KarolKaim/-masterThesis/README.md

# -masterThesis
This repository track the whole process of writing masterThesis
