KarolKaim/-masterThesis/usefulDocuments/listaZakopow.odt

Lista zakupów:

1. Przyciski
- 2x rezystory 330, 33k
- 2x kondensatory ~470 nF
- Przewód dwużyłowy 4 m
- płytka do lutowania
2. Zasilanie
- pakiet lipo 2s
- przewody men-men krótkie
- przewód do serwomechanizmu
3. Magnesy
- 2x rezystor 330, 10k
- 2x kondenstator 100nF
6. sdf
