KarolKaim/-masterThesis/usefulDocuments/komplementarny.pdf

### Katedra Cybernetyki i Robotyki, Wydział Elektroniki

Seria: SPR nr 3/2014
— Grant S30080 —

Filtracja komplementarna
w inercyjnych czujnikach orientacji

Marek Wnuk

Słowa kluczowe:
orientacja,
zyroskop, ˙
akcelerometr,
dalmierz,
mikrokontroler,
filtracja.

Wrocław, 2014-09-25

### Spis tresci ´

1 Wprowadzenie | 3

### 2 Przegl ֒

ad czujnikow scalonych ´ | 3
2.2 Zyroskopy | | 3 ˙
2.4 Czujniki cisnienia | | 4 ´
3 Filtry uzywane do pomiaru orientacji ˙ | 5
4 Przykłady realizacji czujnikow orientacji ´ | 6

4.2 Przykład 2D - samopoziomuj ֒

aca si֒

### 5 Czujnik pochylenia platformy dwukołowej wzgl֒

edem podłoza | 11 ˙
6 Podsumowanie | 14

### 1 Wprowadzenie

Pomiar orientacji jest konieczny do sterowania robotami mobilnymi. W szczegolny spos ´ | ob dotyczy ´
to obiektow lataj ´
֒

acych, poruszaj ֒

acymi si֒

e w przestrzeni trojwymiarowej. W takim przypadku korzy- ´ sta si֒

e z systemu AHRS (ang. Attitude and Heading Reference System). Jest on oparty na całkowaniu chwilowych pr֒

edkosci k ´
֒

atowych zmian orientacji, mierzonych przy pomocy zyroskop ˙ ow. Jako po- ´ miary bezwzgl֒

edne orientacji mozna wykorzysta ˙ | c azymut magnetyczny mierzony magnetometrami ´
oraz kierunek siły grawitacji mierzony akcelerometrami. W tym przypadku mowimy o systemie czuj- ´
nikow MARG (ang. ´ | Magnetic, Angular Rate, and Gravity), a urz ֒

adzenie, ktore je zawiera jest zwane ´ IMU (ang. Inertial Measurement Unit).
W praktyce robotycznej cz ֒

esto mamy do czynienia z ograniczeniem wymiaru przestrzeni do dwoch ´ lub nawet jednego, co prowadzi do uproszczenia zadania pomiaru orientacji. Przykładem problemu dwuwymiarowego jest pomiar pochylenia platformy mobilnej poruszaj ֒

acej si֒

e po płaszczyznie, a ´
jeden stopien swobody pozostaje w przypadku pomiaru pochylenia korpusu ´ | robota balansuj ֒
acego.

### 2 Przegl ֒

### ad czujnikow scalonych ´

Czujniki mikroelektromechaniczne (MEMS - ang. Micro Electro-Mechanical Systems) s ֒

a uzywane ˙
głownie do pomieru pr ´
֒
edkosci i przyspiesze ´ | n. S ´
֒

a one coraz powszechniej dost֒

epne w ofercie wiod ֒

acych producentow układ ´ ow scalonych. Dost ´
֒

epne s ֒

a tez czujniki pola magnetycznego (magnetometry) ˙ i czujniki cisnienia (barometry, altimetry). ´ Powszechnie stosuje si֒

e ł ֒

aczenie roźnych funkcji w jednym układzie, co pozwala zmniejszy ˙ | c roz- ´
miary urz ֒
adzen oraz pob ´ | or energii. Dost ´
֒

epne s ֒

a roźne kombinacje (akcelerometr + ˙ | zyroskop, akcele- ˙
rometr + magnetometr, akcelerometr + zyroskop + magnetometr). Wsp ˙ | ołczesne czujniki o wyj ´ | sciach ´
cyfrowych wyposazone s ˙
֒

a we wbudowane programowalne filtry antyaliasingowe a cz ֒

esto zawieraj ֒

a
własn ֒

a jednostk ֒

e obliczeniow ֒

a, pozwalaj ֒

ac ֒

a zaimplementowac wybrany algorytm obliczania orien- ´ tacji bezposrednio w układzie (np. MPU6050 [27]) ´

### 2.1 Akcelerometry

Pomiar przyspieszenia odbywa si֒

e przez pomiar pojemnosci kondensatora wytworzonego w mono- ´ litycznym krzemie. Jego okładki przesuwaj ֒

a si֒

e wzgl֒

edem siebie przy odkształceniu elementow´ spr֒

ezystych pod wpływem siły działaj ˙
֒

acej na mas֒

e. Sygnał wyjsciowy akceleromtru mo ´ | ze by ˙ | c analo- ´
gowy lub cyfrowy. Typowe synchroniczne interfejsy cyfrowe to SPI (ang. Serial Peripheral Interface) i IIC (ang. Inter-Integrated Circuit). Przykładowe akcelerometry to ADXL345 [13], MMA8652FC [25].

### 2.2 Zyroskopy ˙

Pomiar pr֒

edkosci obrotowej opiera si ´
֒

e na zjawisku siły Coriolisa, wynikaj ֒

acej ze złozenia dw ˙ | och ´
ruchow pewnej masy, z kt ´ | orych co najmniej jeden jest obrotowy. W akcelerometrach ME ´ | MS jednym
ze składowych ruchow s ´
֒

a drgania elementu struktury czujnika wymuszone dzi֒

eki efektowi piezoelek-
trycznemu. Wartosć siły Coriolisa jest mierzona analogicznie jak w akcelerome ´ | trze, podobne s ֒

a tez˙
interfejsy obu rodzajow czujnik ´ | ow. Przykłady ´ | zyroskop ˙ | ow to L3G4200 [20], MAX21000 [24]. ´

### 2.3 Magnetometry

Do pomiaru kierunku i nat֒ ezenia pola magnetycznego Ziemi stosuje si ˙
֒

e czujniki magnetorezystywne, oparte na efekcie Gaussa (Thomsona). Wyst֒

epuj ֒

a one w postaci układow scalonych, najcz ´
֒

esciej ´
zapewniaj ֒

acych pomiar trzech prostopadłych składowych wektora. Ich inerfejsy s ֒

a analogiczne, jak
w czujnikach inercyjnych. Popularne magnetometry to np. HMC5883L [18], MAG3110 [23].

### 2.4 Czujniki cisnienia ´

Czujniki bezwzgl֒

edne cisnienia korzystaj ´
֒

a ze zjawiska piezorezystywnego. Po jednj stronie krzemowej membrany jest proźnia, na drug ˙
֒

a działa mierzone cisnienie. wynik pomiaru jest udost ´
֒

epniany
w postaci napi֒

eciowej, a coraz cz ֒

asciej dodatkowo filtrowany i przekazywany przez SPI lub IIC. ´ Cz ֒

esto spotyka si֒

e dodatkowo pomiar temperatury. Przykłady takich czujnikow to BMP085 [14], ´ MPL3115A2 [26].

### 2.5 Moduły IMU

IMU (ang. Inertial Measurement Unit) zawiera czujniki dostarczaj ֒

ace pomiarow wielko ´ | sci fizycz- ´
nych okreslaj ´
֒

acych parametry połozenia, pr ˙
֒
edkosci i przyspiesze ´ | n, kt ´ | orym podlega wyposa ´ | zony w ˙
nie obiekt. Pozwala to na obliczanie aktualnej orientacji i połozenia. ˙
Czujniki te, to zazwyczaj akcelerometry, zyroskopy, magnetometry. Ka ˙ | zdy z nich mo ˙ | ze da ˙ | c informa- ´
cje trojwymiarow ´
֒

a (3D), co razem daje 9 stopni swobody (9 DOF - Degrees of Freedom). Na rys. 1 przedstawiono testowane moduły IMU. Po lewej mamy popularny magnetometr HMC5883L (3DOF) i moduł GY-521 z układem MPU6050 [27] (3DOF akcelerometr i 3DOF zyroskop). W ˙ srodku znajduje si ´
֒

e moduł GY-80 (10DOF) z trojwymiarowymi czujnikami przyspieszenia (ADXL345), ´ pr֒

edkosci obrotowej (L3G4200), pola magnetycznego (HMC5883L) ora ´ | z cisnienia (BMP085). Po ´
prawej znajduje si֒ | e moduł z układem z rodziny iNEMO (LSM9DS0) [21], dostarczaj ֒

acym pomiarow´
przyspieszenia, pr֒

edkosci obrotowej i pola magnetycznego (9 DOF). ´

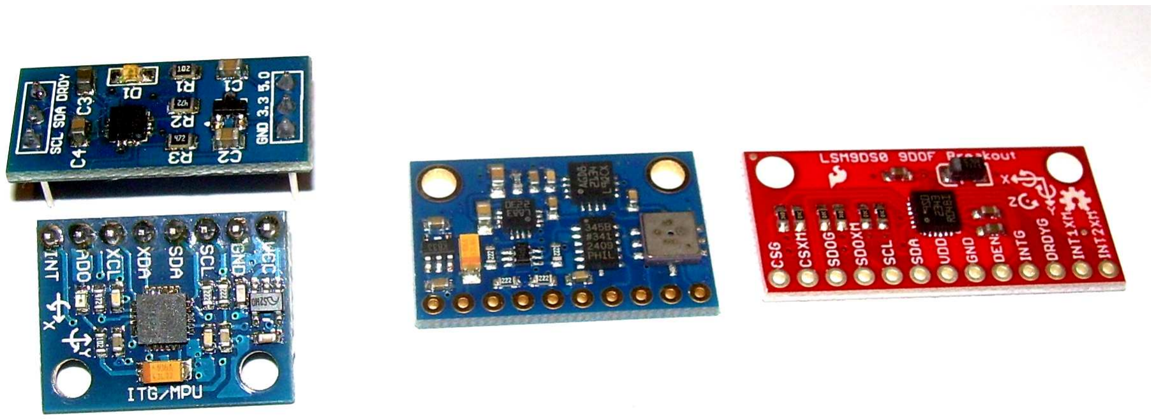
[picture p34: figure]

Rysunek 1: Moduły IMU uzywane w badaniach ˙

Dziesi ֒

atym stopniem swobody nazywa si֒ e w popularnych zastosowaniach wysokosć nad poziomem ´ morza (ang. Altitude), mierzon ֒

a bezwzgl֒

ednym czujnikiem cisnienia atmosferycznego. ´

### 3 Filtry uzywane do pomiaru orientacji ˙

Pomiar orientacji na podstawie odczytu sygnałow z kilku czujnik ´ | o´w (w pełnym zakresie obejmuje to ´
trzy czujniki 3D - akcelerometr, zyroskop i magnetometr) wymaga dokonywania filtracji zakł ˙ | oce ´ n o ´
roźnym charakterze i fuzji danych. W ˙ | sr´ od wielu podej ´ | sć do tego problemu najcz ´
֒

esciej spotyka si ´
֒

e
filtr Kalmana, filtr komplementarny i filtr Madgwicka.

### 3.1 Filtr Kalmana

Filtr Kalmana [11] dokonuje iteracyjnej estymacji procesu w układzie ze sprz ֒

ezeniem zwrotnym. W ˙
kadym kroku wykonywane s naprzemiennie dwie operacje: estymacja stanu procesu i sprz ֒

ezenie ˙
zwrotne w postaci pomiarow zaburzonych szumem. ´
Faza predykcji stanu (aktualizacja czasowa) estymuje kolejny, przewidywany stan i okresla estymat ´
֒

e
kowariancji bł֒

edu, daj ֒

ac estymat֒

e a priori.
Faza korekcji (aktualizacja pomiarowa) wykorzystuje biez˙
֒

ace pomiary by uzyskac poprawion ´
֒

a estymat֒

e a posteriori.
Filtr Kalmana jest od dawna uzywany przy fuzji danych sensorycznych, zwłaszcza w zastos ˙ | owaniach
do nawigacji powietrznej [3]. Wspołczesne implementacje s ´
֒

a rownie ´ z popularne [6, 16, 1]. ˙

### 3.2 Filtr Madgwicka

W 2010 roku R. Madgwick opublikował raport [7], w ktorym przedstawił zar ´ | owno teori ´
֒

e, jak i elementy implementacji nowego filtru dla IMU i MARG. Jest on oparty na kwaternionowej reprezentacji obrotow. Zawiera on kompensacj ´
֒

e zniekształcen dla magnetometru i kompensacj ´
֒

e dryfu zyroskopu. ˙
Wykorzystuje analitycznie wyprowadzony i zoptymalizowany algorytm najszybszego spadku w celu wyznaczenia kierunku bł֒
| edu zyroskopu przez r ˙ | oźniczkowanie kwaternionu. ˙
Przedstawione wyniki wskazuj ֒
| | a na zalety tej metody (mały koszt obliczeniowy, efektywnosć przy ´
niewielkiej cz ֒
estotliwosci pr ´ | obkowania, łatwo ´ | sć strojenia algorytmu - 1 lub 2 parametry). ´
Autor dol ֒

aczył rownie ´ z swoj ˙
֒

a implementacj֒

e filtru Mahony, na ktorym si ´
֒

e w pewnym zakresie wzorował [8]. Oprogramowanie tej implementacji jest dost֒

epne na stronie [29].

### 3.3 Filtr komplementarny

Idea filtru komplementarnego [3] polega na fuzji danych z dwoch czujnik ´ | ow, z kt ´ | orych ´ | zaden nie jest ˙
idealny.
W przypadku jednego z nich mamy do czynienia z szybkozmiennymi zakłoceniami, kt ´ | orych odfiltro- ´
wanie filtrem dolnoprzepustowym wprowadza do mierzonego sygnału opoźnienie. ´
Drugi z czujnikow jest obarczony bł ´
֒

edem wolnozmiennym (dryf). Tu rozwi ֒

azaniem jest filtracja
gornoprzepustowa, kt ´ | ora jednak usuwa r ´ | ownie ´ | z u ˙ zyteczne składowe wolnozmienne pomiaru (w tym ˙
składow ֒

a stał ֒

a).
Kombinacja obu odfiltrowanych pomiarow pozwala zachowa ´ | c dobre wyniki. Składowe wolnozmienne ´
s
֒

a odtwarzane z pierwszego, a szybkozmienne - z drugiego sensora.
W przypadku IMU i estymacji orientacji, pierwszy typ czujnikow to akcelerometr (podlegaj ´
֒

acy
zakłoceniom wynikaj ´
֒

acym z wibracji i ruchu obiektu) lub magnetometr (zakłocany przez pola magne- ´ tyczne nap ֒

edow itp.). Drugi typ to zyroskop, kt ˙ | ory na skutek niestabilno ´ | sci zera daje przy całkowaniu ´
pr֒
edkosci dryf poło ´ | zenia k ˙
֒

atowego.

Implementacja filtru komplementarnego [6], uzywana w opisywanych zastosowaniach, wykorzystuje ˙ iteracyjne docałkowywanie sygnału pr֒

edkosci ´ ωn do aktualnej estymaty połozenia ˙ | αn−1 z zastosowa-
niem kombinacji wypukłej z parametrem ε z aktualnym pomiarem połozenia ˙ | an:
αn = (1−ε)(αn−1 +τcωn) +εan, | (1)

gdzie τc odpowiada okresowi probkowania. ´
Warto zauwazy˙ c,´ ze gdy ˙ ωn → 0 (przy bardzo małych pr֒
edkosciach obrotowych) uzyskujemy: ´
αn = (1−ε)αn−1 +εan, | (2)
co odpowiada filtracji dolnoprzepustowej pomiaru połozenia ˙ | an przez człon inercyjny o stałej czaso-
wej:
T = −

τc
ln(1−ε)
. | (3)

Wyniki działania tego filtru zostan ֒ a pokazane przy okazji prezentacji projektow, kt ´ ore z niego korzy- ´ staj ֒

a.

### 4 Przykłady realizacji czujnikow orientacji ´

Czujniki orientacji znajduj ֒

a zastosowania w roźnych projektach robotycznych. W pracach badaw- ˙ czych i konstrukcyjnych bior ֒

a udział studenci specjalnosci Robotyka prowadzonej przez Katedr ´
֒

e Cybernetyki i Robotyki (W4/K7) Politechniki Wrocławskiej. W niektorych przypadkach owocuje to ´
projektami inzynierskimi. Elementy tych projekt ˙ | ow, zwi ´
֒

azane z pomiarem orientacji, zostan ֒

a przedstawione ponizej. ˙

### 4.1 Przykład 3D - system AHRS

Zaprojektowano i przebadano [2] prototyp sterownika do autonomicznego samolotu typu ,,lataj ֒

ace
skrzydło” (rys. 2). Jego waznym blokiem jest układ AHRS. Wykorzystano moduł IMU 10DOF za ˙ | wie-
raj ֒
acy akcelerometr i zyroskop MPU6050, magnetometr HMC5883L oraz czujnik ci ˙ | snienia BMP085. ´
Dodatkowe czujniki pozwalaj ֒

a na pomiar dodatkowych parametrow otoczenia i lotu (pr ´
| ֒

edkosć wzgl ´
֒

e-
dem powietrza, wilgotnosć itp.). Układ jest wyposa ´ | zony w odbiornik GPS i interfejsy do komunikacji ˙
z innymi podsystemami. Jego waznym blokiem jest układ AHRS. Wykorzystano moduł IMU 10DOF ˙ zawieraj ֒
acy akcelerometr i zyroskop MPU6050, magnetometr HMC5883L oraz czujnik ci ˙ | snienia ´
BMP085. Dodatkowe czujniki pozwalaj ֒ | a na pomiar innych parametrow otoczenia i lotu (pr ´ ֒

edkosć´
wzgl֒
edem powietrza, wilgotnosć itp.). Układ jest wyposa ´ | zony w odbiornik GPS i interfejsy do ko- ˙
munikacji z innymi podsystemami.
Jako mikroprocesor wykorzystano Kinetis K60 [19] z rdzeniem ARM Cortex4M z koprocesorem zmiennoprzecinkowym. Prototyp zmontowano wykorzystuj ֒

ac system TOWER [30] (rys. 3). Zaimplementowano algorytm wyliczania orientacji z IMU 9DOF, oparty na rachunku kwaternionow, ´ z prezentacj ֒

a orientacji w postaci k ֒ atow Eulera (R-P-Y). Przykładowe wyniki pokazano na rys. 4. ´
Os czasu jest skalowana w numerach pr ´ | obek (okres ok. 10ms). Prbki 20-60 - wolny obr ´ | ot Roll do ´
pozycji odwroconej, 60-100 - zatrzymanie i powr ´ | ot, 120-130 - pochylenie na dzi ´ | ob do k ´ ֒
ata ok. 45
stopni, 130-170 - zatrzymanie i powrot do poziomu, 190-260 - wykonanie pełnego obrotu wok ´ | oł osi ´
pionowej (około 230. probki – zmiana z k ´
֒

atow ujemnych na dodatnie). ´

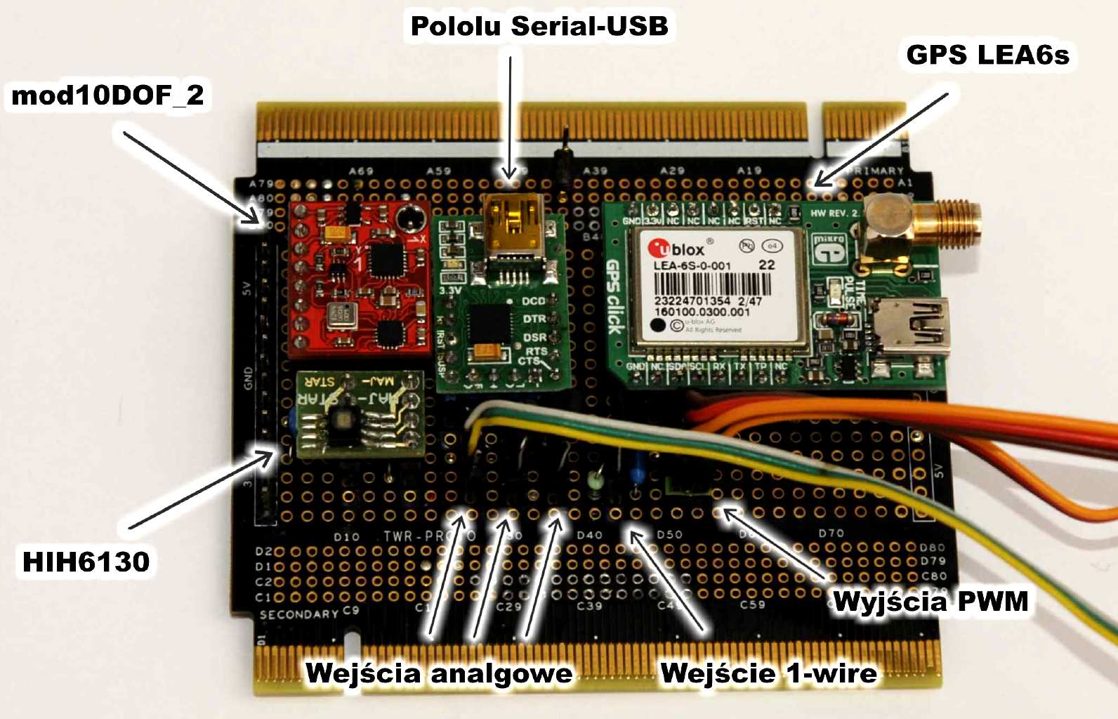
[picture p35: figure]

Rysunek 2: Prototyp układu [2]

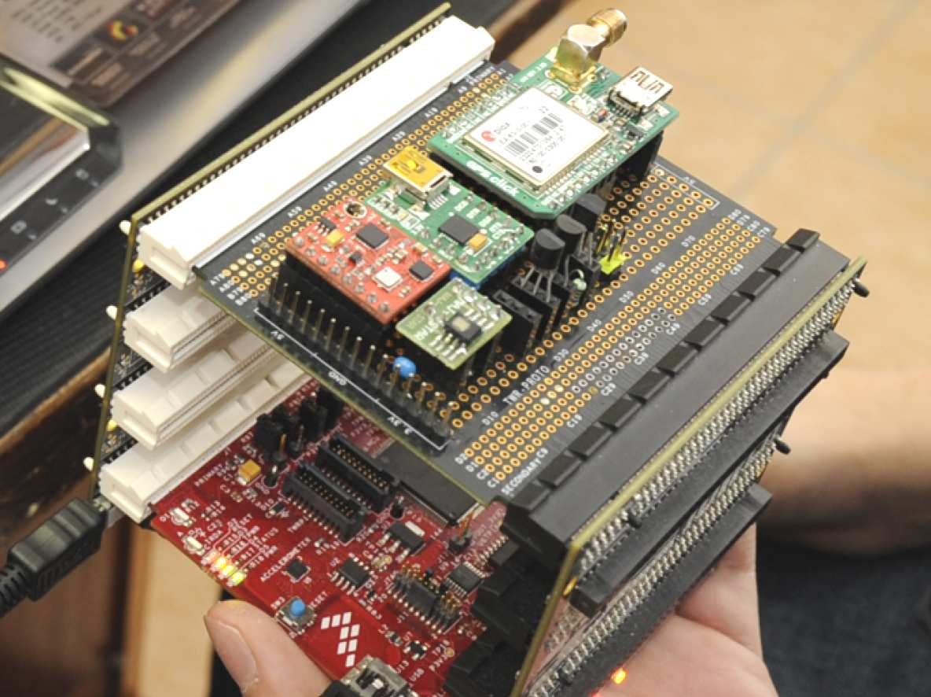
[picture p36: figure]

Rysunek 3: Zestaw Tower z mikrokontrolerem K60 [2]

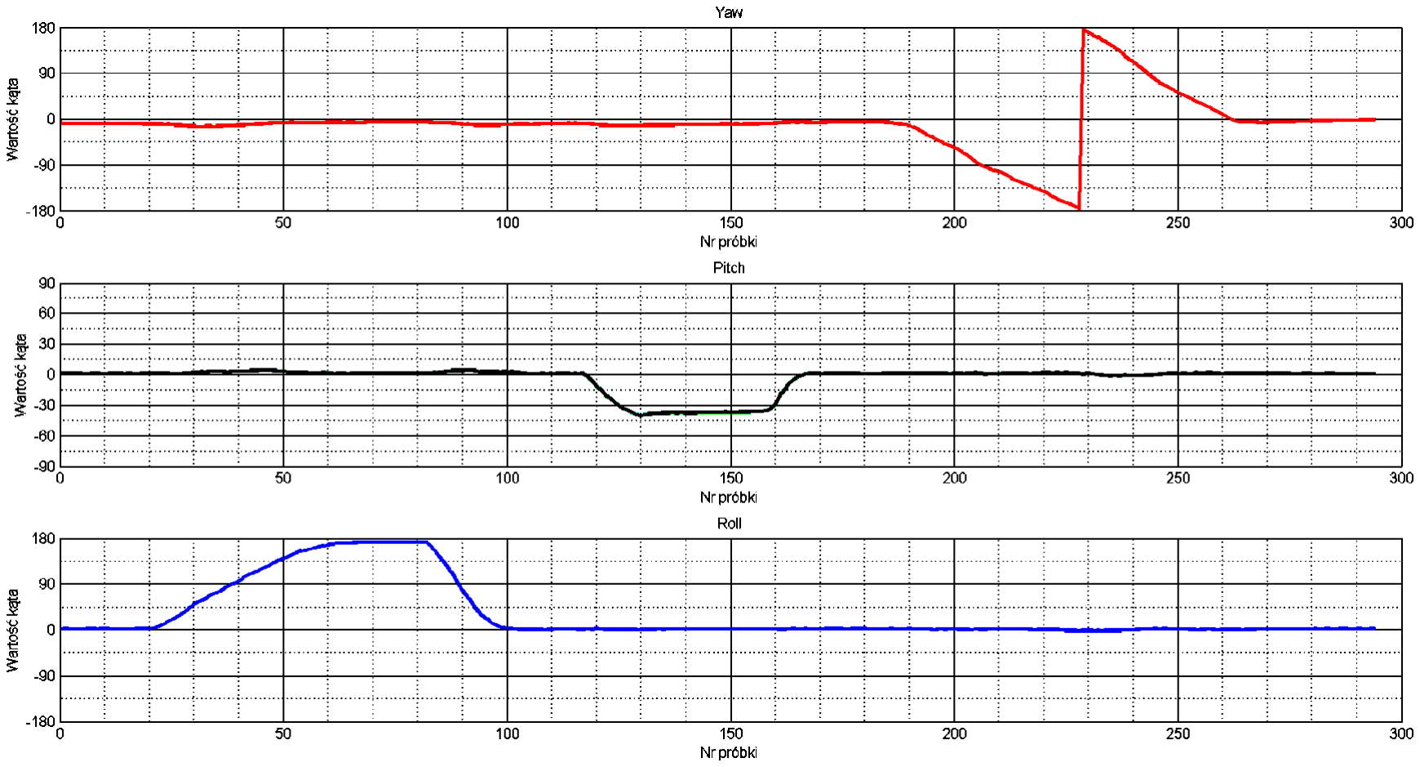
[picture p37: figure]

Rysunek 4: Odczyty orientacji 3D [2]

### 4.2 Przykład 2D - samopoziomuj ֒

aca si֒

e platforma
W pracy [4] zaprojektowano i zbadano układ reguluj ֒
acy poziome połozenie platformy o dw ˙ | och obro- ´
towych stopniach swobody, wzgl֒

edem wzajemnie prostopadłych poziomych osi (rys. 5). Do pomiaru

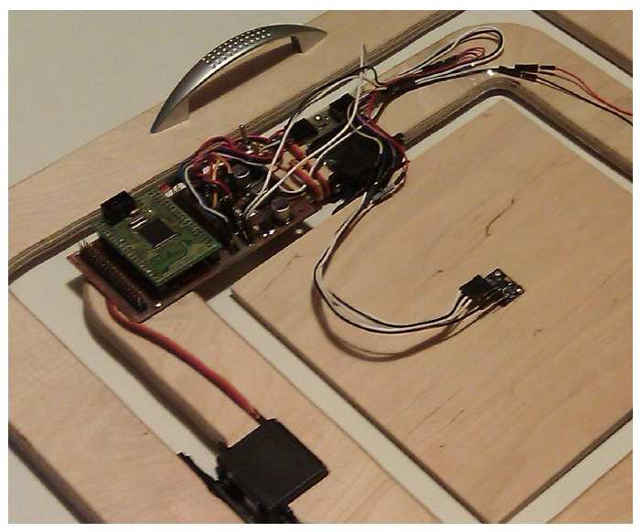
[picture p38: figure]

Rysunek 5: Prototyp układu [4]

orientacji wykorzystano moduł GY-521, zawieraj ֒ acy akcelerometr i zyroskop MPU6050. Jako jed- ˙ nostk ֒

e centraln ֒

a zastosowano moduł z 16-bitowym mikrokontrolerem 9S12 [5]
Mozliwy jest niemal bezpo ˙ | sredni pomiar dw ´ | och k ´
֒

atow ( ´ ax,ay) pochylenia na podstawie danych z akcelerometru:
ax = arctg

gY
gZ
, | (4)

ay = arctg

gX
gZ
, | (5)

gdzie gX,gY ,gZ s
֒

a składowymi wektora grawitacji mierzonymi przez akcelerometr 3D. Pomiar ten jest bezwzgl֒

edny, jest on jednak obarczony znacznymi szumami wysokocz ֒

estotliwosciowymi. ´
Inne zr´ odło danych to ´ | zyroskop. Odczyty pr ˙
֒

edkosci k ´
֒

atowych wgl֒

edem obu osi (ωX,ωY ) musz ֒ a
zostac scałkowane: ´

ax(ti) = ax(0) +

i
∑

j=1

ωX(tj)(tj ⁻tj−1), | (6)

ay(ti) = ay(0) +

i
∑

j=1

ωY (tj)(tj ⁻tj−1). | (7)
Niedokładnosć zera ´ | zyroskopu powoduje dryf, kt ˙ | ory trzeba kompensowa ´ | c przy pomocy odpowied- ´
niego filtru.

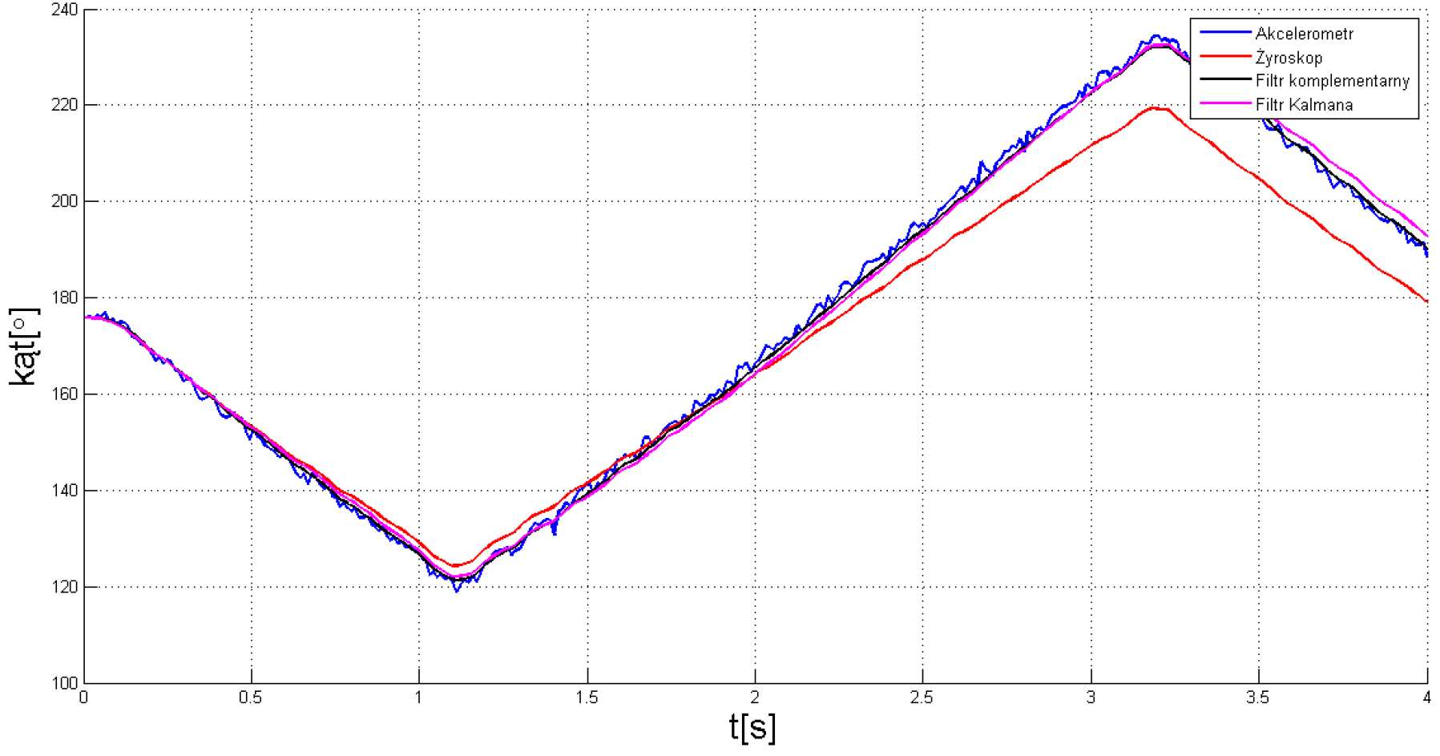
[picture p39: figure]

Rysunek 6: Odczyty orientacji przy ruchach powolnych [4]

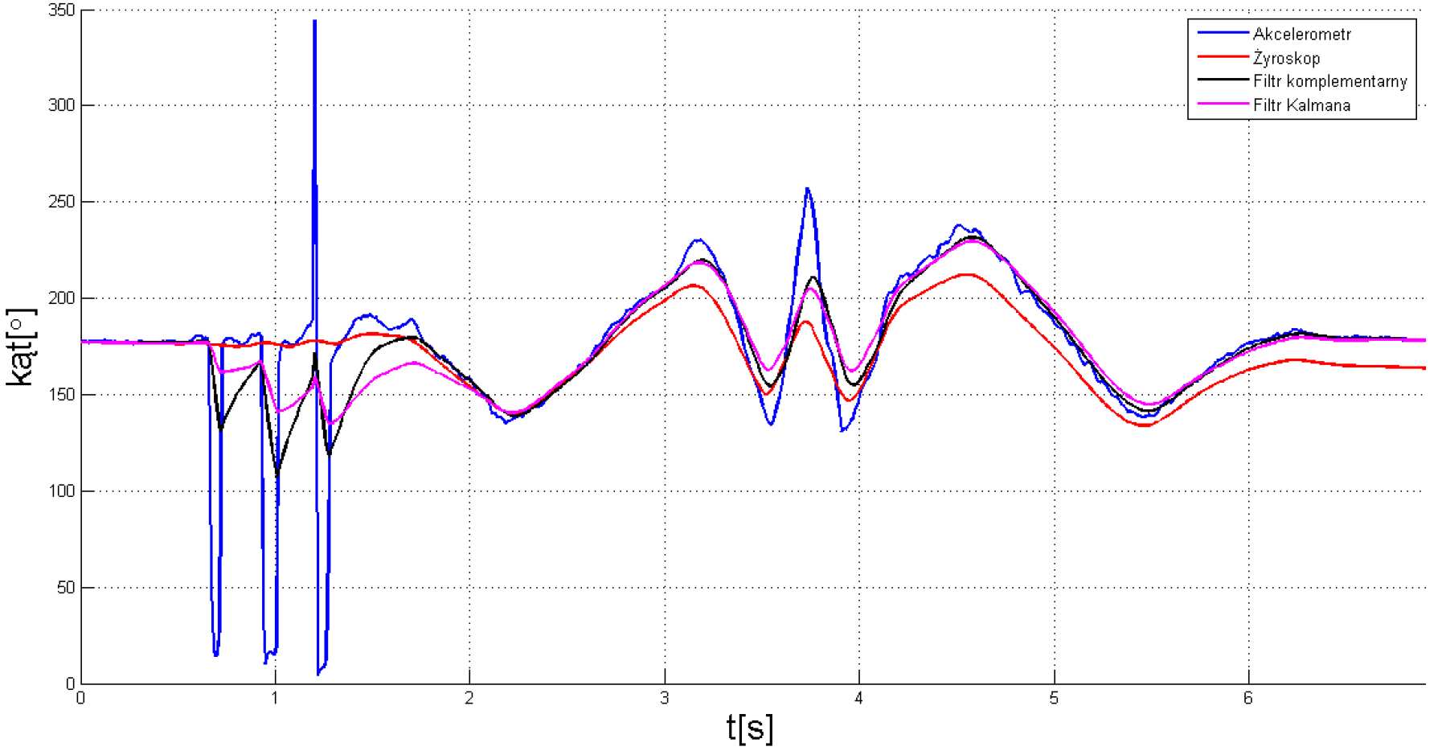
[picture p40: figure]

Rysunek 7: Odczyty orientacji przy ruchach szybkich [4]

Do filtracji zastosowano zarowno filtr Kalmana, jak i filtr komplementarny. Przykładowe w ´ | yniki
pomiarow orientacji przedstawiono na rys. 6 i 7. ´
W przypadku ruchow powolnych filtr komplementarny zachowuje si ´
֒

e podobnie jak filtr Kalmana.
Minimalne roźnice wida ˙ | c przy ruchach bardzo szybkich. Oba filtry znakomicie usuwaj ´
֒

a zarowno ´
szybkozmienne zakłocenia z akcelerometru, jak i dryf ´ | zyroskopu. ˙

### 4.3 Przykład 1D - orientacja myszy w labiryncie

W pracy [10] zaprojektowano i zbadano czujniki pozwalaj ֒

ace robotowi klasy Micromouse (rys. 8) porusza si֒

e w labiryncie. Jednym z waznych zada ˙ | n jest w tym przypadku odpowiednie zachowywanie ´
orientacji wzgl֒

edem osi pionowej.
Zazwyczaj stosuje si֒

e do tego celu całkowanie sygnału pr֒

edkosci k ´
֒

atowej z zyroskopu. W przy- ˙ padku opisywanego robota był to układ LY3200ALH, z wyjsciem napi ´
֒

eciowym [22]. Jego wyjscie ´ podł ֒

aczono do wejscia przetwornika ADC mikrokontrolera pokładowego (STM32 ´ | F103RBT6 z rdze-
niem ARM Cortex [28]).
Dodatkowym wyposazeniem dla robota (zbudowanego i uruchomionego wcze ˙ | sniej) stał si ´ ֒
e magnetometr 3D, moduł z układem FXOS8700CQ [17]. Dzi֒

eki niemu mozliwe stało si ˙
֒

e wyznaczanie
biez˙
֒

acego kierunku wektora pola magnetycznego Ziemi, a wi֒

ec – bezwzgl֒

ednej orientacji robota.

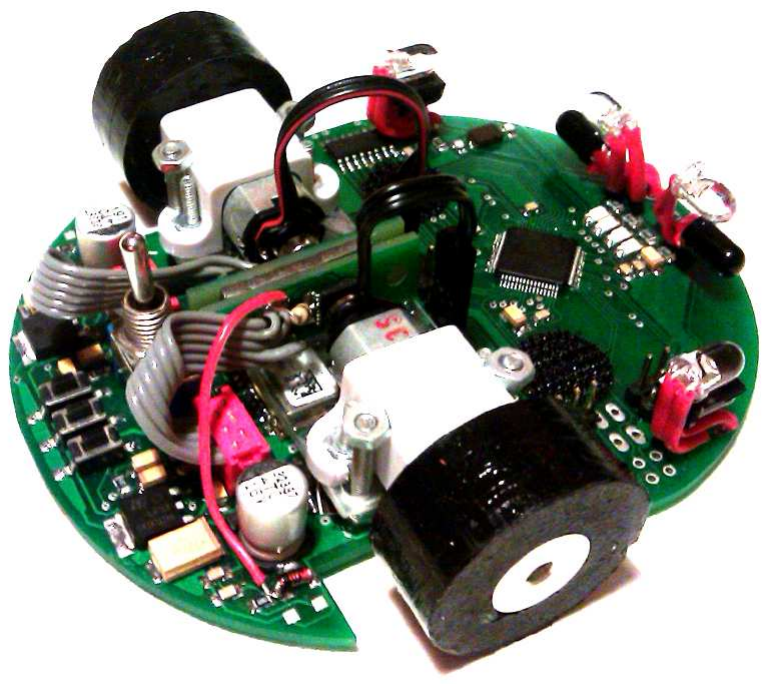
[picture p41: figure]

Rysunek 8: Robot klasy Micromouse [10]

Wprawdzie pomiar ten jest obarczony szybkozmiennymi zakłoceniami powodowanymi przez układy ´ nap ֒

edowe, ale nadaje si֒

e do wykorzystania w celu kompensowania dryfu zyroskopu. ˙ Podobnie jak w porzednim przypadku, zastosowano zarowno filtr Kalmana, jak i filtr komplemen- ´ tarny. Wyniki zaprezentowano na (rys. 9).

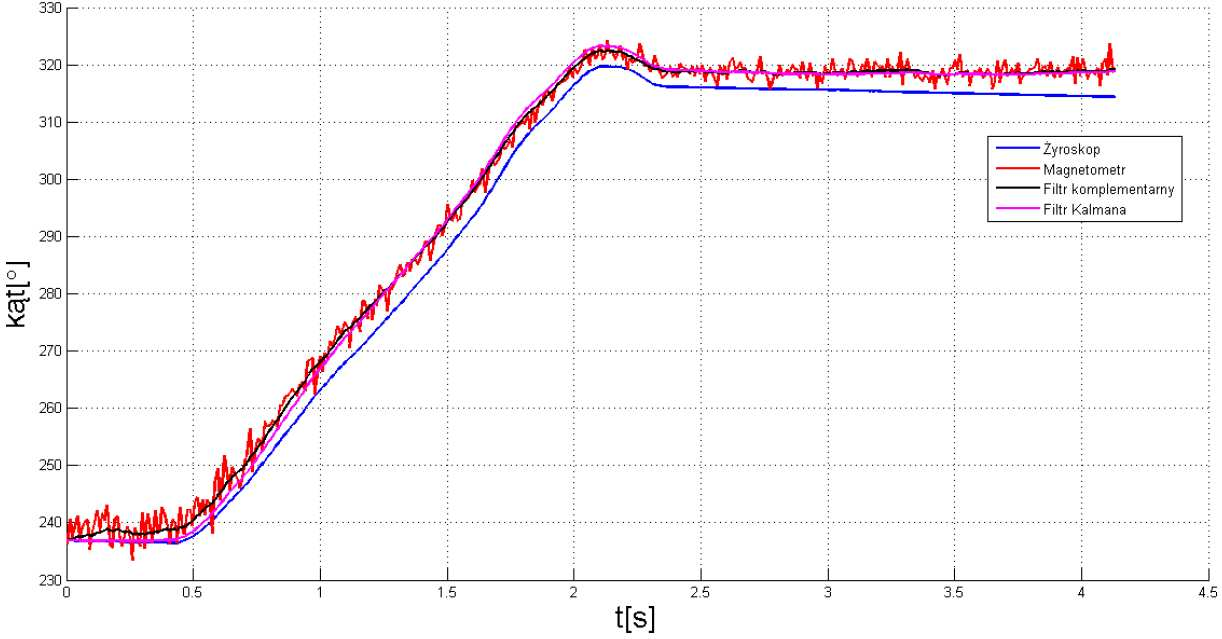
[picture p42: figure]

Rysunek 9: Odczyty orientacji 1D [10]

Widac,´ ze dryf całkowania pr ˙
֒

edkosci z ´ zyroskopu jest przez oba filtry usuni ˙
֒

ety, a zakłocenia szybko- ´ zmienne - istotnie osłabione.

### 5 Czujnik pochylenia platformy dwukołowej wzgl֒

### edem podłoza˙

W raporcie [12] przedstawiono koncepcj֒

e i realizacj֒

e pomiaru orientacji korpusu roborta balansuj ֒

acego wzgl֒

edem podłoza pzy pomocy dw ˙ | och dalmierzy. Dla podło ´ | za poziomego, co jest typow ˙
֒

a
sytuacj ֒

a dla robotow pracuj ´
֒

acych we wn ֒

etrzach, mozna w ten spos ˙ | ob uzyska ´ | c orientacj ´
֒

e wzgl֒

edem
osi kol robota, czyli jego odchylenie od pionu. ´

### 5.1 Idea pomiaru

Na rysunku 10 pokazano ide ֒

e układu pomiaru k ֒

ata α pomi֒
edzy korpusem robota a normaln ֒

a do
podłoza. Dwa czujniki odległo ˙ | sci (dalmierze) s ´
֒

a umieszczone symetrycznie na korpusie robota (po
przeciwnych stronach osi jego koł)i skierowane r ´ | ownolegle do osi korpusu, w kierunku podło ´ | za. ˙
Odległosć od podło ´ | za w poło ˙ | zeniu pionowym jest dobrana tak, by mo ˙ | zliwy był pomiar odległo ˙ | sci ´
orzy odchylaniu korpusu robota od pionu w z˙
֒

adanym zakresie k ֒

atow (w pracy przyj ´
֒

eto maksymalne
odchylenie rowne 45 ´

o
).

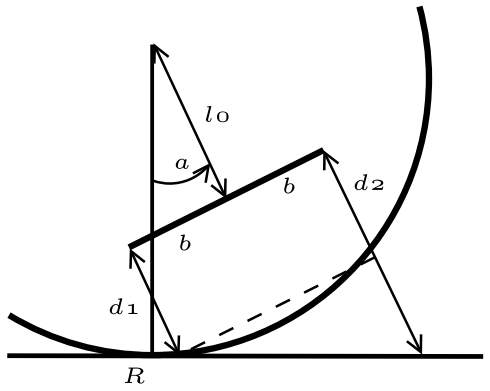
[picture p43: figure]

Rysunek 10: Idea czujnika odchylenia
Przez R oznaczono promien k ´ oł, przez ´ | l0 – wysokosć umieszczenia czujnik ´ | ow ponad osi ´
֒

a

1
, przez b
– połow֒
e rozstawu czujnikow w stosunku do płaszczyzny symetrii korpusu, przez ´ | d1 i d2 – pomiary
odległosci z obu dalmierzy. ´
Roźnica obu pomiar ˙ | ow odległo ´ | sci pozwala wyznaczy ´ | c k ´
֒

at nachylenia:

α = arctan

∆d
2b

(8)

### 5.2 Charakterystyki dalmierzy

Zastosowany dalmierz GP2D120 (rys. 11) ma silnie nieliniow ֒

a, hiperboliczn ֒

a zalezno ˙ sć napi ´
֒

ecia
wyjsciowego od mierzonej odległo ´ | sci, łatw ´
֒

a do zamodelowania w postaci funkcji wymiernej z trzema parametrami (12).
Dalmierze te maj ֒

a nast֒

epuj ֒

ace wady:
- Okres pomiarowy wynosi około 40ms (cz ֒ estotliwosć pomiar ´ ow ok. 25Hz). ´

1Gdy czujniki s ֒
a umieszczone ponizej osi, ˙ l0 < 0

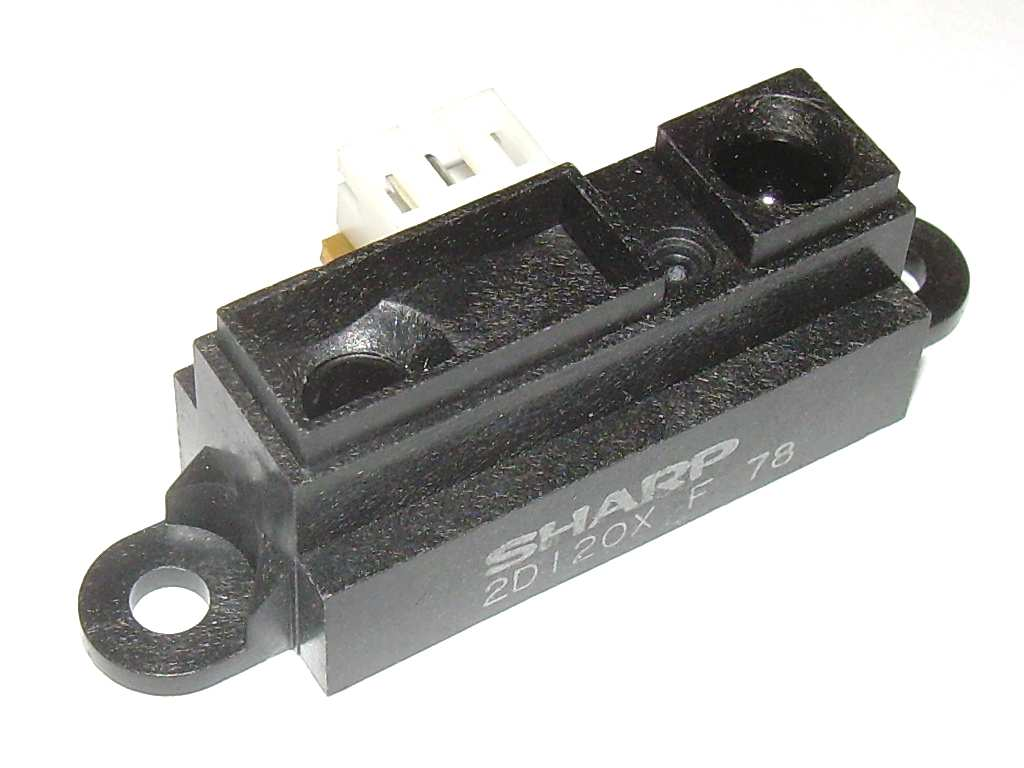
[picture p44: figure]

Rysunek 11: Czujniki odległosci odpodło ´ | za˙

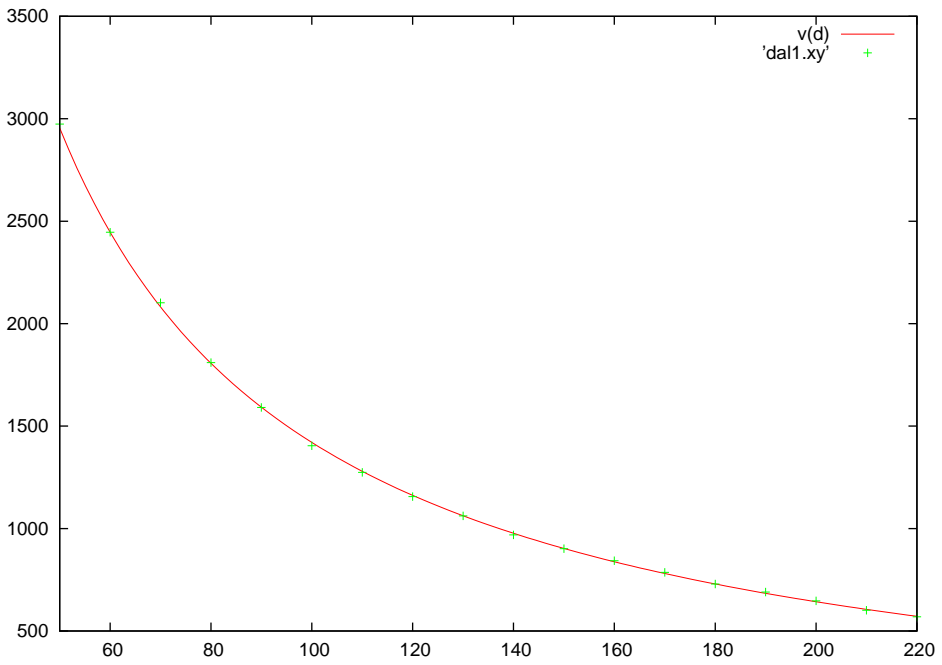
[picture p45: figure]
v(d) ’dal1.xy’

Rysunek 12: Charakterystyka dalmierza SHARP GP120

- Nie ma mozliwo ˙ | sci zsynchronizowania ich pracy (wyzwalania pomiar ´ | ow). ´
- Konieczna jest filtracja pomiarow i eliminacja bł ´
֒

edow spowodowanych brakiem synchronizacji. ´

### 5.3 Stanowisko badawcze

Opisany układ pomiarowy dostarcza bezwzgl֒

ednej, choc zakł ´ oconej informacji o orientacji korpusu ´ wzgl֒

edem osi kol robota. W celu zbadania przydatno ´ | sci filtracji komplementarnej do poprawie- ´
nia jakosci pomiaru wystarczy wykorzysta ´ | c całkowanie pr ´
֒

edkosci k ´
֒

atowej mierzonej zyroskopem ˙ MEMS.
W tym celu rozbudowano (rys. 13) stanowisko badawcze opisane w [12] o moduł zawieraj ֒

acy układ
MPU6050 (z ktorego wykorzystano tylko o ´ | s´ ωZ zyroskopu). ˙

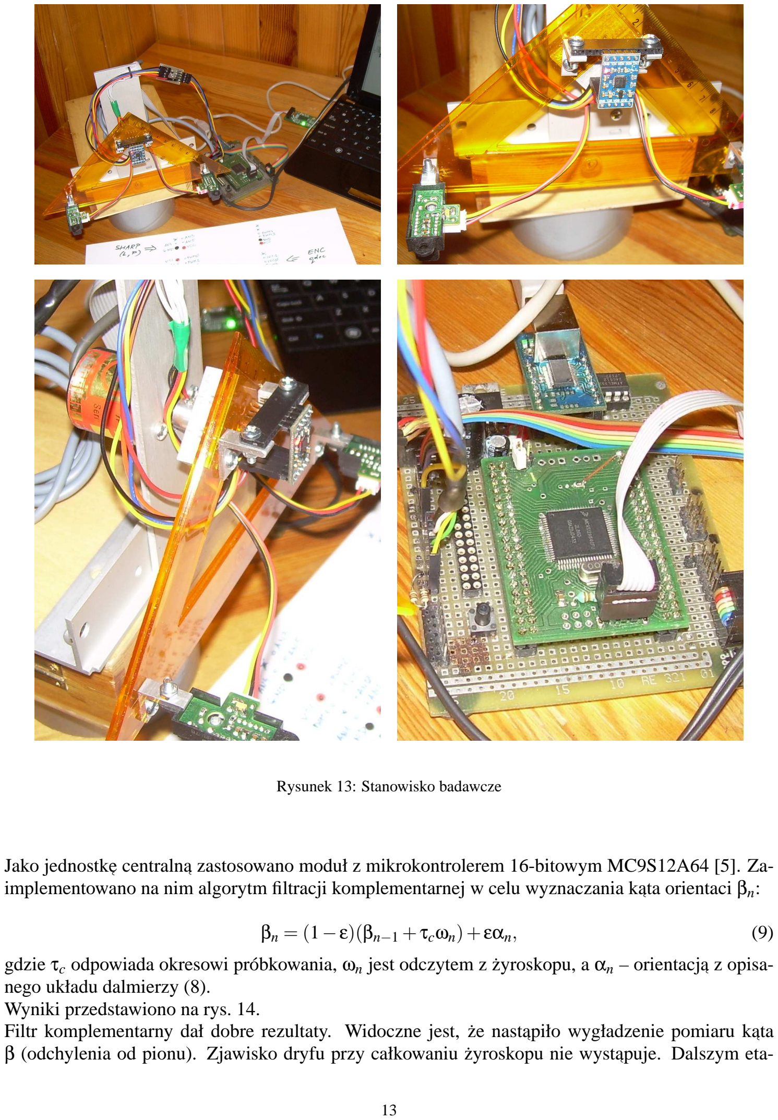
[picture p46: page 14]

Rysunek 13: Stanowisko badawcze

Jako jednostk ֒

e centraln ֒

a zastosowano moduł z mikrokontrolerem 16-bitowym MC9S12A64 [5]. Zaimplementowano na nim algorytm filtracji komplementarnej w celu wyznaczania k ֒

ata orientaci βn:

βn = (1−ε)(βn−1 +τcωn) +εαn, | (9)
gdzie τc odpowiada okresowi probkowania, ´ | ωn jest odczytem z zyroskopu, a ˙ | αn – orientacj ֒ a z opisa-
nego układu dalmierzy (8).
Wyniki przedstawiono na rys. 14.
Filtr komplementarny dał dobre rezultaty. Widoczne jest, ze nast ˙
֒

apiło wygładzenie pomiaru k ֒

ata
β (odchylenia od pionu). Zjawisko dryfu przy całkowaniu zyroskopu nie wyst ˙
֒

apuje. Dalszym eta-

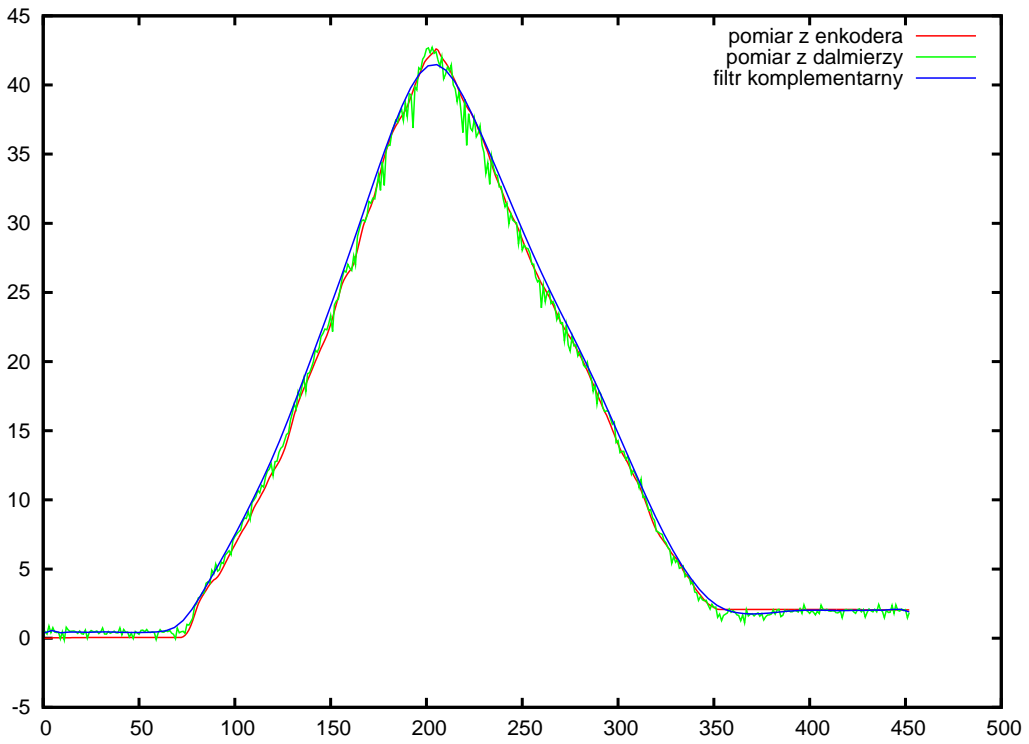
[picture p47: figure]
pomiar z enkodera pomiar z dalmierzy filtr komplementarny

Rysunek 14: Wyniki pomiarow´

pem badan b ´
֒

edzie zaimplementowanie tego algorytmu w robocie RoBik [9, 12] i jego zbadanie na ruchomym obiekcie.

### 5.4 Uwagi o implementacji w robocie RoBik

Montaz dalmierzy w robocie RoBik [9] pokazano na rys. 15, a ich podł ˙
֒

aczenie do przetwornika
analogowo-cyfrowego opisano w [12].
Zyroskop w RoBiku jest jednoosiowy, analogowy, typu ENC03JA [1 ˙ | 5]. Jego wyjscie jest podł ´

֒

aczone
do przetwornika analogowo-cyfrowego za posrednictwem filtru dolnoprzepustowego. Filtr g ´ | orno- ´
przepustowy jest wył ֒

aczony.
Ze wzgl֒
edu na to, ze jednostka centralna (MPC555) jest wyposa ˙ | zona w sprz ˙ ֒
etowy procesor zmiennoprzecinkowy, mozliwe b ˙
֒

edzie zaimplementowanie nie tylko filtru komplementarnego, ale rownie ´ z˙ rozszerzonego fitru Kalmana.

### 6 Podsumowanie

W przedstawionych przykładach zastosowan filtr komplementarny sprawdził si ´
֒

e bardzo dobrze. Daje
on rezultaty porownywalne z filtrem Kalmana co do jako ´ | sci, znacznie przwy ´ | zszaj ˙
֒

ac go prostot ֒

a
implementacji. Ma to szczegolne znaczenie w niewielkich robotach autonomicznych, w kt ´ | orych ´
oszcz ֒
ednosć mocy obliczeniowej ma r ´ | ownie ´ | z wymiar energetyczny. ˙

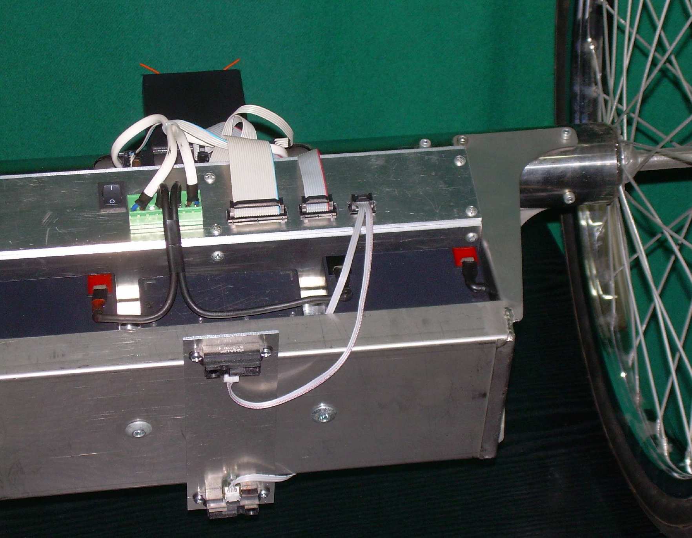
[picture p48: figure]

Rysunek 15: Czujniki odległosci podło ´ za w robocie RoBik ˙

Wydaje si֒

e, ze dobieraj ˙
֒
ac starannie parametry filtrow mo ´ | zna uzyska ˙ | c zadowalaj ´
֒

ace rezultaty w za-
kresie tłumienia szybkozmiennych zakłoce ´ n bez uszczerbku dla szybko ´ | sci reakcji filtru na chwilowe ´
zmiany orientacji.
Dalsze prace b ֒

ed ֒

a ukierunkowane na zbadanie dokładnosci odwzorowania orientacji z wykorzysta- ´
niem manipulatorow przemysłowych jako pozycjoner ´ | ow. ´

### Literatura

[1] R. Bieda, R. Grygiel. Wyznaczanie orientacji obiektu w przestrzeni z wykorzystaniem naiwnego filtru Kalmana. Przegl ֒

ad Elektrotechniczny, nr 1/2014.
[2] P. Brudny. Czujniki i nap ֒

edy dla obiektu autonomicznego w przestrzeni trojwymiarowej. Instytut ´ Informatyki Automatyki i Robotyki Politechniki Wrocławskiej, Projekt inzynierski 2014. ˙
[3] W. Higgins, Jr. A comparison of Complementary and Kalman Filtering. In: IEEE Transactions on Aerospace and Electronic Systems. Vol. AES-11, No. 3. May 1975.
[4] A. Jurasik. System stabilizuj ֒

acy poziome połozenie platformy. Instytut Informatyki Automatyki ˙ i Robotyki Politechniki Wrocławskiej, Projekt inzynierski 2014. ˙
[5] M. Kabała, M. Wnuk. Moduł z mikrokontrolerem MC9S12A64 (lub MC9S12C32). Instytut Cybernetyki Technicznej Politechniki Wrocławskiej, Raport serii SPR nr 11/2005.
[6] K. Lauszus A practical approach to Kalman filter and how to implement it. http://blog.tkjelectronics.dk/2012/09/a-practical-approach-to-kalman-filter-and-how-toimplement-it/
[7] S. Madgwick. An effcient orientation filter for inertial and inertial/magnetic sensor arrays. April 30, 2010.
[8] R. Mahony, T. Hamel, J. Pimlin. Nonlinear complementary filters on the special orthogonal group. Automatic Control, IEEE Transactions on, June 2008.
[9] R. Szlawski, M. Wnuk. Konstrukcja dwukołowego robota mobilnego RoBik. Instytut Cybernetyki Technicznej Politechniki Wrocławskiej, Raport serii SPR nr 12/2004.
[10] P. Urbaniak. System czujnikow do robota klasy Micromouse. Instytut Informatyki Automa ´ | tyki i
Robotyki Politechniki Wrocławskiej, Projekt inzynierski 2014. ˙
[11] G. Welch, G. Bishop. An Introduction to the Kalman Filter. University of North Carolina at Chapel Hill, Department of Computer Science, TR 95-041, March 8, 2007.
[12] M. Wnuk. Pomiar odchylenia od pionu korpusu robota balansuj ֒
| acego. Instytut Informatyki Au-
tomatyki i Robotyki Politechniki Wrocławskiej, Raport serii PRE nr 28/2008.
[13] ADXL345: 3-Axis Digital Accelerometer http://www.analog.com/en/mems-sensors/mems-inertial-sensors/adxl345/productsproduct.html ´
[14] BMP085 Datasheet
http://www.kamami.pl/index.php?productID=179972
[15] ENC03JA. Piezoelectric Gyroscopes
http://www.murata-europe.com/
[16] Example-Sketch-for-IMU-including-Kalman-filter. https://github.com/TKJElectronics/Example-Sketch-for-IMU-including-Kalman-filter/
[17] FXOS8700CQ: Digital Sensor - 3D Accelerometer + 3D Magnetometer http://www.freescale.com/webapp/sps/site/prod summary.jsp?code=FXOS8700CQ

[18] HMC5883L 3-Axis Digital Compass IC https://aerospace.honeywell.com/en/products/sensors/non-inertial-sensors/magnetic-fieldsensing-and-sensor-solutions/featured-product-hmc5883l
[19] Kinetis K6x Ethernet Crypto Microcontrollers (MCUs). http://www.freescale.com/webapp/sps/site/taxonomy.jsp?code=K60 ETHERNET CRYPTO MCU
[20] L3G4200D MEMS motion sensor: three-axis digital output gyroscope http://www.st.com/web/catalog/sense power/FM89/SC1288/PF250373
[21] LSM9DS0 iNEMO inertial module:3D accelerometer, 3D gyroscope, 3D magnetometer http://www.st.com/web/en/catalog/sense power/FM89/SC1448/PF258556
[22] LY3200 ALH Gyroscopes mems motion sensor 2000 dps analog yaw http://elcodis.com/parts/2065530/LY3200ALH.html
[23] MAG3110: Freescale High Accuracy, 3D Magnetometer http://www.freescale.com/webapp/sps/site/prod summary.jsp?code=MAG3110
[24] MAX21000 Ultra-Accurate, Low Power, 3-Axis Digital Output Gyroscope http://www.maximintegrated.com/en/products/analog/sensors-and-sensorinterface/MAX21000.html
[25] MMA8652FC: Low g, 12-Bit Digital Accelerometer. http://www.freescale.com/webapp/sps/site/prod summary.jsp?code=MMA8652FC
[26] MPL3115A2: 50 to 110kPa, Absolute Digital Pressure Sensor http://www.freescale.com/webapp/sps/site/prod summary.jsp?code=MPL3115A2
[27] MPU-6000/6050: Worlds First Integrated 3-Axis Gyro, 3-Axis Accel and 9-Axis MotionFusion http://invensense.com/mems/gyro/mpu6000.html
[28] Nota katalogowa mikrokontrolera STM32F103RBT6. http://www.st.com/web/catalog/mmc/FM141/SC1169/SS1031/LN1565/PF164487
[29] Open source IMU and AHRS algorithms. http://www.x-io.co.uk/open-source-imu-and-ahrs-algorithms/
[30] Tower System Modular Development Board Platform. http://www.freescale.com/webapp/sps/site/homepage.jsp?code=TOWER HOME

dr inz. Marek Wnuk ˙ | <marek.wnuk@pwr.edu.pl>
Katedra Cybernetyki i Robotyki
Wydział Elektroniki
Politechniki Wrocawskiej
ul. Janiszewskiego 11/17
50-372 Wrocaw

Niniejszy raport otrzymuj ֒

a:

1. OINT | – 1 egz.
2. Zleceniodawca | – 1 egz.
3. Katedra Cybernetyki i Robotyki (W4K7) | – 1 egz ´ | .
4. Autor | – 1 egz.
Raport wykonano w ramach zlecenia S30080: ,,Sterowanie i percepcja robotow z elastyczno ´ | sciami i ´
emocjonalnie inteligentnych”.

Wpłyn ֒

eło do redakcji W4/K7
2014-09-25
