KarolKaim/-masterThesis/masterThesisWork/praca.tex

\documentclass[11pt]{aghdpl}
% Lista wszystkich języków stanowiących języki pozycji bibliograficznych użytych w pracy.
% (Zgodnie z zasadami tworzenia bibliografii każda pozycja powinna zostać utworzona zgodnie z zasadami języka, w którym dana publikacja została napisana.)
\usepackage[english,polish]{babel}

% Użyj polskiego łamania wyrazów (zamiast domyślnego angielskiego).
\usepackage{polski}
\usepackage[utf8]{inputenc}

% dodatkowe pakiety
\usepackage{mathtools}
\usepackage{amsfonts}
\usepackage{amsmath}
\usepackage{amsthm}

% --- < bibliografia > ---

\usepackage[
style=numeric,
sorting=none,
%
% Zastosuj styl wpisu bibliograficznego właściwy językowi publikacji.
language=autobib,
autolang=other,
% Zapisuj datę dostępu do strony WWW w formacie RRRR-MM-DD.
urldate=iso8601,
% Nie dodawaj numerów stron, na których występuje cytowanie.
backref=false,
% Podawaj ISBN.
isbn=true,
% Nie podawaj URL-i, o ile nie jest to konieczne.
url=false,
%
% Ustawienia związane z polskimi normami dla bibliografii.
maxbibnames=3,
% Jeżeli używamy BibTeXa:
backend=bibtex
]{biblatex}

\usepackage{csquotes}
% Ponieważ `csquotes` nie posiada polskiego stylu, można skorzystać z mocno zbliżonego stylu chorwackiego.
\DeclareQuoteAlias{croatian}{polish}

\addbibresource{bibliografia.bib}

% Nie wyświetlaj wybranych pól.
%\AtEveryBibitem{\clearfield{note}}

% ------------------------
% --- < listingi > ---

% Użyj czcionki kroju Courier.
\usepackage{courier}

\usepackage{listings}
\lstloadlanguages{TeX}

\lstset{
	literate={ą}{{\k{a}}}1
           {ć}{{\'c}}1
           {ę}{{\k{e}}}1
           {ó}{{\'o}}1
           {ń}{{\'n}}1
           {ł}{{\l{}}}1
           {ś}{{\'s}}1
           {ź}{{\'z}}1
           {ż}{{\.z}}1
           {Ą}{{\k{A}}}1
           {Ć}{{\'C}}1
           {Ę}{{\k{E}}}1
           {Ó}{{\'O}}1
           {Ń}{{\'N}}1
           {Ł}{{\L{}}}1
           {Ś}{{\'S}}1
           {Ź}{{\'Z}}1
           {Ż}{{\.Z}}1,
	basicstyle=\footnotesize\ttfamily,
}

% ------------------------

\AtBeginDocument{
	\renewcommand{\tablename}{Tabela}
	\renewcommand{\figurename}{Rys.}
}

% ------------------------
% --- < tabele > ---

\usepackage{array}
\usepackage{tabularx}
\usepackage{multirow}
\usepackage{booktabs}
\usepackage{makecell}
\usepackage[flushleft]{threeparttable}
\usepackage{graphicx}

\graphicspath{ {./images/} }

% defines the X column to use m (\parbox[c]) instead of p (`parbox[t]`)
\newcolumntype{C}[1]{>{\hsize=#1\hsize\centering\arraybackslash}X}

\author{Karol Kaim}
\shortauthor{Karol Kaim}
\titlePL{Projekt i wykonanie prototypu elektronicznego układu zmiany przełożeń w rowerze}
\shorttitlePL{Projekt i wykonanie prototypu elektronicznego układu zmiany przełożeń w rowerze}
\titleEN{Design and implementation of a prototype of an electronic gear-shifting unit in a bicycle}
\shorttitleEN{Design and implementation of a prototype of an electronic gear-shifting unit in a bicycle}
\thesistype{Praca dyplomowa magisterska}
\supervisor{dr inż. Maciej Rosół }
\degreeprogramme{Automatyka i Robotyka}
\date{2016}
\department{Katedra Automatyki i Inzynierii Biomedycznej}
\faculty{Wydział Elektrotechniki, Automatyki,\protect\\[-1mm] Informatyki i Inżynierii Biomedycznej}

\acknowledgements{Pragnę złożyć serdeczne podziękowania dla promotora pracy, dr Macieja Rosoła, za okazane wsparcie i pomoc w trakcie pisania niniejszej pracy dyplomowej.}

\setlength{\cftsecnumwidth}{10mm}

%---------------------------------------------------------------------------
\setcounter{secnumdepth}{4}
\brokenpenalty=10000\relax

\begin{document}

\titlepages
% Ponowne zdefiniowanie stylu `plain`, aby usunąć numer strony z pierwszej strony spisu treści i poszczególnych rozdziałów.
\fancypagestyle{plain}
{
	% Usuń nagłówek i stopkę
	\fancyhf{}
	% Usuń linie.
	\renewcommand{\headrulewidth}{0pt}
	\renewcommand{\footrulewidth}{0pt}
}

\setcounter{tocdepth}{2}
\tableofcontents
\clearpage

\input{./chapters/r1.tex}
\input{./chapters/r2.tex}
\input{./chapters/r3.tex}
\input{./chapters/r4.tex}
\input{./chapters/r5.tex}
\input{./chapters/r6.tex}
\input{./chapters/r7.tex}

\printbibliography[heading=bibintoc,title={Bibliografia}]
\input{./chapters/DodatekA.tex}
\input{./chapters/DodatekB.tex}

\end{document}
