KarolKaim/-masterThesis/masterThesisWork/chapters/DodatekB.tex

\chapter*{Dodatek B}
\addcontentsline{toc}{chapter}{Dodatek B}  

Niniejszy dodatek zawiera zdjęcia elementów wykonanych w trakcie realizacji projektu.

\begin{figure}[h]
    \centering
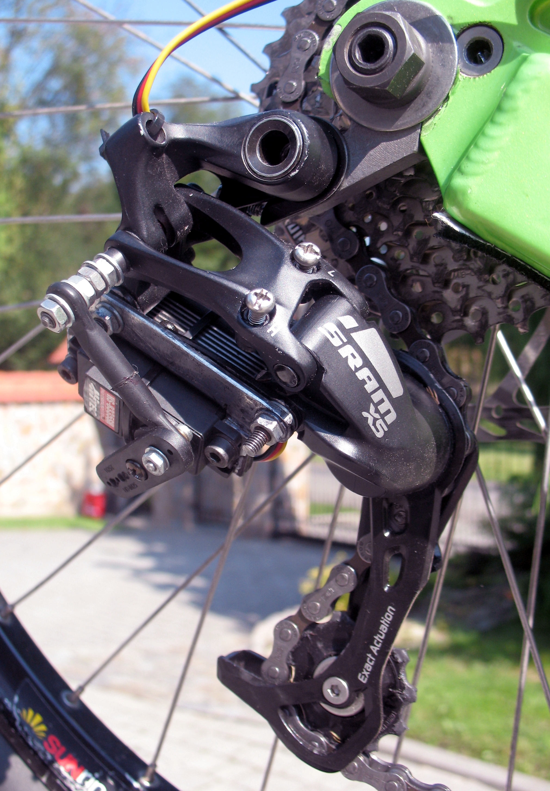
[picture p49: masterThesisWork/images/przerzutkaRower.jpg]
    
    \caption{Przerzutka SRAM X5 wraz z zamontowanym serwomechanizmem.}
    \label{fig:Rower}
\end{figure}

\begin{figure}[h]
\centering
\begin{subfigure}{.4\textwidth}
  \centering
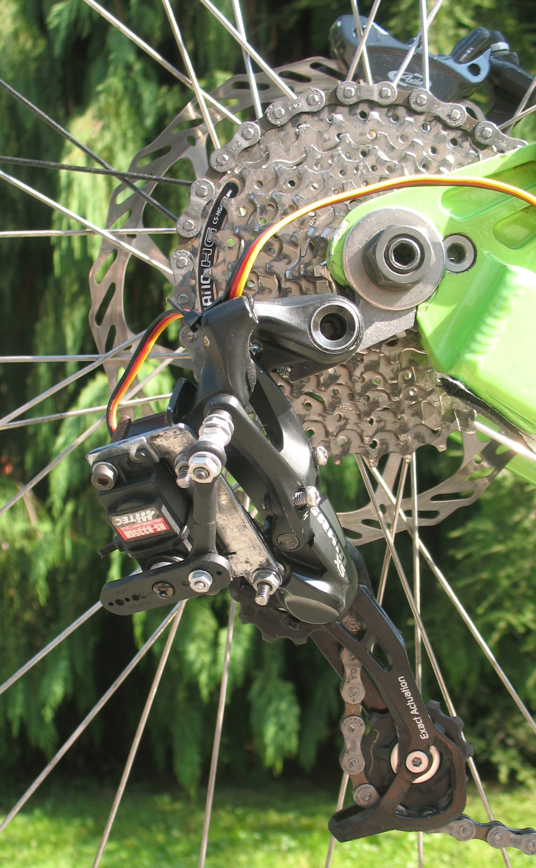
[picture p50: masterThesisWork/images/przerzutka1bieg.jpg]
  
  \caption{Przerzutka w pozycji biegu nr 1}

\end{subfigure}
\begin{subfigure}{.4\textwidth}
  \centering
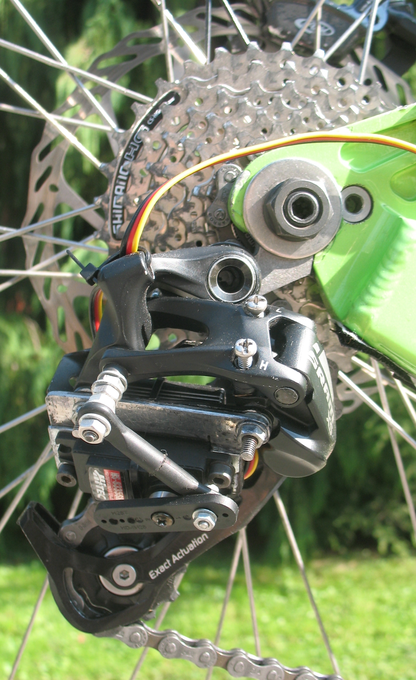
[picture p51: masterThesisWork/images/przerzutka8bieg.jpg]
  
  \caption{Przerzutka w pozycji biegu nr 8}

\end{subfigure}
\caption{Pozycja przerzutki dla skrajnych przełożeń}
\label{fig:test}
\end{figure}

\begin{figure}[h]
\centering
\begin{subfigure}{.4\textwidth}
  \centering
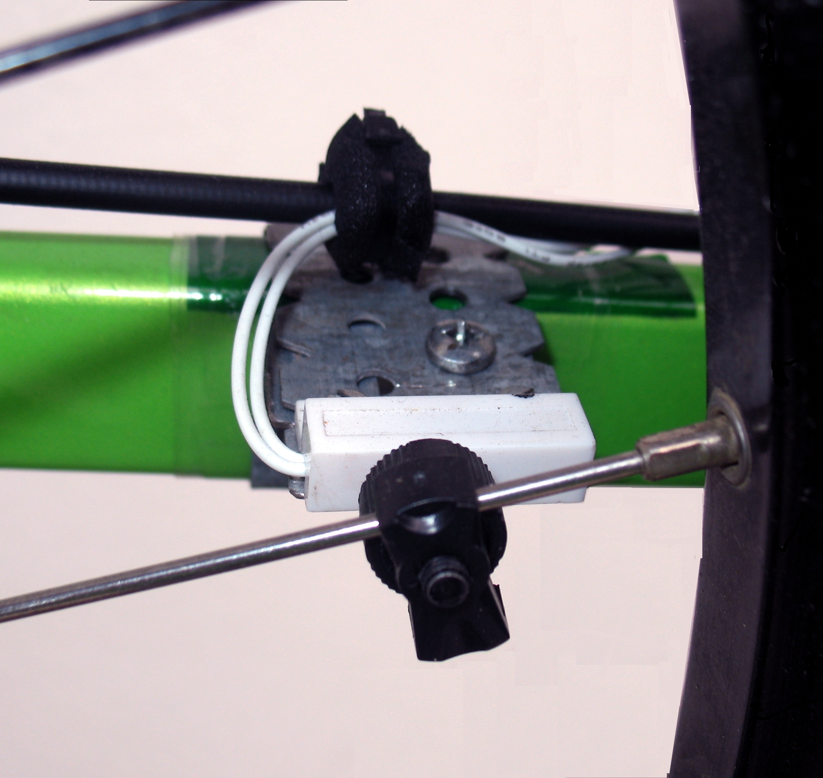
[picture p52: masterThesisWork/images/przerzutkaCzujnikPredkosci.jpg]
  
  \caption{Czujnik prędkości roweru}
\end{subfigure}
\begin{subfigure}{.4\textwidth}
  \centering
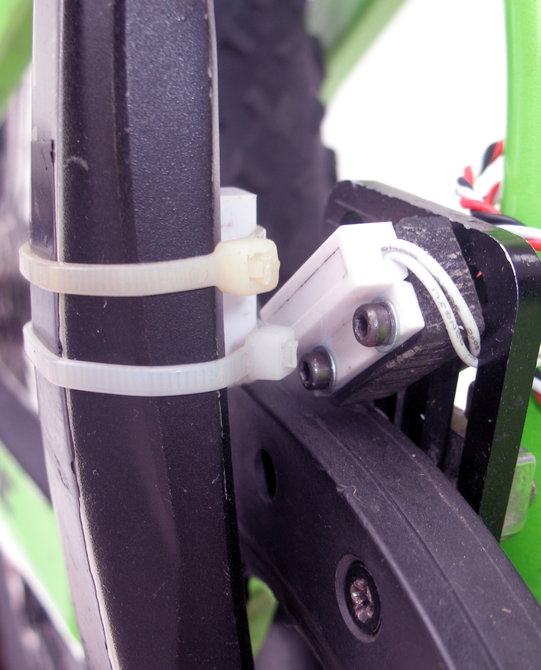
[picture p53: masterThesisWork/images/przerzutkaKorba.jpg]
  
  \caption{Czujnik kadencji}

\end{subfigure}
\caption{Czujniki magnetyczne}
\label{fig:test}
\end{figure}

\begin{figure}[h]
\centering
\begin{subfigure}{.4\textwidth}
  \centering
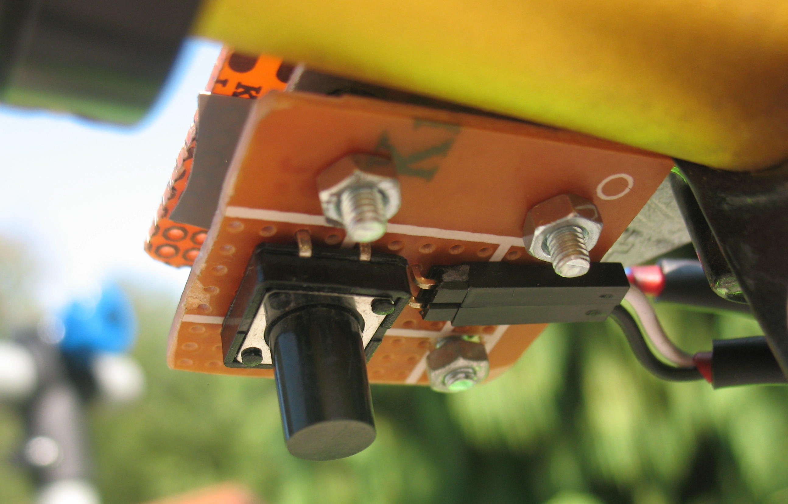
[picture p54: masterThesisWork/images/manetka1.jpg]
  
  \caption{Przycisk redukujący bieg}
\end{subfigure}
\begin{subfigure}{.4\textwidth}
  \centering
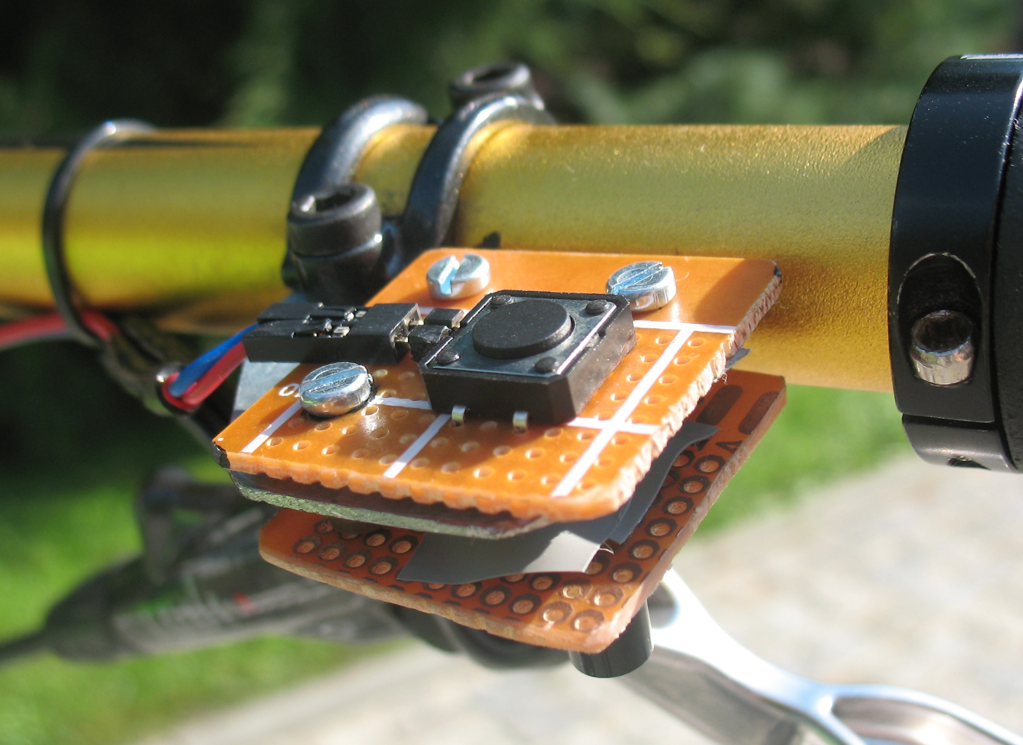
[picture p55: masterThesisWork/images/manetka2.jpg]
  
  \caption{Przycisk zwiększający bieg}
\end{subfigure}
\caption{Manetka do zmiany przełożeń}
\label{fig:test}
\end{figure}

\begin{figure}[h]
    \centering
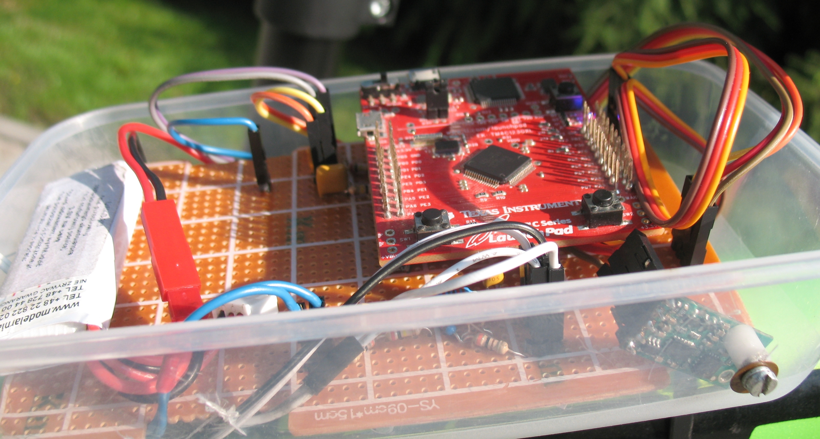
[picture p56: masterThesisWork/images/przerzutkaSterownik.jpg]
    
    \caption{Sterownik układu}
    \label{fig:sterownik}
\end{figure}
