KarolKaim/-masterThesis/masterThesisWork/tasks.odt

Taski:

1. Kontroler przerzutki - program
  1. Tryb automatyczny
    - tryb comfort – utrzymanie zadanej prędkości na podstawie kadencji. Brak możliwości przełączania ręcznego
      - wykorzystanie timera do cyklicznego przerwania sprawdzającego aktualną kadencję – powiedzmy co 2 sek
      - wyłaczenie przewań od przycisków do zmiany biegów
    - tryb active – kadencja + możliwość zmiany ręcznej. Trochę bardziej sportowa charakterystyka.
      - Wykorzystanie timera do cyklicznego przerwania sprawdzającego aktualną kadencję – co pół sekundy.
    - tryb sport – jakas fuzja danych. Można brać pod uwagę kadencję, prędkość, pochodną prędkości, dane z akcelerometru(poziom nachylenia stoku). Być może jakieś
    - RGB indicator
  2. Tryb ręczny
      - dorobienie możliwości zmiany przełożeń przytrzymując przycisków
2. Elektronika
  1. Panel kontroli
      - zaprojektowanie panelu
      - wykonanie panelu
      - montaż panelu
  2. Akcelerometr
      - montaż akcelerometru
  3. przetestowanie czujników prędkości obrotowej koła
3. Praca magisterska
  1. Opis sprzętu
      - Texas procek
      - akcelerometr
      - serwomechanizm
      - schemat połącznia
  2. Opis środowiska
      - CCS
      - Arm toolchain
      - analizator stanów logicznych
  3. Opis napotkanych problemów
      - filtry RC
      - można coś o zużyciu energii, dobór baterii
  4. Opis teorii
      - filtry RC, stała czasowa, obiekt inercyjny 1 rzędu
      - układ zamknięty – serwomechanizm
      - sterowaniu rozmytym
  5. Opis algorytmu
      - opis trybów
      - rysunki
  6. Książki:
    - Andrzej Rutkowski – Części Maszyn do wypożyczenia
