KarolKaim/-masterThesis/masterThesisWork/praca.pdf

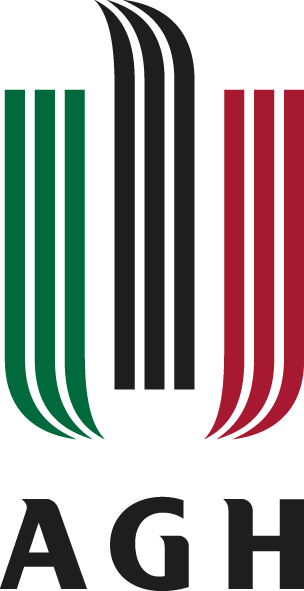
[picture p80: figure]

AKADEMIA GÓRNICZO-HUTNICZA IM. STANISŁAWA STASZICA W KRAKOWIE

WYDZIAŁ ELEKTROTECHNIKI, AUTOMATYKI, INFORMATYKI I INZYNIERII BIOMEDYCZNEJ ˙

KATEDRA AUTOMATYKI I INZYNIERII BIOMEDYCZNEJ

## Praca dyplomowa magisterska

## Projekt i wykonanie prototypu elektronicznego układu zmiany przełoze˙ n´ w rowerze Design and implementation of a prototype of an electronic gear-shifting unit in a bicycle

Autor: | Karol Kaim
Kierunek studiów: | Automatyka i Robotyka
Opiekun pracy: | dr inz. Maciej Rosół ˙

Kraków, 2016

Uprzedzony o odpowiedzialnosci karnej na podstawie art. 115 ust. 1 i 2 ustawy z dnia 4 lu- ´ tego 1994 r. o prawie autorskim i prawach pokrewnych (t.j. Dz.U. z 2006 r. Nr 90, poz. 631 z późn. zm.): „Kto przywłaszcza sobie autorstwo albo wprowadza w bł ąd co do autorstwa ca-
łosci lub czę ´ | sci cudzego utworu albo artystycznego wykonania, podlega grzywnie, karze ogra- ´
niczenia wolnosci albo pozbawienia wolno ´ | sci do lat 3. Tej samej karze podlega, kto rozpo- ´
wszechnia bez podania nazwiska lub pseudonimu twórcy cudzy utwór w wersji oryginalnej albo w postaci opracowania, artystycznego wykonania albo publicznie zniekształca taki utwór, artystyczne wykonanie, fonogram, wideogram lub nadanie.”, a takze uprzedzony o odpowie- ˙ dzialnosci dyscyplinarnej na podstawie art. 211 ust. 1 ustawy z dnia 27 lipca 2005 r. Prawo ´ o szkolnictwie wyzszym (t.j. Dz. U. z 2012 r. poz. 572, z późn. zm.): „Za naruszenie przepisów ˙ obowi ązuj ących w uczelni oraz za czyny uchybiaj ące godnosci studenta student ponosi odpo- ´
wiedzialnosć dyscyplinarn ą przed komisj ą dyscyplinarn ą albo przed s ądem kole ´ | ze ńskim samo- ˙
rz ądu studenckiego, zwanym dalej «s ądem koleze ńskim».”, o ˙ | swiadczam, ´ | ze niniejsz ą pracę dy- ˙
plomow ą wykonałem(-am) osobiscie i samodzielnie i ´ | ze nie korzystałem(-am) ze źródeł innych ˙
niz wymienione w pracy. ˙

### Serdecznie dziękuję . . . tu ci ąg dalszych podziękowa ń np. dla promotora, zony, s ąsiada itp. ˙

## Spis tresci ´

1.2.1. Jakis tytuł | | 8 ´
1.2.2. Jakis tytuł 2 | | 8 ´
2.2. Metody pomiarowe wielkosci fizycznych | 10 ´
2.2.1. Pomiar prędkosci k ątowej oraz prędko ´ | sci liniowej | 10 ´
2.2.2. Pomiar przyspieszen | 13 ´

### 3. Opis podzespołów oraz narzędzi programistycznych wykorzystanych w trakcie realizacji

### 6 SPIS TRESCI ´

Karol Kaim Projekt i wykonanie prototypu elektronicznego układu zmiany przełoze ń w rowerze ˙

## 1. Wstęp

## 1.1. Wprowadzenie

Nowoczesnie technologie znajduj ą coraz większe zastosowanie w codziennym zyciu. Szybki rozwój ˙

techniki, miniaturyzacja oraz nizsze koszty produkcji sprawiaj ą, ˙ | ze coraz więcej urz ądze ˙ | n codziennego ´
uzytku wyposa ˙ | zonych jest w układy elektroniczne, które skutczenie zwiększaj ą ich mo ˙ | zliwo ˙ | sci. ´
Obserwuj ąc rynek rowerowy mozna zauwa ˙ | zy˙ c, i ´ z coraz większy nacisk kładziony jest na rozwój oraz ˙

zastosowanie wszelkiego rodzaju podzespołów rowerowych, wykorzystuj ących układy elektroniczne.

Doskonałym przykładem takiego urz ądzenia, a własciwie zespołu urz ądze ´ | n stanowi ących integraln ą ca- ´
łosć produktu, s ą elektroniczne układy do zmiany przeło ´ | ze˙ n w rowerze. ´

Pierwsze próby opracowania takich układów miały miejsce w latach 90 ubiegłego wieku. Jednak ze
względu na wygórowan ą cenę, wyzsz ą zawodno ˙ | sć ni ´ | z odpowiedniki mechaniczne oraz wysok ą masę, ˙

która zwłaszcza w kolarstwie szosowym jest nie do zaakceptowania, nie odniosły komercyjnego suk-

cesu. Dopiero w roku 2009 japonska firma Shimano wprowadziła na rynek w pełni funkcjonalny układ ´

DuraAce Di2( z ang. Digital Integrated Intelligence)([Dil00 ]). Grupa potwierdziła swoj ą wysok ą po-
zycję na rynku m.in. poprzez to, ze rowery wyposa ˙ | zone w ten napęd wygrały ju ˙ | z kilkukrotnie wielkie ˙

wyscigi kolarskie, np. TourDeFrance. W 2015 Shimano wprowadziło na rynek grupę XTR Di2. Jest ´

to odpowiednik DuraAce Di2 do zastowan w kolarstwie górskim. Shimano potwiedziło tym samym ´

swoj ą dominację na rynku. Największy konkurent, frima SRAM, wprowadziła do swojej oferty układ sterowany elektronicznie dopiero w roku 2016. Seria RED eTAP, oferowana przez SRAM, wyróznia się ˙

kilkoma ciekawmymi rozwi ązaniami. Jest to system w pełni bezprzewodowy, który do transmisji danych
uzywa nielicencjonowanego pasma 2.4 GHz a dane szyfrowane s ą przy u ˙ | zyciu kluczy o długo ˙ | sci 128 bi- ´

tów. System w pełni bezprzewodowy wymusił zastosowanie rozproszonego systemu zasilania, na który

składj ą się dwa akumulatory litowo-jonowe zasilaj ące przerzutki oraz dwie baterie CR2032 zasilaj ące

klamkomanetki[bikeWorld.pl ].
Ze względu na wiele zalet, elektroniczne układy zmiany przełoze˙ n w rowerze zyskuj ą coraz więk- ´

sze grono uzytkowników. Przede wszystkim eliminuj ą wady odpowiedników mechanicznych - nie s ą ˙

podatne na zuzycie przewodów, dzięki czemu zachowuj ą precyzję działania a czynno ˙ | sci serwisowe ´
sprowadzaj ą się jedynie do ładowania akumulatorów. Umozliwiaj ą zmianę przeło ˙ | ze˙ n praktycznie bez ´
zadnego wysiłku ze strony rowerzysty. Do tego zastosowanie przycisków w ró ˙ | znych miejscach na kier- ˙
wonicy sprawia, ze u ˙ | zytkownik nie musi zmienia ˙ | c pozycji r ąk aby zmieni ´ | c przeło ´ | zenie. W przypadku ˙

8 1.2. Cel pracy

klasycznych klamkomanetek takie rowzwi ązanie nie jest mozliwe. Jedyn ą wad ą układów elektronicz- ˙

nych jest ich cena. W momencie opracowywania niniejszej pracy cena za kompletny układ napędowy z gupy Shimano DuraAce Di2 wynosiła około 1500$

## 1.2. Cel pracy

Celem niniejszej pracy jest wykonanie prototypu elektronicznego układu zmiany przełoze˙ n w ro- ´

werze. Nawi ązuj ąc do produktów oferowanych na rynku, autor zakłada, iz uda się wykona ˙ | c system, ´
który nie tylko będzie oferował ręczny dobór przełoze˙ n, ale zostanie rozszerzony o mo ´ | zliwo ˙ | sć auto- ´
matycznej zmiany przełoze˙ n wraz z mo ´ | zliwo ˙ | sci ą profilowania charakterystyki pracy układu. Głównymi ´

elementami mechanicznymi prototypu będ ą przerzutka tylna 8-rzędowa SRAM X-7, kaseta 8-rzędowa

oraz blat przedni. Wózek przerzutki będzie pozycjonowany z wykorzystaniem serwomechanizmu. Układ

sterowany będzie przy urzyciu mikrokontrolera. Do tego zostan ą wykorzystane odpowiednie urz ądzenia pomiarowe, niezbędne do wykonania trybu automatycznego. Autor zdaje sobie sprawę, iz wykoannie ˙

prototypu, który pod względem mechanicznym moze stanowi ˙ | c konkurencję dla rozwi ąza ´ | n oferowanych ´

na rynku, wymagałoby niezwykle duzego nakładu pracy. Dlatego swoj ą uwagę skupił głównie na opra- ˙

cowaniu kompleksowego algorytmu sterj ącego, który nie jest oferowany przez zadnego z producentów. ˙

@TODO Opisac w skrocie kolejne rozdzialy pracy

### 1.2.1. Jakis tytuł ´

### 1.2.1.1. Jakis tytuł w subsubsection ´

### 1.2.2. Jakis tytuł 2 ´

## 2. Zestawienie zagadnien wykorzystanych w pracy ´

## 2.1. Mechaniczne układy napędowe

### 2.1.1. Przekładnie mechaniczne

Układ napędowy to zestaw urz ądzen wykorzystywany do napędzania, w skład którego wchodzi źro- ´

dło energii, układy posrednicz ące w przekazywaniu energii oraz odbiornik energi. Mianem napędu za- ´

zwyczaj okresla się urz ądzenia po ´ | srednicz ące. Najczę ´ | sciej wykorzystywanymi źródłami enrgii s ą silniki ´

a odbirniki energii, których zadaniem jest realizowanie odpowiednich ruchów roboczych, przyjmuj ą
rózne formy zale ˙ | zne od aplikacji. ˙

Układ mechaniczny wykorzystany do przeniesienia ruchu obrotowego z elementu czynnego na element bierny nazywany jest przekładni ą mechaniczn ą. Oprócz transmisji energii, przekładnie umozliwaj ą ˙

równiez zmianę parametrów ruchu - momentu obrotowego oraz prędko ˙ | sci obrotowej. Przekładnie me- ´

chaniczne dzieli się na trzy grupy: cięgnowe, cierne i zębate. Przekładnie cięgnowe, które zostały opisane

ze wzgędu na zastosowanie w rowerowych układach napędowych, składaj ą się z conajmniej dwóch kół

zębatych, rozsuniętych względem siebie, oraz cięgna opasaj ącego. Ze względu na rodzaj zastosowanego
cięgna, wyróznia się przekładnie pasowe oraz ła ˙ | ncuchowe. Przenoszenie siły z cięgna na koło zębate jest ´
mozliwe dzięki zastosowaniu odpowiednich poł ącze ˙ | n - poł ączenia cierne, kształtowe lub stałe przymo- ´

cowanie cięgna do koła zębatego.

@TODO wrzucic schemat przekładni, doda ´ | c jaki ´ | s przypis doprzełkadni ´
Wielkosci ą charakteryzuj ąc ą przekładnie jest przeło ´ | zenie. Wyró ˙ | znia się przeło ˙ | zenie geometryczne, ˙
kinematyczne oraz dynamiczne. Przełozenie kinematyczne to stosunek prędko ˙ | sci k ątowej koła czynnego ´
do prędkosci k ątowej koła biernego: ´ | @TODO wzorek i=w1/w2
Przełozenie dynamiczne okre ˙ | sla stosunek momentu obrotowego na kole biernym do momentu obro- ´

towego koła czynnego.

@TODO wzorek i=M2/M1

Przełozenie przekładni jest parametrem bezwymiarwoym. Ze względu na warto ˙ | sć przeło ´ | zenia prze- ˙

kładni wyróznia się:

10 2.2. Metody pomiarowe wielkosci fizycznych ´

– Przekładnie przyspieszaj ące lub tzw. multiplikatory. Przekładnie tego typu zwiększaj ą prędkosć´

k ątow ą koła biernego względem prędkosci k ątowej koła czynnego przy jednoczesnym zmniejsze- ´

niu momentu obrotowego koła biernego względem momentu obrotowego koła czynnego. Przełozenie takiej przekładni jest liczb ą z zakresu od 0 do 1. ˙

– Przekładnie redukuj ące lub tzw. reduktory. Przekładnie tego typu działaj ą w sposób odwrotny do

przekładni przyspieszaj ących - zmniejszaj ą prędkosć k ątow ą koła biernego względem prędko ´ | sci ´

k ątowej koła czynnego oraz zwiększaj ą moment obrotowy koła biernego wzlgędem momentu obrotowego koła czynnego. Przełozenei przekładni redukuj ącej jest zawsze większe od 1. ˙

### 2.1.2. Układ napędowy w rowerze

W przypadku konwencjonalnego układu napędowego stosowanego w rowerach źródłem energii jest rowerzysta. Siła przyłozona do ramienia korby generuje moment obrotowy, który przenoszony jest, przy ˙

pomocy mechanizmu korbowego i łancucha, na koło zębate na stałe przymocowoane do piasty tylnego ´

koła. Moment obrotowy koła napędzaj ącego powoduje powstanie sił obwodowych, składaj ących się na

siłę napędow ą, która wprawia rower w ruch postępowy.

Układ napędkowy roweru wykorzystanego w pracy składa się z mechanizmu korbowego z jednym

kołem zębatym, łancucha, kasety o ´ | smiorzędowej oraz przerzutki tylnej. Koło zebate zamontowane w ´

mechaniźmie korbowym ma 34 zęby. Kaseta składa się z osmiu kół zębatych, których liczba zębów ´
nalezy do zakresu od 11 do 32. Przekładnia zastosowana w rowerze, niezale ˙ | | | znie od aktualnego biegu, ˙

ma zawsze charakter mulitiplikatora.
| Tylna przerzutkau umozliwia zmianę przeło ˙ | zenia układu napędowego. Działa na zasadzie czworo- ˙

boku przegubowego. Składa się z czterech członów poł ączonych przegubowo, tworz ących zamknięty

łancuch kinamatyczny. Pozycja wózka przerzutki przymontowanego do jedenego z członów (Rys.2.1) ´ utrzymywana jest dzięki zastosowaniu spręzyny napinaj ącej oraz cięgna, poł ączonego z mechanizmem ˙

do zmiany przełoze˙ n, zamontowanym w manetce. Dodatkowo przerzutka posiada mechanizm napinaj ący ´

łancuch, tak aby zachowa ´ | c pełn ą funkcjonalno ´ | sć układu napędowego niezale ´ | znie od aktualnej pozycji ˙

wózka.

## 2.2. Metody pomiarowe wielkosci fizycznych ´

2.2.1. Pomiar prędkosci k ątowej oraz prędko ´ | sci liniowej ´
Mozliwo ˙ | sć pomiaru prędko ´ | sci k ątowej jest kluczowa ze względu na wykonanie trybu automatycznej ´
zmiany przełoze˙ n. Na podstawie aktualnej prędko ´ | sci k ątowej tylnego koła wyznaczona zostanie chwi- ´
lowa prędkosć liniowa. Pomiar prędko ´ | sci k ątowej mechanizmu korbowego umo ´ | zliwi wyznaczenie aktu- ˙

lane wartosci kadencji. ´
Prędkosć k ątowa jest wielko ´ | sci ą wektorow ą, jednak w rozwa ´ | zaniach dotycz ących pracy brana pod ˙
uwagę jest jedynie chwilowa wartosć prędko ´ | sci k ątowej. Ta zdefiniowana jest jako zmiana drogi k ątowej ´

2.2. Metody pomiarowe wielkosci fizycznych ´ | 11


Rys. 2.1. Zasada działania konwencjonalnej przerzutki rowerowej

w czasie:

ω =

dϕ
dt | (2.1)

ϕ – droga k ątowa

t – czas

Wyznaczenie chwilowej wartosci prędko ´ | sci k ątowej wykonane zostało w oparciu o czujniki zbli ´ | zeniowy ˙

zał ączany magnetycznie, który został na stałe przymocowany do ramy roweru, w niewielkiej odległosci ´

od tylnego koła. Zasada działania takiego czujnika jest analogiczna do działania zwykłego przycisku
monostabilnego. Obwód w czujniku jest domyslnie rozwarty. Zwarcie następuje w momencie zbli ´ | ze- ˙

nia magnesu do czujnika. Magnes przyczepiony został do szprychy roweru. Taki sam sposób pomiaru
prędkosci mo ´ | zna znaleź ˙ | c w komercyjnych licznikach rowerowych oferowanych na rynku. Autor zde- ´

cydował się na zastosowanie dwóch magnesów w celu zwiększenia dokładnosci pomiaru. Dysponuj ąc ´

pomiarem czasu pomiędzy kolejnymi zwarciami czujnika magnetycznego, które, ze względu na zastoso-
wanie dwóch magnesów, następuj ą w wyniku obrotu koła o k ąt π , mozna wyznaczy ˙ | c chwilow ą warto ´ | sć´

prędkosci k ątowej: ´

ω =

π
T

(2.2)

T – czas od ostatniego zwarcia czujnika magnetycznego

12 2.2. Metody pomiarowe wielkosci fizycznych ´


Rys. 2.2. Zasada działania przerzutki rowerowej z wykorzystaniem serwomechanizmu

Prędkosć k ątowa mechanizmu korbowego została wyznaczona w sposób analogiczny. Zbli ´ | zeniowy czuj- ˙

nik magnetyczny, który został na stałe przymocowany do ramy roweru, w bliskiej odległosci mechanizmu ´ korbowego, jest zwierany w kazdym cyklu dzięki zastosowaniu magnesu, który został przyklejony do ra- ˙

mienia mechanizmu korbowego. Ze względu na zastosowanie jednego magnesu, przyrost drogi k ątowej
jest dwa razy większy, niz w przypadku pomiaru prędko ˙ | sci k ątowej koła roweru i jego warto ´ | sć wynosi ´

2π.

Wartosć prędko ´ | sci liniowej to stosunek przebytej drogi do czasu: ´

v =

s
t

(2.3)

s – droga liniowa

v – prędkosć liniowa ´

Zwi ązek pomiędzy drog ą liniow ą a drog ą k ątow ą wyraza się wzorem: ˙

ϕ =

s
r

(2.4)

r – promien okręgu ´

W układzie pomiarowym z dwoma magnesami, wartosć drogi k ątowej w momencie zwarcia czujnika ´
magnetycznego wynosi π. Bior ąc pod uwagę powyzsze zale ˙ | znosci, chwilowa warto ˙ | sć prędko ´ | sci liniowej ´

2.2. Metody pomiarowe wielkosci fizycznych ´ | 13
poruszaj ącego się roweru moze zosta ˙ | c wyznaczona z zale ´ | zno ˙ sci: ´

v =

πR
T

(2.5)

R – promien koła rowerowego ´

### 2.2.2. Pomiar przyspieszen´

Z drugiej zasady dynamiki Newtona wynika, iz przyspieszenie jest proporcjonalne do wypadkowej ˙

siły działaj ącej na ciało. Znajomosć chwilowej warto ´ | sći oraz zwrotu przyspieszenia jest drug ą istotn ą in- ´
formacj ą, która została wykorzystana przy projektowaniu sterownika trybu automatycznego, gdyz mo ˙ | ze˙

dostarczyc wiedzy na temat dynamiki ruchu. ´

Pomiar przyspieszenia został zrealizowany w oparciu o zastosowanie akcelerometru wykonanego w

technologii MEMS( z ang. Micro Electro-Mechanical Systems). Układy MEMS to urz ądzenia wykonane

w miniaturowej skali, które integruj ą ze soba elementy mechaniczne oraz elektroniczne. Wykorzysty-

wane głównie jako czujniki przetwarzaj ące wielkosci mechaniczne na wielko ´ | sci elektryczne. Czujniki ´
wykonane w technologii MEMS posiadaj ą kilka znacz ących zalet, które sprawiaj ą, ze spektrum zastoso- ˙
wan staje się coraz szersze. S ą to m.in. niska cena, niewielkie rozmiary, niskie zu ´ | zycie energii oraz prosta ˙

integracja z układami mikroprocesorowymi. Akcelerometry wykonane w tej technologii s ą powszechnie wykorzystywane w róznego rodzaju aplikacjach. Układy steruj ące poduszkami powietrznymi, systemy ˙

alarmowe w samochodach czy tzw. asysten ruszania na wzniesieniu to tylko niektóre przykłady z branzy˙

motoryzacyjnej.
Akcelereometr to urz ądzenie pomiarowe, które umozliwia pomiar przyspieszenia dynamicznego ˙

ciała, na które działa niezerowa siła wypadkowa, oraz przyspieszenia statycznego ciała znajduj ącego

się w ziemskim polu grawitacyjnym. Akcelerometry zazwyczaj działaj ą na zasadzie przetworników po-
jemnosciowych. Pomiar dokonywany jest dzięku zastosowaniu kondensatorów ró ´ | znicowych, których ˙
ruchome okładki wychylane s ą z połozenia równowagi pod wpływem działaj ących sił bezwładno ˙ | sci. ´

Akcelerometr wykonany w technologii MEMS zazwyczaj umozliwia pomiar przyspieszenia w trzech ˙

róznych kierunkach( ˙ | @TODO rysunek). Akcelerometr został zamontowany w rowerze w taki sposób,
aby kierunek osi X był równoległy do podłoza. Dzięki temu wskazania akcelerometru wzdłu ˙ | z osi ˙ | X s ą

proporcjonalne do siły wypadkowej działaj ącej na rower.

### 2.2.3. Pomiar k ąta nachylenia

K ąt nachylenia podłoza, po którym porusza się rower, to ostatnia z wielko ˙ | sci brana pod uwagę przez ´
algorytm automatycznej zmiany przełoze˙ n. Wielko ´ | sć ta wyznaczona zostanie po ´ | srednio, poprzez analizę ´

danych odczytywanych z akcelerometru.

Przykład zamieszczony na rysunku 2.3 przedstawia ciało znajduj ące się na równi pochyłej. Przy-
spieszenie ziemskie g zostało rozłozone na kierunki składowe wzdłu ˙ | z osi pomiarowych akcelerometru ˙
- ax oraz ay. Wektory składowe wraz z przyspieszeniem ziemskim stanowi ą trójk ąt podobny do trój-

k ąta równi pochyłej, której k ąt nachylenia został oznaczony jako α. Stosunek długosci przyprostok ątnej ´

14 2.3. Sterowanie


Rys. 2.3. a nice plot

lez ącej naprzeciw k ąta ˙ | α do wartosci drugiej przyprostok ątnej, które odpowiadaj ą warto ´ | sci ą przyspie- ´
szen mierzonym przez akcelerometr odpowiednio wzdłuz osi ´ | | x i y, wynosi tan α. Zastosowanie funkcji

odwrotnej pozwala wyznaczyc k ąt nachylenia równi: ´

α = arctan

ax
ay

(2.6)

| α – k ąt naychylenia podłoza˙
ax | – przyspieszenie akcelerometru mierzone wzłuz osi x ˙
ay | – przyspieszenie akcelerometru mierzone wzłuz osi y ˙

## 2.3. Sterowanie

### 2.3.1. Zamknięty układ regulacji

### 2.3.2. Serwomechanizm

## 2.4. Kondycjonowanie sygnałów

### 2.4.1. Drganie styków

### 2.4.2. Filtr donlnoprzepustowy

## 3. Opis podzespołów oraz narzędzi programistycznych wyko-

## rzystanych w trakcie realizacji projektu

## 3.1. Wykaz podzespołów

### 3.1.1. Przerzutka tylna

### 3.1.2. Serwomechanizm

### 3.1.3. Mikrokontroler

### 3.1.4. Czujniki pomiarowe

### 3.1.4.1. Akcelerometr

### 3.1.4.2. Zblizeniowe czujniki magnetyczne ˙

### 3.1.5. Układ zasilania

## 3.2. Narzędzia programistyczne

### 3.2.1. Code Composer Studio 6.0.0

### 3.2.2. Biblioteka TivaWare

### 3.2.3. Pozostałe oprogramowanie
