KarolKaim/-masterThesis/usefulDocuments/filtrRCTeoria.pdf

Laboratorium Teorii Sterowania

Ćwiczenie 1 (CS) – Charakterystyki czasowe członów dynamicznych | - 1 -

Wydział Elektryczny
Zespól Automatyki (ZTMAiPC)

### LABORATORIUM TEORII STEROWANIA

### Ćwiczenie 1

CS

### Charakterystyki czasowe członów dynamicznych

### 1. Cel ćwiczenia

- Zapoznanie się z charakterystykami czasowymi podstawowych członów dynamicznych.
- Przeprowadzenie pomiarów charakterystyk czasowych członów w postaci układów elektrycznych RC.
- Nabycie umiejętności określania parametrów transmitancji członów na podstawie zmierzonych charakterystyk czasowych.

### 2. Podstawy teoretyczne

Teoria automatycznego sterowania klasyfikuje układy sterowania pod względem właściwości dynamicznych, opisanych równaniami różniczkowymi. Te same równania mogą opisywać układy o różnej strukturze fizycznej (np. układ masa – sprężyna z tłumieniem drgań i obwód elektryczny RLC)
- mówi się wówczas o analogii pomiędzy tymi układami. Analogie pozwalają na budowę i badanie modeli układów zamiast samych układów.
Układy opisane liniowymi równaniami różniczkowymi o stałych współczynnikach nazywają się układami liniowymi stacjonarnymi. Jeżeli współczynniki te zmieniają się w czasie, lecz nie są zależne od wielkości wejściowych ani wyjściowych układ nazywany jest niestacjonarnym. Układy opisane równaniami nieliniowymi noszą nazwę układów nieliniowych.
Dla układu liniowego, stacjonarnego i jednowymiarowego, tj. o jednym wejściu i jednym wyjściu zależność pomiędzy sygnałem wyjściowym y(t) (odpowiedzią układu) i wejściowym x(t) (wymuszeniem) określona jest ogólnym równaniem:
( ) ( ) | ( ) ( ) ( ) | ( )
1 | 0 | 1 | 0 b x t
dt

dx t b
dt

d x t
a y t b
dt

dy t
a
dt

d y t

a | m m
n | m

n
n ⋅ | +! ⋅ | + ⋅ | = ⋅ | +! ⋅ | + ⋅ | (1.1)

gdzie:
a i | n i , = 0! | - stałe współczynniki, zależne od struktury i od wartości parametrów układu;
bj , j = 0!m - stałe współczynniki, zależne od źródła sygnału wejściowego oraz od wartości parametrów układu i jego struktury. Rząd n najwyższej pochodnej sygnału wyjściowego występującej w równaniu nazywamy rzędem układu.
Poddając obie strony równania różniczkowego (1.1) przekształceniu Laplace’a dla zerowych warunków początkowych dostaniemy:
M (s)⋅Y (s) = N(s)⋅ X (s) | (1.2)
gdzie | 1 | 0 M (s) a s | a s a n = n | +! | + | (1.3)
1 | 0 N(s) b s | b s b m = m | +! | + | (1.4)

Ćwiczenie 1 (CS) – Charakterystyki czasowe członów dynamicznych - 2 -

Stosunek transformaty Laplace’a sygnału wyjściowego Y(s) układu do transformaty Laplace’a sygnału wejściowego X(s), przy zerowych warunkach początkowych nazywamy transmitancją operatorową układu.

( )

( )
( )
( ) ( ) | M s

N s
X s
Y s G s ≡ | = | (1.5)

Transmitancja operatorowa jest funkcją wymierną zmiennej zespolonej s. Ma ona postać ilorazu dwóch wielomianów stopnia m oraz n, przy czym dla układów realizowalnych fizycznie zawsze stopień wielomianu licznika m jest niższy lub co najwyżej równy stopniowi wielomianu mianownika n. Transmitancja operatorowa układu nie zależy od transformat wielkości wejściowej i wyjściowej. Dla danego układu jest ona wielkością stałą, zależną jedynie od natury fizycznej układu, a więc od równania różniczkowego i parametrów układu (współczynniki wielomianów N(s) i M(s) są przeważnie prostymi funkcjami parametrów – pojemności, indukcyjności, rezystancji, masy itp.). Można zatem powiedzieć, że transmitancja operatorowa określa właściwości dynamiczne układu. Znając transmitancję układu można wyznaczyć odpowiedź układu na dowolny sygnał wejściowy x(t):
( ) | [] | [ | ] ( ) | ( ) ( ) ¹ | 1
y t | L Y s | L G s X s ⁻ | − = | = | (1.6)

gdzie L⁻¹
- operator odwrotnego przekształcenia Laplace'a.

### 2.1 Najważniejsze charakterystyki czasowe

Charakterystyką czasową układu nazywamy przebieg w czasie odpowiedzi układu na określony sygnał wejściowy, podany na wejście układu będącego w stanie równowagi.
Stosowanie tych samych sygnałów wejściowych do badania różnych układów pozwala na porównanie właściwości dynamicznych tych układów. Do opisywania i porównywania własności dynamicznych układów oprócz charakterystyk czasowych stosuje się także charakterystyki częstotliwościowe, będące tematem innego ćwiczenia.
W zależności od rodzaju zastosowanego sygnału wejściowego wśród charakterystyk czasowych można rozróżnić następujące:

### 2.1.1 Charakterystyka skokowa jest to odpowiedź y(t)=h(t) układu, na którego wejście

doprowadzony został sygnał skokowy x(t) (rys.1.1.a) opisany równaniem:
x(t) = a ⋅1(t) | (1.7)

gdzie funkcja skoku jednostkowego:

≥
< = 1 | 0
0 | 0
( ) | dla t dla t
1 t | (1.8)

Transformata wymuszenia skokowego ma postać []
| s
a L x(t) = X (s) = | (1.9)
więc odpowiedź skokowa członu | [] [ | ] |
- = | = | = ⁻ | − | −
s
a h(t) L H(s) L G(s)X (s) L G(s) ¹ | 1 | 1 | (1.10)

2.1.2 Charakterystyka impulsowa układu jest to odpowiedź y(t)=k(t) układu, na którego wejście doprowadzony został sygnał w postaci impulsu Diraca x(t)=δ(t) (impuls o jednostkowej energii, nieskończonej amplitudzie i nieskończenie krótkim czasie trwania):

, | ( ) | 1
0
0 | 0
( ) | ( ) | δ | =

∞ | =
≠ = δ = | ∫
∞

−∞

t dt
dla t

dla t
x t | t | (1.11)
Ponieważ | X (s) = L[] δ(t) =1 | (1.12)
więc odpowiedź impulsowa członu: ( ) | [] [ | ] [] ( ) | ( ) ( ) | ( ) ¹ | 1 | 1 k t | L K s | L G s X s | L G s ⁻ | − | − = | = | = | (1.13)

Z zależności (1.13) wynika, że charakterystyka impulsowa układu, zwana także funkcją wagi, jest odwrotną transformatą Laplace'a transmitancji układu. Impuls Diraca przedstawia rys.1.1.b.

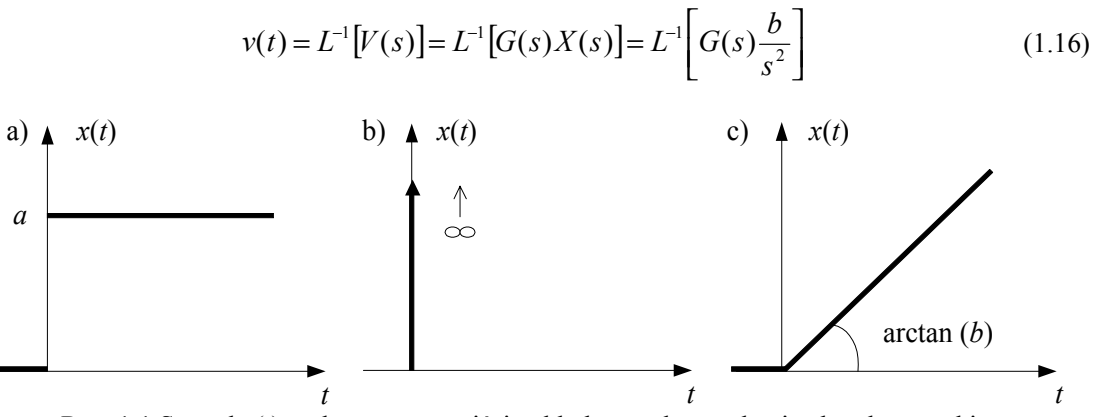
[picture p81: figure]
arctan (b)

Ćwiczenie 1 (CS) – Charakterystyki czasowe członów dynamicznych | - 3 -

2.1.3 Charakterystyka liniowo-czasowa jest to odpowiedź y(t)=v(t) układu, na którego wejście doprowadzony został sygnał x(t) liniowo zależny od czasu (rys.1.1.c):

⋅ | ≥
< = | 0
0 | 0
( ) | b t t

t
x t | (1.14)
Ponieważ | [] 2 ( ) | ( )
s
b X s = L x t = | (1.15)

więc charakterystyka liniowo-czasowa członu:
[] [ | ] |
- = | = | = ⁻ | − | −

Rys. 1.1 Sygnał x(t) podawany na wejście układu w celu uzyskania charakterystyki:
a) skokowej b) impulsowej c) liniowo-czasowej

### 2.2 Charakterystyki czasowe członów podstawowych

Członem układu automatyki nazywamy urządzenie lub układ o wyodrębnionym wejściu i wyjściu będący częścią składową tego układu. Okazuje się, że istnieje ograniczona ilość liniowych członów podstawowych, a wszystkie inne układy liniowe można przedstawić jako ich połączenie; schemat układu przedstawiający te połączenia nazywa się schematem strukturalnym (blokowym).
Poniżej podano transmitancje oraz charakterystyki skokowe wszystkich członów podstawowych, oraz charakterystyki impulsowe i liniowo-czasowe dla niektórych członów.

### 2.2.1 Człon bezinercyjny (proporcjonalny) P

Transmitancja członu ma postać | G(s) = k | (1.17)

gdzie k - współczynnik wzmocnienia, określony jako stosunek odpowiedzi do wymuszenia.

W członie bezinercyjnym w każdej chwili czasu sygnał wyjściowy jest proporcjonalny do sygnału wejściowego.

Odpowiednie charakterystyki czasowe dane są wzorami:

- skokowa
s
| a H(s) = k , | h(t) = k ⋅ a ⋅1(t) | (1.18)
- impulsowa | K(s) = k , | k(t) = k ⋅δ(t) | (1.19)
- liniowo-czasowa | 2 ( )
s
b V s = k | , | v(t) = k ⋅b⋅t ⋅1(t) | (1.20)

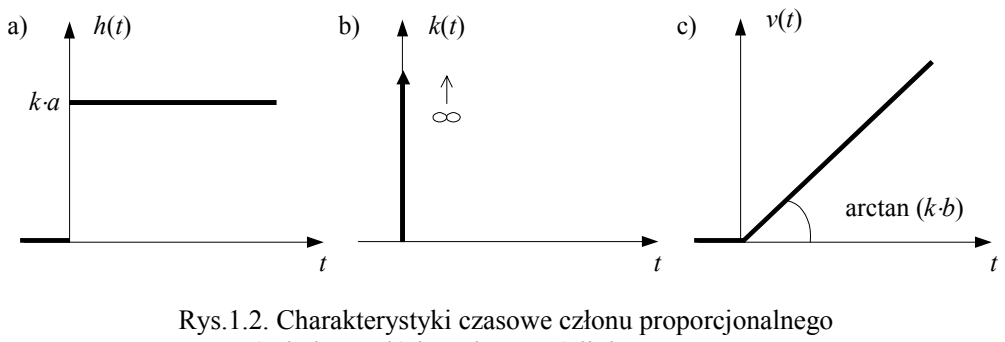
[picture p82: figure]
arctan (k⋅b); Rys.1.2. Charakterystyki czasowe członu proporcjonalnego
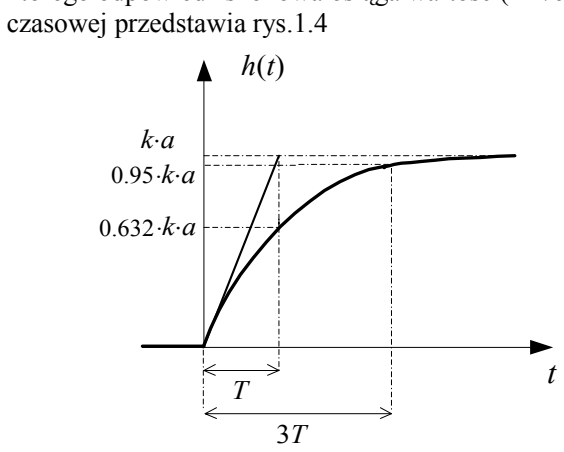
[picture p83: figure]
czasowej przedstawia rys.1.4 h(t)

Ćwiczenie 1 (CS) – Charakterystyki czasowe członów dynamicznych - 4 -a) skokowa b) impulsowa c) liniowo-czasowa

Przykładem realizacji członu proporcjonalnego jest rezystancyjny dzielnik napięcia z rys.1.3. Transmitancja czwórnika:

k
R R
R G s | = + =
1 | 2
2 ( ) | (1.21)

R1

R x(t) | 2 | y(t)

Rys.1.3. Czwórnik proporcjonalny

### 2.2.2 Człon inercyjny pierwszego rzędu

Transmitancja członu:

1 ( )

+ = Ts

k G s | (1.22)

gdzie T – stała czasowa
Odpowiedź czasowa członu na skutek pewnej bezwładności (inercji) charakteryzuje się występowaniem stanu przejściowego, po zaniknięciu którego sygnał wyjściowy staje się proporcjonalny do sygnału wejściowego (ze współczynnikiem proporcjonalności k).
Dla odpowiedzi skokowej członu mamy:

s

a
Ts

k H s
( | 1) ( )
+ = | , h(t) k a (1 e ) (t) T

t
= ⋅ ⋅ − ⋅1 ⁻
(1.23)

Stała czasowa T charakteryzuje prędkość zmian przebiegu przejściowego. Jest to czas, po upływie którego odpowiedź skokowa osiąga wartość (1-1/e)⋅k⋅a=0.632⋅k⋅a. Interpretację geometryczną stałej

h(t)

t

T1
T2
T3

T1 < T2 < T3

k⋅a

Rys.1.4. Charakterystyka skokowa członu inercyjnego I-go rzędu

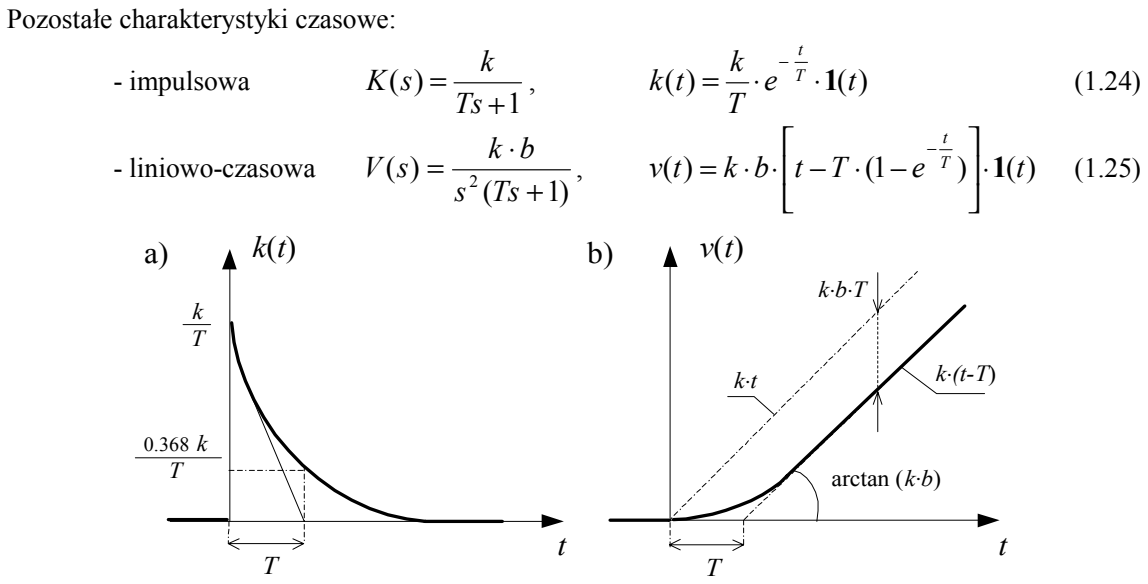
[picture p84: figure]
Pozostałe charakterystyki czasowe:; - impulsowa; - liniowo-czasowa; arctan (k⋅b)

Ćwiczenie 1 (CS) – Charakterystyki czasowe członów dynamicznych | - 5 -

Rys.1.5. Charakterystyki czasowe członu inercyjnego I-go rzędu
a) impulsowa b) liniowo-czasowa

Przykład realizacji członu inercyjnego przedstawia rys.1.6.

Transmitancja czwórnika

RCs

G s

+ =
1
1 ( ) | (1.26)

(k=1, T=RC)

R

x(t) | C | y(t)

Rys.1.6. Czwórnik RC inercyjny.

### 2.2.3 Człon całkujący idealny I

Transmitancja członu:
s T s

k G s

i

1 ( ) = = | (1.27)

gdzie Ti – czas całkowania
W członie całkującym idealnym sygnał wyjściowy jest proporcjonalny do całki sygnału wejściowego.
Odpowiedź skokowa ma postać: | 2 ( )
s
k a H s | ⋅ = | , | h(t) = k ⋅ a ⋅t ⋅1(t) | (1.28)

Jeżeli na wejściu członu całkującego idealnego pojawi się sygnał stały to sygnał wyjściowy będzie narastał w funkcji czasu liniowo. Współczynnik k reprezentuje stosunek pochodnej względem czasu (prędkości) odpowiedzi do wartości wymuszenia, stąd też nazywany jest wzmocnieniem prędkościowym.
Pozostałe charakterystyki czasowe:
- impulsowa
s
k K(s) = , | k(t) = k ⋅1(t) | (1.29)
- liniowo-czasowa | 3 ( )
s
b V s = k , | ( ) 2 ( ) | 2
t | t

k b

v t | ⋅ ⋅1 ⋅ = | (1.30)

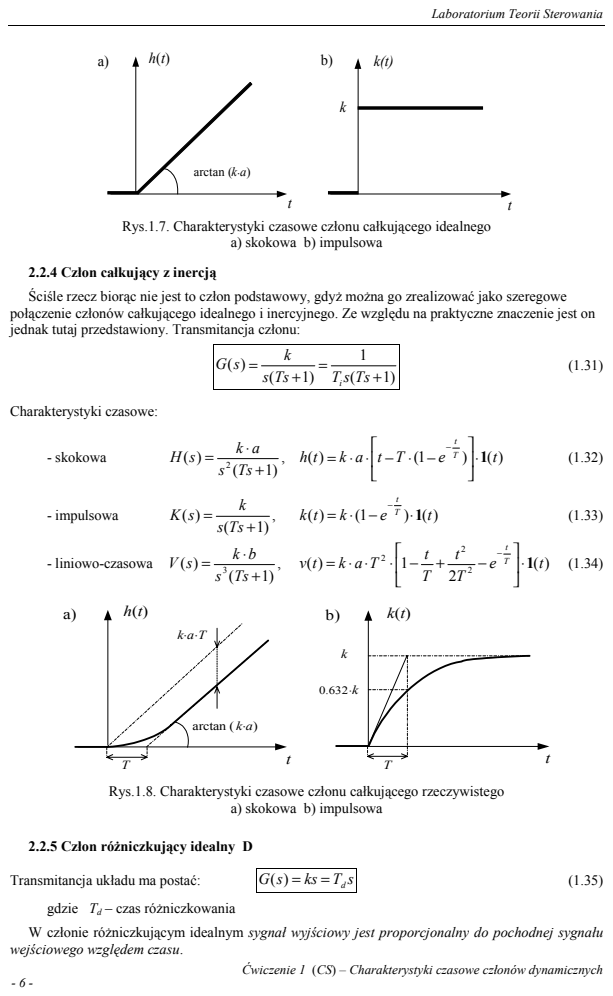
[picture p85: page 6]
arctan (k⋅a); a) skokowa b) impulsowa; Charakterystyki czasowe:; - skokowa; - impulsowa; - liniowo-czasowa; arctan ( k⋅a); Transmitancja układu ma postać:

Rys.1.7. Charakterystyki czasowe członu całkującego idealnego

2.2.4 Człon całkujący z inercją
Ściśle rzecz biorąc nie jest to człon podstawowy, gdyż można go zrealizować jako szeregowe
połączenie członów całkującego idealnego i inercyjnego. Ze względu na praktyczne znaczenie jest on
jednak tutaj przedstawiony. Transmitancja członu:

Rys.1.8. Charakterystyki czasowe członu całkującego rzeczywistego

2.2.5 Człon różniczkujący idealny D

gdzie Td – czas różniczkowania
W członie różniczkującym idealnym sygnał wyjściowy jest proporcjonalny do pochodnej sygnału
wejściowego względem czasu.

Ćwiczenie 1 (CS) – Charakterystyki czasowe członów dynamicznych

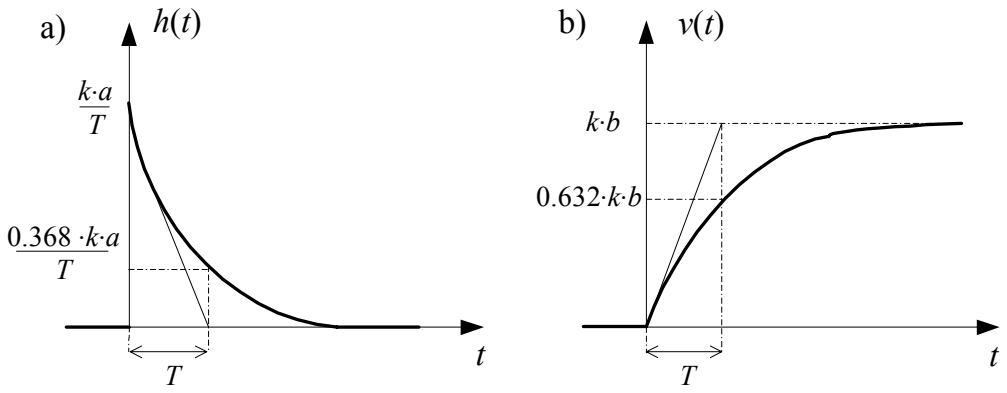
[picture p86: figure]

Ćwiczenie 1 (CS) – Charakterystyki czasowe członów dynamicznych | - 7 -

Ponieważ stopień licznika transmitancji jest wyższy od stopnia mianownika człon ten jest niemożliwy do zrealizowania w praktyce i może być modelowany jedynie w przybliżeniu.
Charakterystyki czasowe: skokowa i liniowo-czasowa są postaci:
H(s) = ka , | h(t) = k ⋅ a ⋅δ(t) | (1.36)

s

b V (s) = k , | v(t) = k ⋅b⋅1(t) | (1.37)
a) | h(t) | v(t)

k⋅b

b)

t | t
Rys.1.9. Charakterystyki czasowe członu różniczkującego idealnego
a) skokowa b) liniowo-czasowa

### 2.2.6 Człon różniczkujący z inercją

Człon różniczkujący rzeczywisty jest układem złożonym z szeregowo połączonych członów: inercyjnego i różniczkującego idealnego. Ma on duże znaczenie praktyczne, gdyż każdy fizycznie realizowalny człon różniczkujący posiada pewną inercję.

Transmitancja członu:

1 ( )

+ = Ts

ks G s | (1.38)

Charakterystyki czasowe:

- skokowa

1 ( )
+

⋅ = Ts
k a H s | , | ( ) | e | (t) T
k a h t | T

t
⋅1 ⋅ = −
(1.39)
- liniowo-czasowa

( 1) ( )
+

⋅ = s Ts
k b V s | , | v(t) k b (1 e ) (t) T

t
= ⋅ ⋅ − ⋅1 ⁻
(1.40)

Rys.1.10. Charakterystyki czasowe członu różniczkującego rzeczywistego
a) skokowa b) liniowo-czasowa

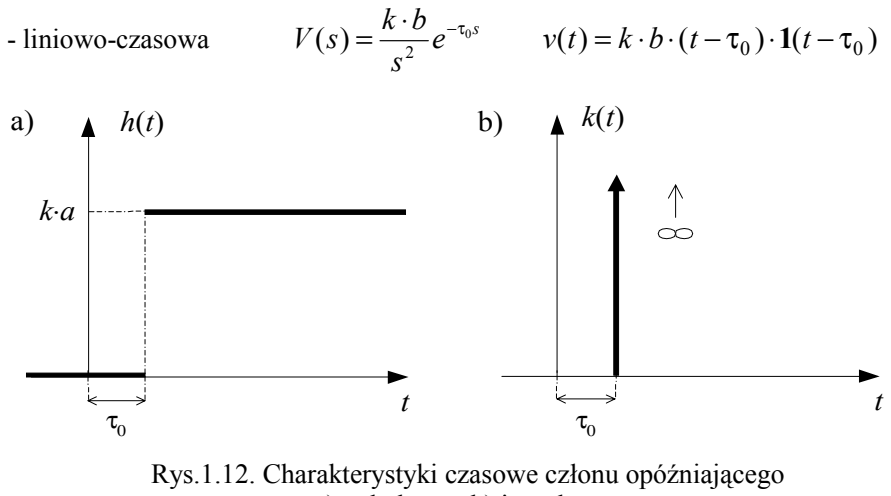
[picture p87: figure]
- liniowo-czasowa; Rys.1.12. Charakterystyki czasowe członu opóźniającego

Ćwiczenie 1 (CS) – Charakterystyki czasowe członów dynamicznych
- 8 -

Przykładem realizacji członu różniczkującego rzeczywistego jest czwórnik z rys.1.11. Transmitancja czwórnika:

RCs

RCs G s
+ =
1 ( ) | (1.41)

(k=RC, T=RC)

C

x(t) | R | y(t)

Rys.1.11. Czwórnik RC różniczkujący rzeczywisty

### 2.2.7 Człon opóźniający (opóźnienie transportowe)

Transmitancja: | s G s | k e 0 ( ) | −τ = ⋅ | (1.42)

Sygnał na wyjściu członu opóźniającego pojawia się nie w chwili doprowadzenia sygnału wejściowego, lecz po upływie czasu oznaczonego przez τ0.
Charakterystyki czasowe:
- skokowa | s e
s
k a H s | 0 ( ) | −τ ⋅ = | ( ) | ( | ) 0 h t = k ⋅ a ⋅1 t − τ | (1.43)
- impulsowa | s K s | k e 0 ( ) | −τ = ⋅ | ( ) | ( | ) 0 k t = k ⋅δ t − τ | (1.44)
2 ( ) | −τ ⋅ = | ( ) | ( | ) ( | ) 0 | 0 v t = k ⋅b⋅ t − τ ⋅1 t − τ | (1.45)
a) skokowa b) impulsowa

### 2.2.8 Człon oscylacyjny drugiego rzędu

Transmitancja członu jest postaci: | 2 | 2

2
2 ( )
n | n

n
s | s

k G s

### + ζω + ω

ω = | (1.46)
gdzie | ωn - pulsacja drgań nietłumionych
ζ - współczynnik tłumienia

Odpowiedź skokowa członu:
s | s | s

a k H s

n | n

n
( | 2 | ) ( ) | 2 | 2

2

### + ζω + ω

⋅ ⋅ω = | (1.47)

( ) 1 sin
1
( ) | 1

2

2

t arctan | t
e h t | k a | d

t n
⋅1
ζ

− ζ ω ⋅ +
− ζ

= ⋅ ⋅ −

−ζω
(1.48)

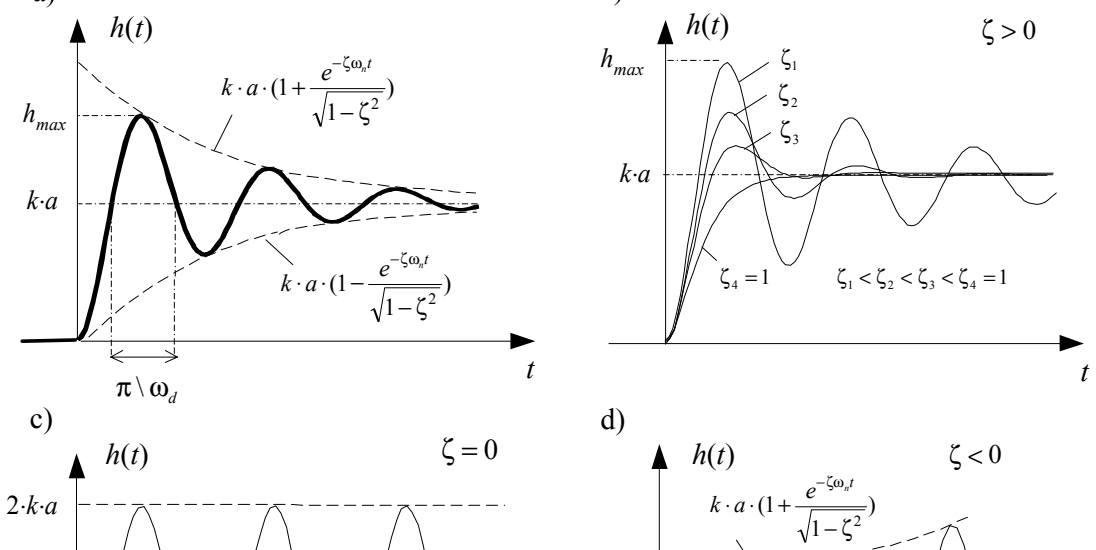
[picture p88: figure]
hmax
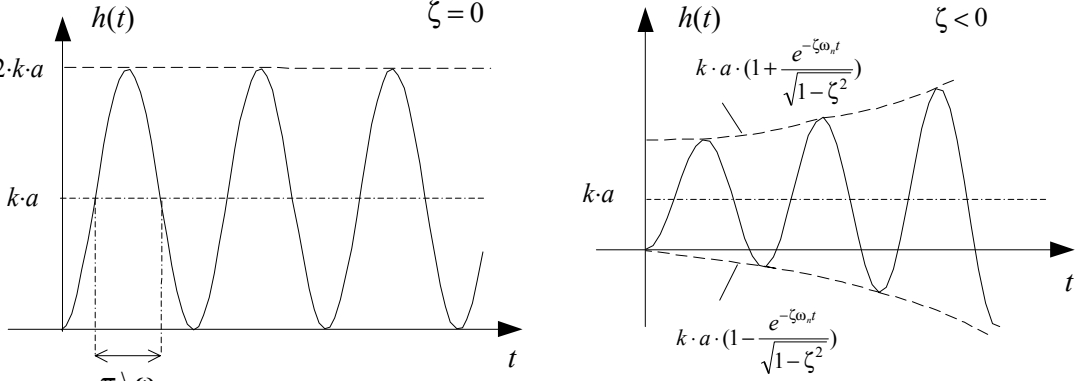
[picture p89: figure]

Ćwiczenie 1 (CS) – Charakterystyki czasowe członów dynamicznych | - 9 -
gdzie wielkość | 2 ω = ω 1− ζ d | n | jest tzw. pulsacją drgań tłumionych.

Przebieg czasowy odpowiedzi skokowej członu jest przebiegiem oscylacyjnym o pulsacji ωd. O charakterze oscylacji decyduje współczynnik tłumienia drgań ζ (w zależności od wartości ζ wykładnik potęgi funkcji wykładniczej we wzorze (1.48) jest ujemny, dodatni lub równy zeru). Możemy wyróżnić trzy przypadki:
- dla 0<ζ<1 i amplituda oscylacji maleje tzw. drgania tłumione (rys.1.13.a,b),
- dla ζ=0 występują oscylacje o stałej amplitudzie (rys.1.13.c),
- dla -1<ζ<0 amplituda oscylacji rośnie do nieskończoności (rys.1.13.d).

Dla ζ²
>1 człon przestaje być oscylacyjnym i staje się członem inercyjnym drugiego rzędu (szeregowe połączenie dwóch członów inercyjnych pierwszego rzędu).

### π ωn \

a) b)

Rys.1.13.Charakterystyka skokowa członu oscylacyjnego drugiego rzędu dla różnych wartości współczynnika tłumienia ζ. Odpowiedź impulsowa członu:

2 | 2
| 2
2 ( )
n | n n
s | s

k K s

### + ζω +ω

⋅ω = | (1.49)

( )

1
sin
1

( )

2

2

t arctan | t
e k t | k | d

t n
⋅1
ζ

− ζ ω ⋅ +
− ζ

=

− ζω
(1.50)

Ćwiczenie 1 (CS) – Charakterystyki czasowe członów dynamicznych
- 10 -

### 2.2.9 Człony korekcyjne pierwszego rzędu

Ogólna postać transmitancji członów korekcyjnych jest następująca:

T s

T s G s k

2

1
1

1 ( )
+
+ = | (1.51)
gdzie | k - współczynnik wzmocnienia
T1, T2 - stałe czasowe
Zależnie od tego, która stała czasowa jest większa, człon korekcyjny przyspiesza lub opóźnia fazę w układzie korygowanym.
a) Człon opóźniający fazę
Jeżeli w wyrażeniu na transmitancję członu korekcyjnego dwie stałe czasowe zastąpi się jedną i współczynnikiem α równym stosunkowi T1/T2, to transmitancja członu opóźniającego przyjmie następującą postać:

, 1
1
1 ( ) | α >
+ α
+ = | Ts
Ts G s | (1.52)

Przebieg odpowiedzi skokowej członu opisany jest wyrażeniem
( ) 1 h(t) a 1 e | e | t T

t
T

t
⋅1
α = ⋅ − | + | α

− α −
(1.53)

i przedstawiony jest na rys.1.14.a.

t

R1

C2

R2

h(t)

αT

a
α

a

a) b)
x(t) | y(t)

Rys.1.14. Człon korekcyjny opóźniający fazę
a) charakterystyka skokowa b) realizacja fizyczna Przykładem członu korekcyjnego opóźniającego fazę jest czwórnik RC z rys.1.14.b. Dla przedstawionego układu parametry T i α określone są wzorami

T = R2C2 ,

2

1 2
R

R + R
α = | (1.54)
b) Człon przyspieszający fazę (forsujący)
W przypadku, gdy w ogólnym wyrażeniu na transmitancję członu korekcyjnego stała czasowa T2 jest większa od stałej czasowej T1 tzn. α<1 człon korekcyjny przyspiesza fazę, a jego transmitancję określa się następująco:

, 1
1
1 ( ) | α <
+ α

+ = α
Ts
Ts G s | (1.55)

Przebieg odpowiedzi skokowej członu wyrażony jest równaniem:

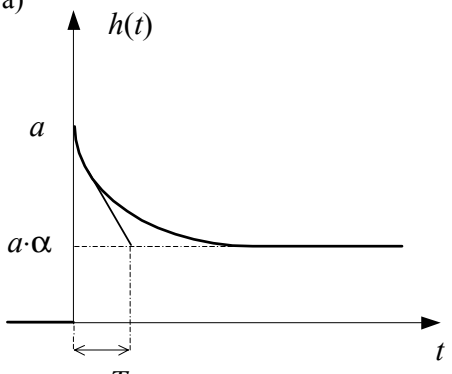
[picture p90: figure]

Ćwiczenie 1 (CS) – Charakterystyki czasowe członów dynamicznych | - 11 -
h(t) a | 1 e | e | (t) T

t
T

t
⋅1
+
- = ⋅ α⋅ − | α
− α −
(1.56)

Przykładową realizację członu przyspieszającego fazę przedstawia rys.1.15.b. Parametry czwórnika oblicza się następująco

T = R1C1 ,

1 2

2
R R

R
+
α = | (1.57)

α⋅T

C1 | R2

R1

a) b)
x(t) | y(t)

Rys. 1.15. Człon korekcyjny przyspieszający fazę
a) charakterystyka skokowa b) realizacja fizyczna

### 2.2.10 Człon korekcyjny drugiego rzędu opóźniająco - przyspieszający fazę

W pewnych przypadkach zachodzi potrzeba stosowania korekcji zapewniającej przy niższych częstotliwościach opóźnienie, a przy wyższych przyspieszenie fazy. Można wtedy zastosować korektor, którego działanie jest analogiczne do szeregowego połączenia członu opóźniającego i członu przyspieszającego fazę. Transmitancja takiego członu jest następująca

(1 | )(1 | )
(1 | )(1 | ) ( )

2
1
1 | 2
s

T T s

T s T s G s

α

+ α | +
+ | + = | (1.58)

Odpowiedź skokowa członu
( ) | 1 | ( ) ¹ | 2 h t | a | A e | e | t t T | T

t
⋅1
- = ⋅ + ⋅ −
α − α −
gdzie

( )

α

α −

- − α
α −
= | 2

1

1 | 2 | 1 1

T T

T T
A | (1.59)

Przykładem opisanego członu jest czwórnik RC z rys.1.16.b. Transmitancja członu ma postać:

( | ) 1
(1 | )(1 | ) ( )
1 1 | 2 2 | 1 2

2
1 2 1 2
1 1 | 2 2
+ | + | + | +
+ | + = R R C C s | R C R C | R C s
R C s | R C s G s | (1.60)

Po wprowadzeniu następujących oznaczeń :
T1 = R1C1 , T2 = R2C2 | (1.61)

wyrażenie na transmitancję przyjmie postać ogólną (1.58). (Wartość liczbowa stałej α jest w przybliżeniu równa

2

1 2
R

R + R ).

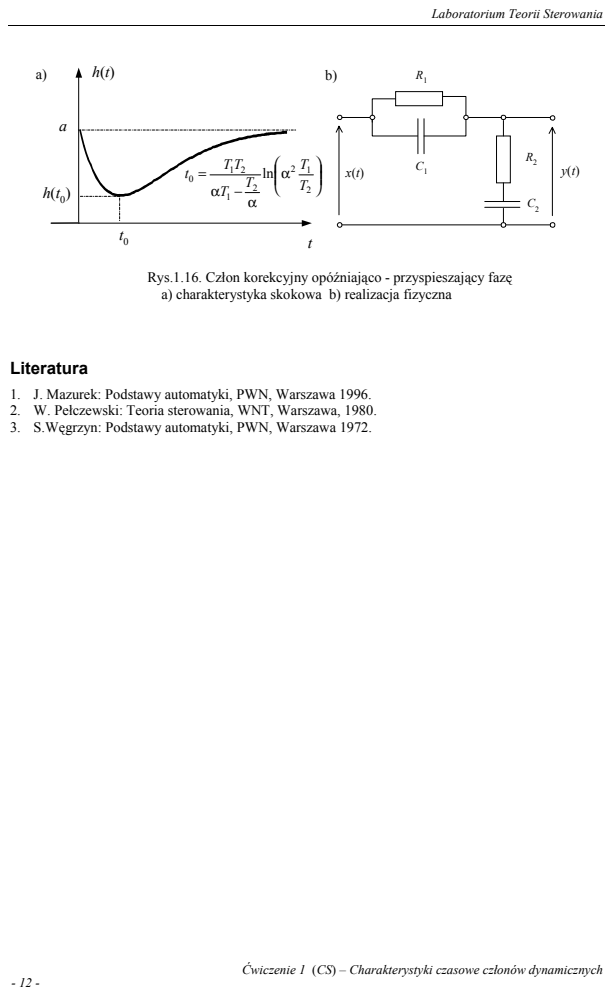
[picture p91: page 12]

Rys.1.16. Człon korekcyjny opóźniająco - przyspieszający fazę
a) charakterystyka skokowa b) realizacja fizyczna

Literatura
1. J. Mazurek: Podstawy automatyki, PWN, Warszawa 1996.
2. W. Pełczewski: Teoria sterowania, WNT, Warszawa, 1980.
3. S.Węgrzyn: Podstawy automatyki, PWN, Warszawa 1972.

Ćwiczenie 1 (CS) – Charakterystyki czasowe członów dynamicznych

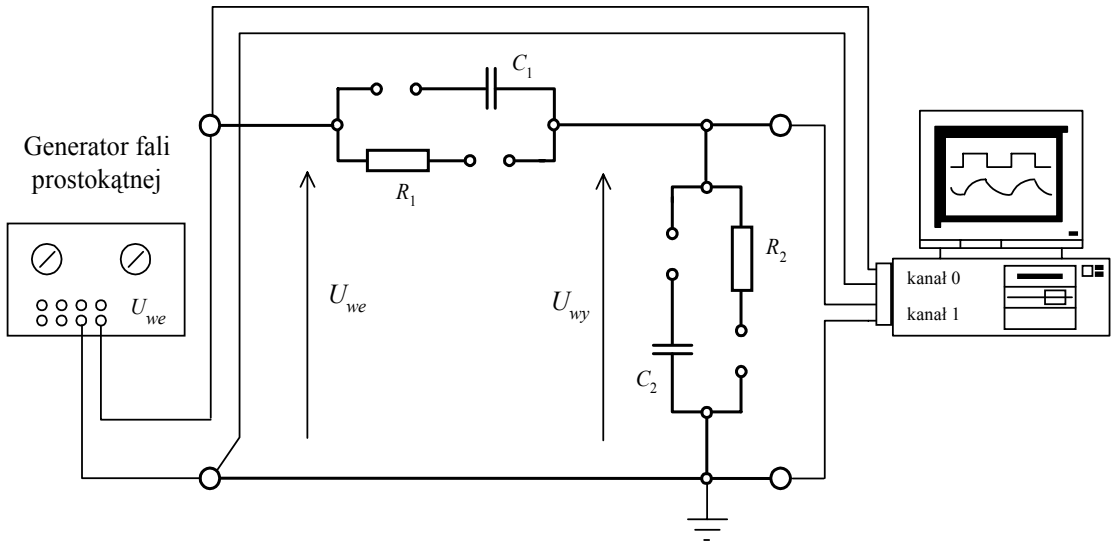
[picture p92: figure]
Uwe; Generator fali prostokątnej; kanał 0; kanał 1

Ćwiczenie 1 (CS) – Charakterystyki czasowe członów dynamicznych | - 13 -

### 3. Przebieg ćwiczenia

Ćwiczenie polega na badaniu charakterystyk skokowych członów dynamicznych zrealizowanych w formie czwórników RC. Charakterystyki poszczególnych członów zdejmowane są w układzie pomiarowym pokazanym na rys.1.17.

Rys.1.17. Układ pomiarowy do zdejmowania charakterystyk czasowych

Zamiast pojedynczego sygnału skokowego na wejście badanego członu doprowadza się z generatora ciąg okresowo powtarzających się sygnałów skokowych (falę prostokątną). Na wyjściu otrzymujemy przebieg okresowy, złożony z ciągu charakterystyk skokowych danego członu. Graficzna prezentacja przebiegów jest uzyskiwana za pomocą komputerowego programu scope (prosty, cyfrowy oscyloskop). Na kanale 0 obserwujemy sygnał wejściowy z generatora Uwe, a na kanale 1 sygnał wyjściowy z czwórnika Uwy.

W celu dokonania ćwiczenia należy:
1. Uruchomić program scope.exe.
2. Przejść do okna graficznego (poleceniem Run z menu górnego).
3. Połączyć badany czwórnik na tablicy ćwiczenia (zanotować wartości elementów RC).
4. Naciskając klawisz <Enter> uruchomić rejestrację.
Na monitorze powinien być uzyskiwany możliwie duży, pojedynczy przebieg. W tym celu:
- szerokością przebiegu sterować poprzez ewentualną zmianę skali czasu (opcja Time/Div.) i częstotliwość sygnału z generatora. Zanotować wartość podziałki czasu!,
- wysokość przebiegu dobrać poprzez zmianę wzmocnienia obu kanałów (opcja V. Scale) oraz amplitudę napięcia z generatora.
5. Wydrukować uzyskany przebieg wykorzystując opcję H.Copy (poprzez dwukrotne naciśnięcie klawisza c).
6. Dokonać ponownej rejestracji i wydruku przebiegu przy innych wartościach elementów RC (tak, aby przebiegi różniły się od siebie np. dużą i małą stałą czasową).
7. Sprawdzić, jaki wpływ na kształt charakterystyki skokowej ma zmiana poszczególnych elementów R i C członu.
Do jakich członów zbliża się badany człon właściwościami:
- przy bardzo małej stałej czasowej,
- przy bardzo dużej stałej czasowej.

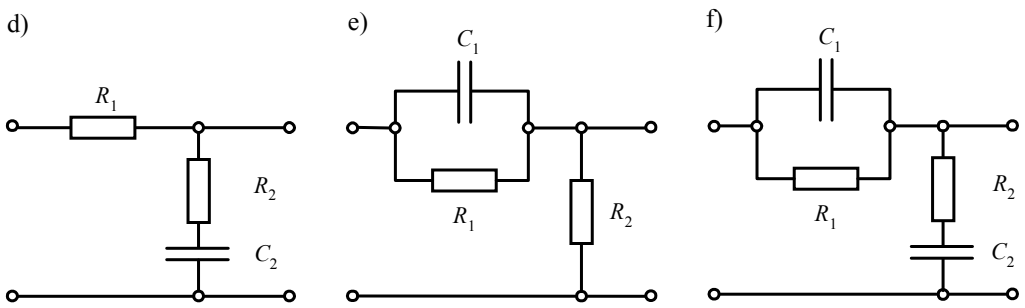
[picture p93: figure]

Ćwiczenie 1 (CS) – Charakterystyki czasowe członów dynamicznych
- 14 -

Punkty 3-7 powtórzyć dla kolejnych czwórników RC. Czwórniki należy łączyć w następującej kolejności:
- proporcjonalny
- inercyjny I-go rzędu
- różniczkujący rzeczywisty
- opóźniający fazę
- przyspieszający fazę
- opóźniająco-przyspieszający fazę
Schematy poszczególnych członów pokazano na rys.1.18.
a) c)

R1

R2

b)

R1

C2

C1

R2

Rys. 1.18 Zestaw czwórników RC badanych w ćwiczeniu:
a) proporcjonalny, b) inercyjny I-go rzędu, c) różniczkujący rzeczywisty, d) opóźniający fazę,
e) przyspieszający fazę, f) opóźniająco-przyspieszający fazę

### 4. Opracowanie sprawozdania

Sprawozdanie powinno zawierać dla każdego badanego czwórnika:
1. Schemat połączeń i wartości elementów RC,
2. Teoretycznie wyprowadzenie transmitancji operatorowej G(s) członu. Wyrażenie parametrów transmitancji: T, k (ewentualnie α) jako funkcji odpowiednich elementów RC i wyznaczenie ich wartości liczbowej (patrz przykład obliczeniowy) - dla każdego z członów parametry transmitancji oblicza się dla dwóch wybranych wcześniej wartości elementów RC,
3. Graficzne wyznaczenie z wykresów parametrów transmitancji i porównanie ich z wartościami uzyskanymi w punkcie poprzednim,
4. Omówienie zaobserwowanego wpływu zmian wartości poszczególnych elementów R i C członu na kształt charakterystyki skokowej (powiązać parametry RC ze stałą czasową T, współczynnikiem wzmocnienia k, ewentualnie współczynnikiem α).
Sprawdzić zgodność obserwacji z wyliczeniami teoretycznymi. Omówić możliwe przyczyny ewentualnych rozbieżności wyników doświadczalnych i teoretycznych oraz przedyskutować granicę zaufania do wyników identyfikacji eksperymentalnej.

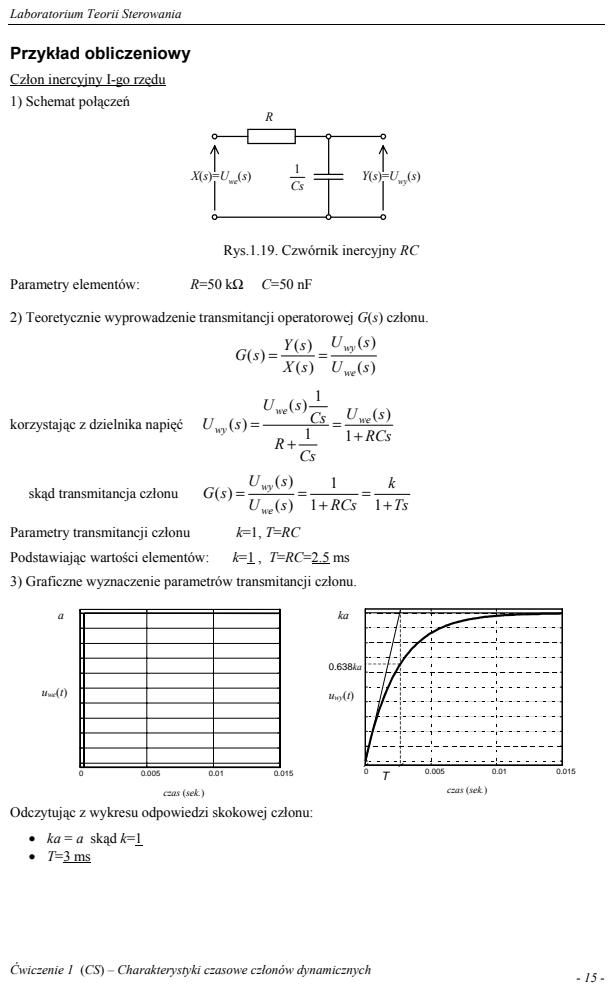
[picture p94: page 15]
Ćwiczenie 1 (CS) – Charakterystyki czasowe członów dynamicznych; X(s)=Uwe(s); Y(s)=Uwy(s); Parametry elementów:; korzystając z dzielnika napięć; RCs; Parametry transmitancji członu; Podstawiając wartości elementów:; czas (sek.); uwe(t); uwy(t)

Przykład obliczeniowy
Człon inercyjny I-go rzędu
1) Schemat połączeń

Rys.1.19. Czwórnik inercyjny RC

2) Teoretycznie wyprowadzenie transmitancji operatorowej G(s) członu.

skąd transmitancja członu

3) Graficzne wyznaczenie parametrów transmitancji członu.

Odczytując z wykresu odpowiedzi skokowej członu:
• ka = a skąd k=1
