KarolKaim/-masterThesis/masterThesisWork/EagleProject/connectionSchematic.png

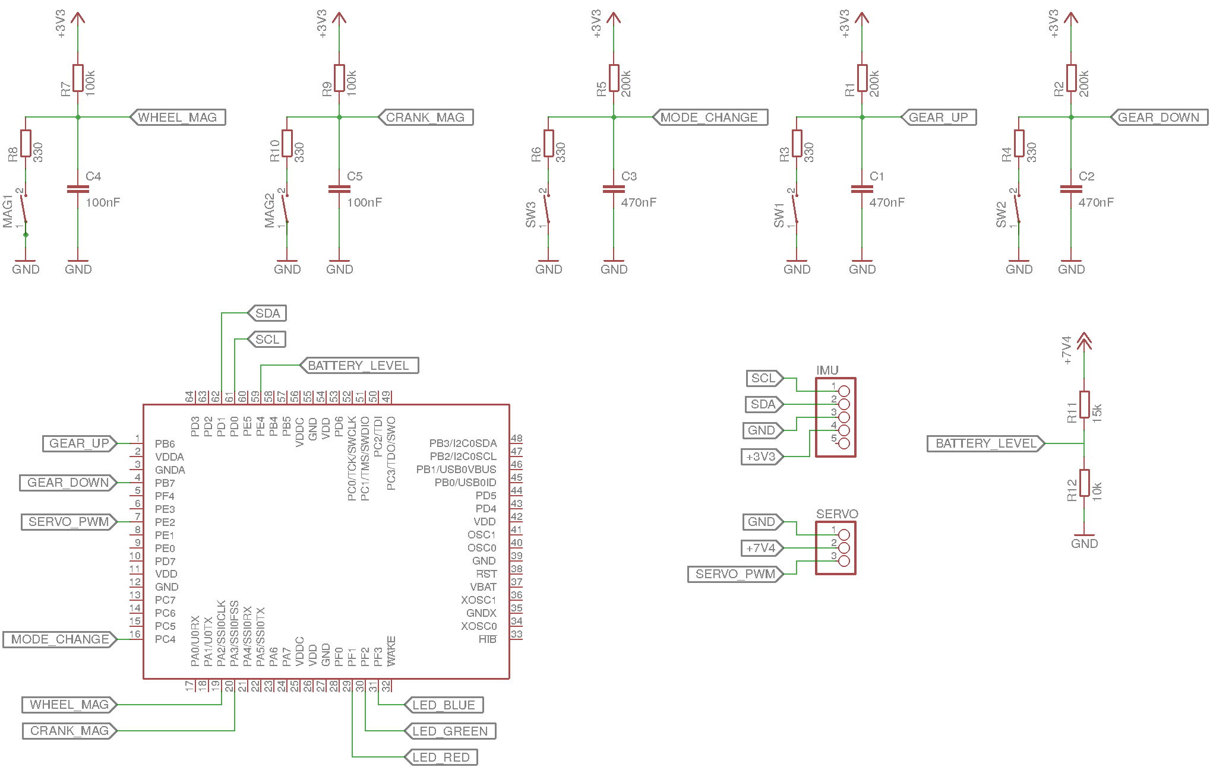
masterThesisWork/EagleProject/connectionSchematic.png
