KarolKaim/-masterThesis/masterThesisWork/images/angleComparison.png

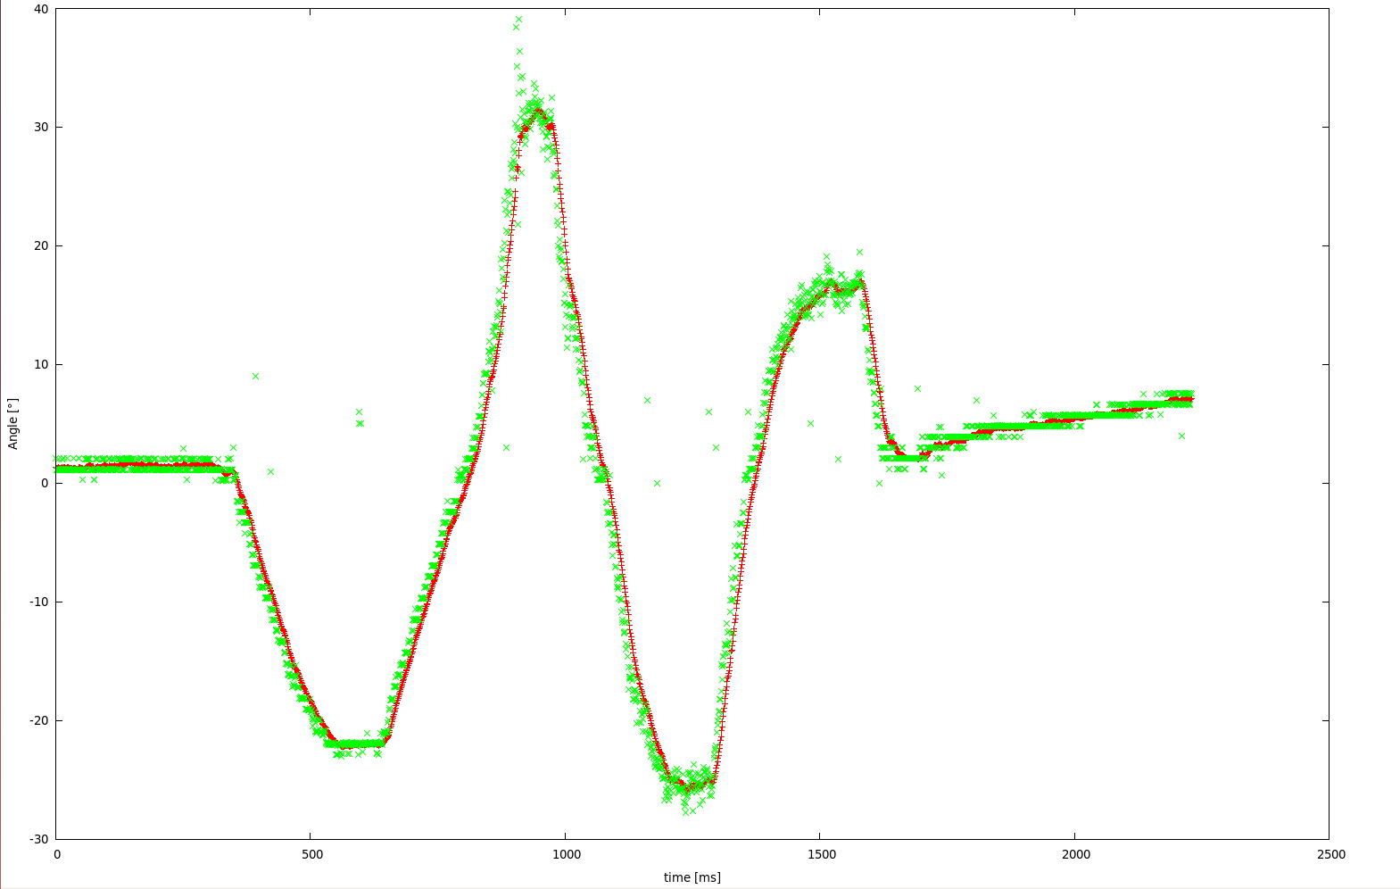
masterThesisWork/images/angleComparison.png
