KarolKaim/-masterThesis/masterThesisWork/images/dzielnikNapiecia.bmp

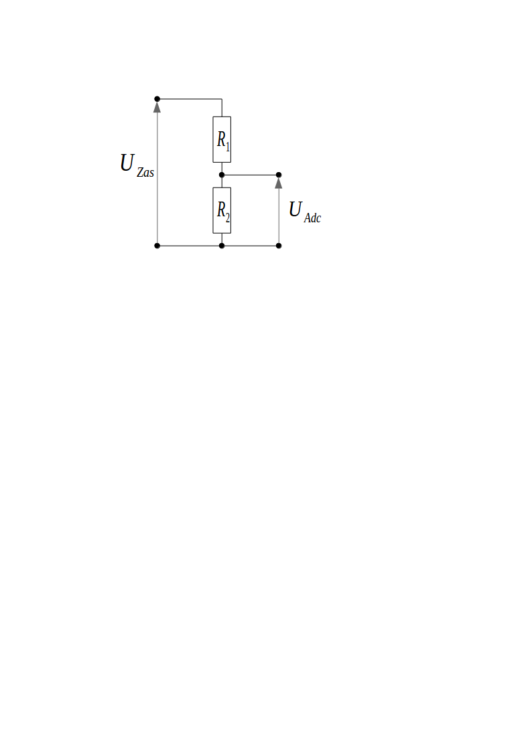
masterThesisWork/images/dzielnikNapiecia.bmp
