KarolKaim/-masterThesis/masterThesisWork/images/rodzajePrzekladni.jpg

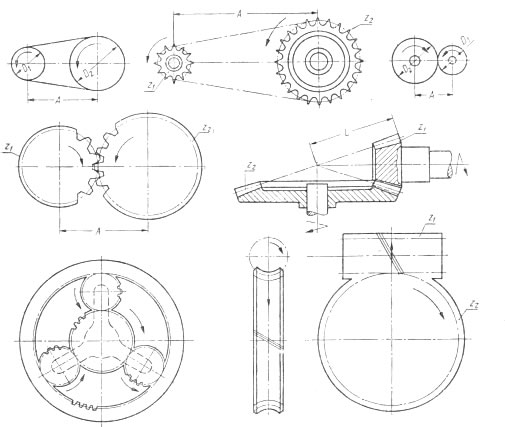
masterThesisWork/images/rodzajePrzekladni.jpg
