KarolKaim/-masterThesis/masterThesisWork/images/schematAlgorytmu.png

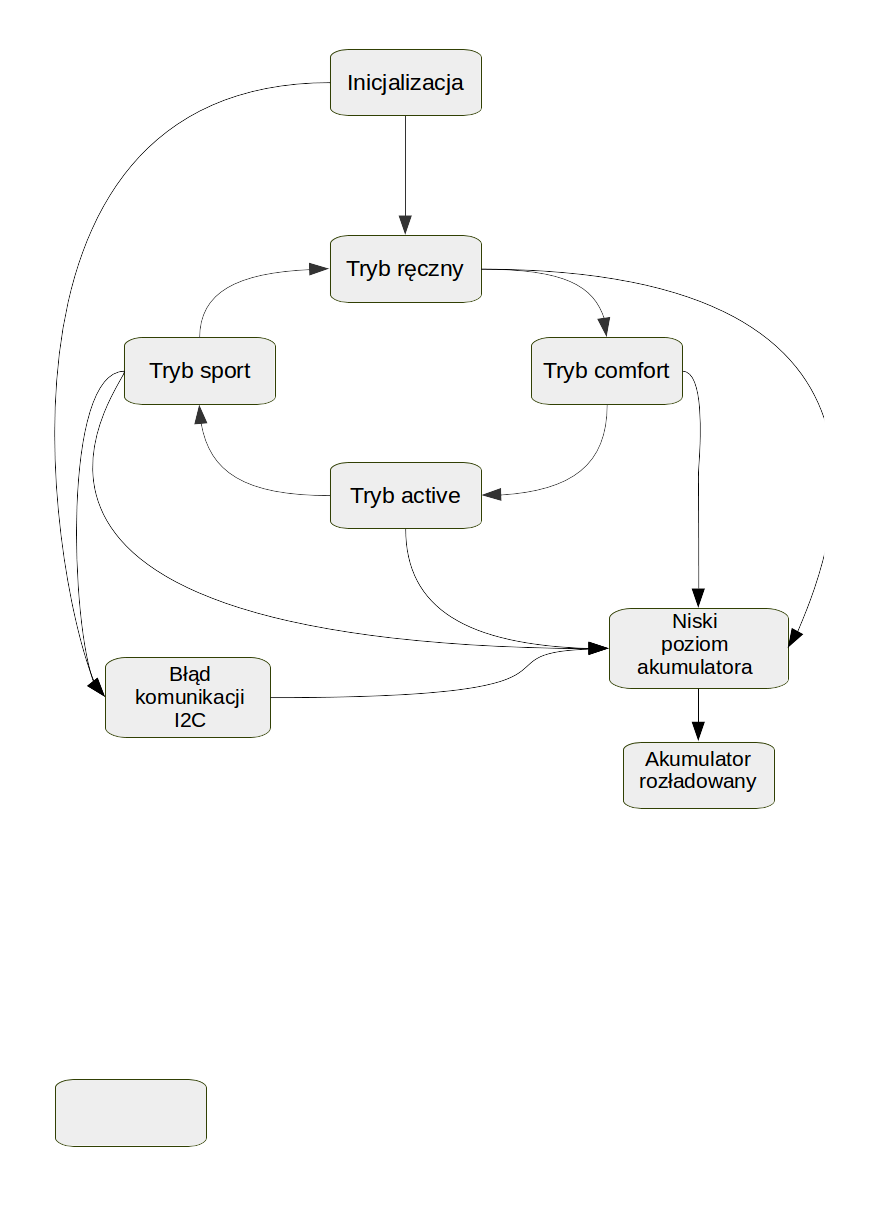
masterThesisWork/images/schematAlgorytmu.png
