KarolKaim/-masterThesis/usefulDocuments/rcFilter.png

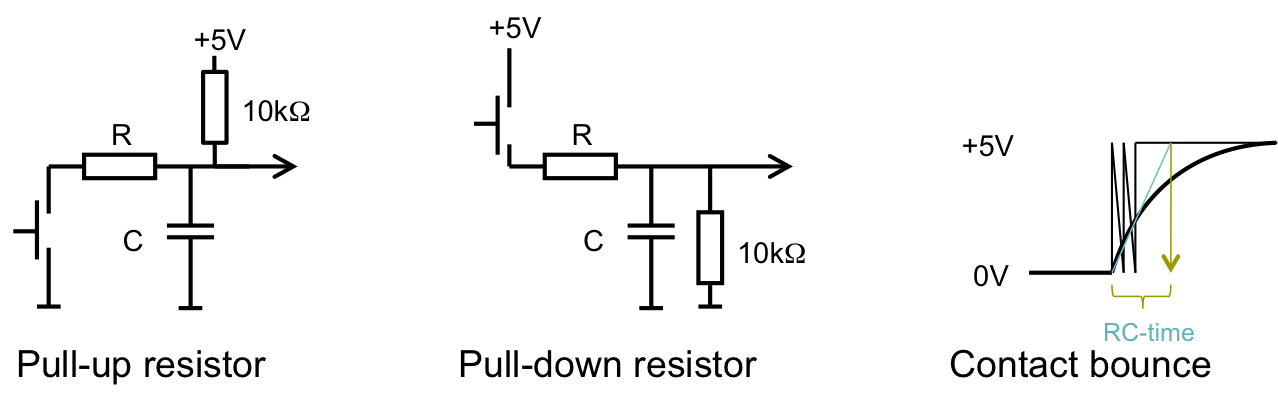
usefulDocuments/rcFilter.png
