KarolKaim/-masterThesis/masterThesisWork/3DCadModels/Lacznik.fcstd

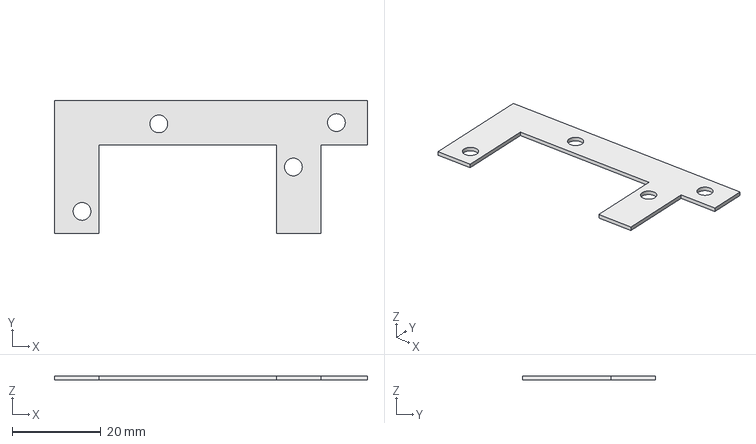
[picture p101: CAD file, 2016-08-01]
masterThesisWork/3DCadModels/Lacznik.fcstd
70.5 x 30.0 x 1.00 mm
