KarolKaim/-masterThesis/masterThesisWork/3DCadModels/wszystko.fcstd

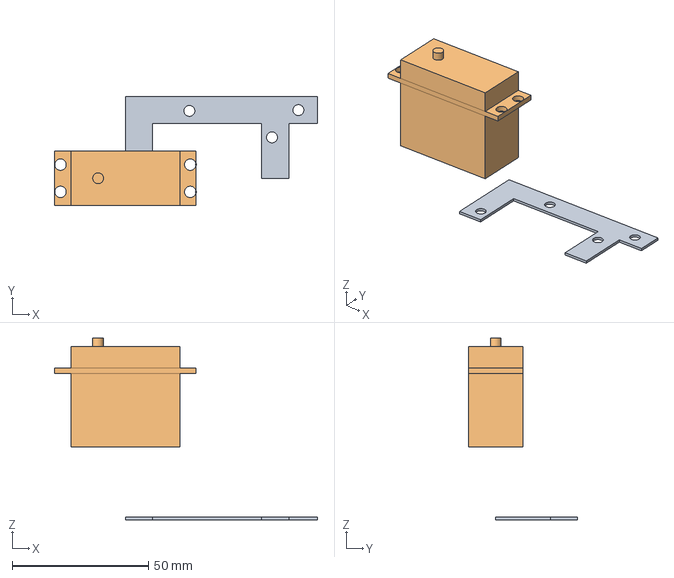
[picture p102: CAD file, 2016-08-01]
masterThesisWork/3DCadModels/wszystko.fcstd
96.5 x 40.0 x 66.7 mm
