KarolKaim/-masterThesis/masterThesisWork/3DCadModels/Servo.fcstd

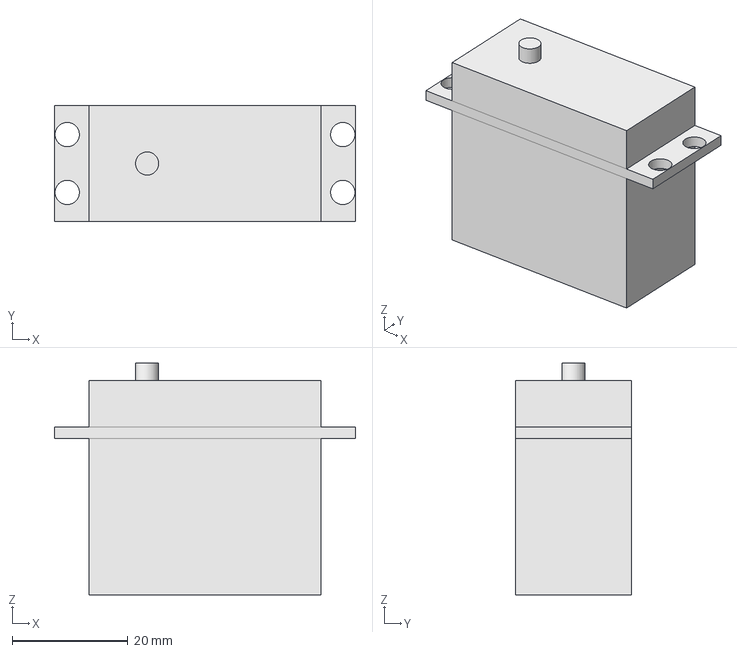
[picture p103: CAD file, 2016-08-01]
masterThesisWork/3DCadModels/Servo.fcstd
52.0 x 20.0 x 40.0 mm
