KarolKaim/-masterThesis/masterThesisWork/webPagesSavedAsPDFs/portal_bikeworld_pl_artykul_testy_i_nowosci_nowosci_sprzetow.pdf

open in browser (http://pdfcrowd.com/redirect/?id=ma-160619080114-c869eb55) PRO version (http://pdfcrowd.com/customize/) Are you a developer? Try out the HTML to PDF API (http://pdfcrowd.com/html-to-pdf-api/?ref=pdf) | pdfcrowd.com
PORTAL | Czego szukasz?
TESTY I NOWOŚCI | SPORT | MULTIMEDIA | LUDZIE | PORADY | TURYSTYKA | TEMATYKA
Bikeworld.pl (http://portal.bikeworld.pl/) | Testy i nowości (http://portal.bikeworld.pl/dzial/testy_i_nowosci) | Nowości sprzętowe (http://portal.bikeworld.pl/dzial/testy_i_nowosci/nowosci_sprzetowe)

# SRAM RED ETAP

MARCEL NIEZGODA , 27-08-2015 | OCEŃ ARTYKUŁ (http://portal.bikeworld.pl/artykul/drukuj/14547/sram_red_etap)

AKCJE

Testy i nowości

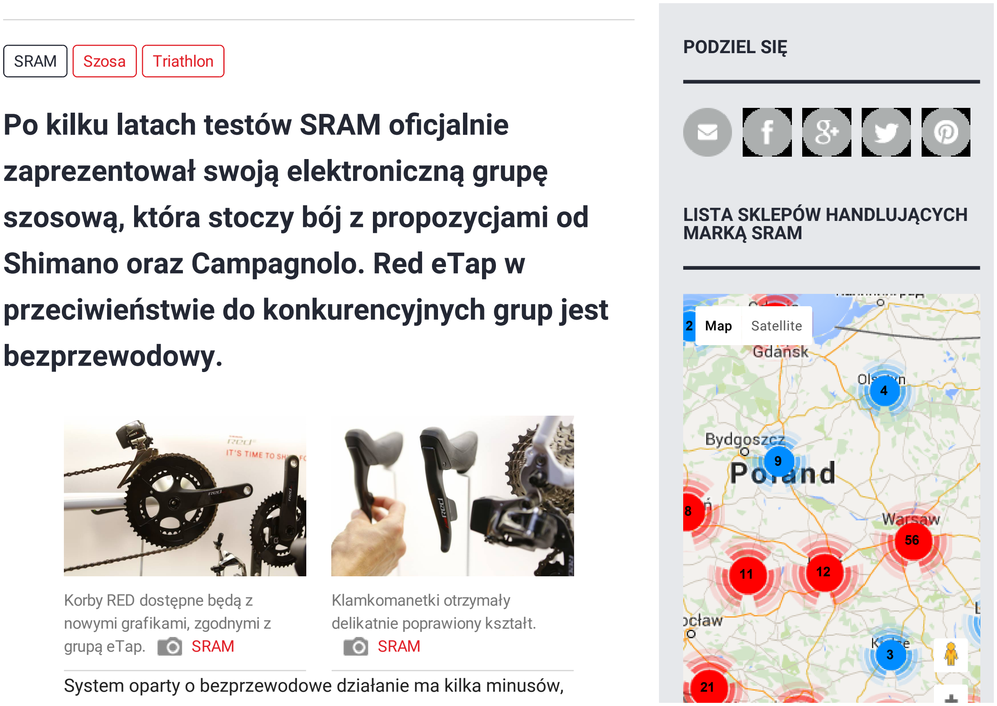
[picture p104: figure]
SRAM; Szosa; Triathlon; Po kilku latach testów SRAM oÂcjalnie zaprezentował swoją elektroniczną grupę; Shimano oraz Campagnolo. Red eTap w; bezprzewodowy.; Korby RED dostępne będą z nowymi grafikami, zgodnymi z; grupą eTap.; Klamkomanetki otrzymały delikatnie poprawiony kształt. SRAM; PODZIEL SIĘ; LISTA SKLEPÓW HANDLUJĄCYCH MARKĄ SRAM; 2 Map; Satellite

## szosową, która stoczy bój z propozycjami od

## przeciwieństwie do konkurencyjnych grup jest

System oparty o bezprzewodowe działanie ma kilka minusów,

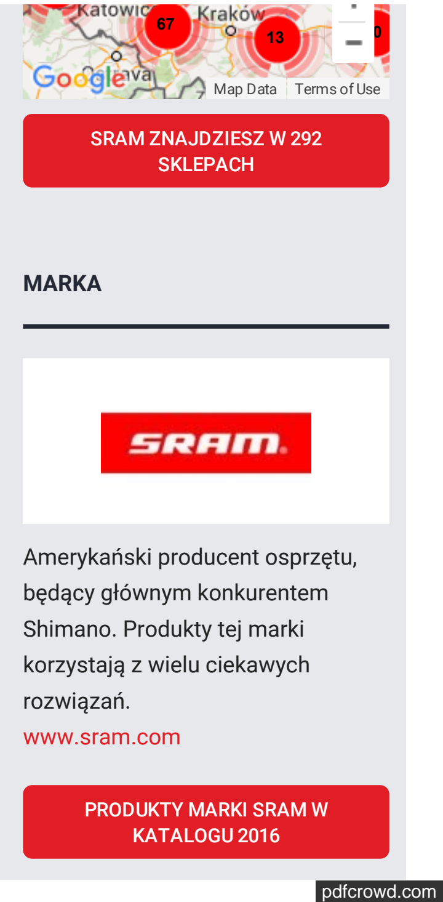
[picture p105: figure]
Map Data; Terms of Use; SRAM ZNAJDZIESZ W 292 SKLEPACH; MARKA; Amerykański producent osprzętu, będący głównym konkurentem Shimano. Produkty tej marki korzystają z wielu ciekawych rozwiązań. www.sram.com; PRODUKTY MARKI SRAM W KATALOGU 2016

ale plusy tego rozwiązania zdaniem inżynierów SRAMa przemawiają na jego korzyść. Po pierwsze większość awarii występuje w miejscu łączenia poszczególnych elementów systemu, a po drugie znacznie lepiej wygląda kompatybilność grupy z ramami oraz instalacja nowej grupy. Wadą bezprzewodowego systemu jest konieczność osobnego zasilenia każdego z elementów, ale SRAM ten problem w znacznej mierze zminimalizował. Doprowadzenie całego systemu eTap do obecnej, produkcyjnej formy zajęło amerykańskiej Ârmie blisko 4 lata, milion przejechanych testowych kilometrów, a przy okazji powstało blisko 450 patentów. Jednym z nich jest nowy system transmisji danych AIREA - nie jest to ANT+, WiFi, czy też Bluetooth. Opiera się on o częstotliwość 2,4 GHz i posiada 128-bitowe zabezpieczenie, które opracowane zostało przez kryptografów - próby zablokowania systemu np. podczas ważnych wyścigów WorldTour nie będą więc istniały. eTap przeznaczony jest dla napędów 11-rzędowych i nie będzie on kompatybilny z 10-rzędowymi napędami.

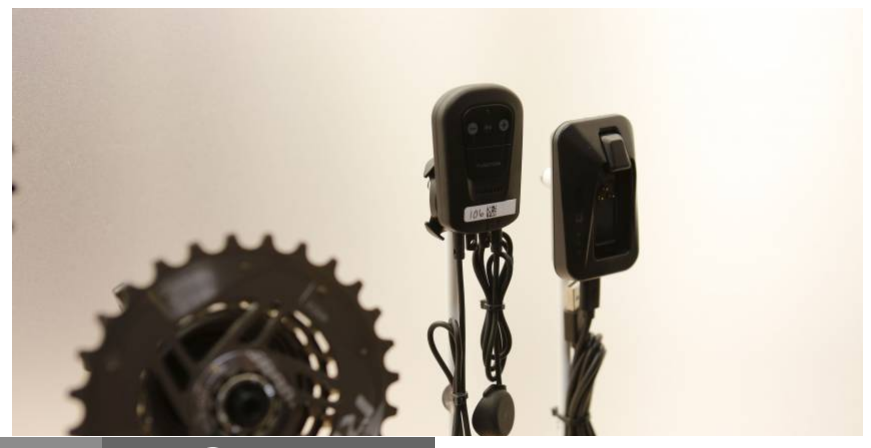
[picture p106: figure]
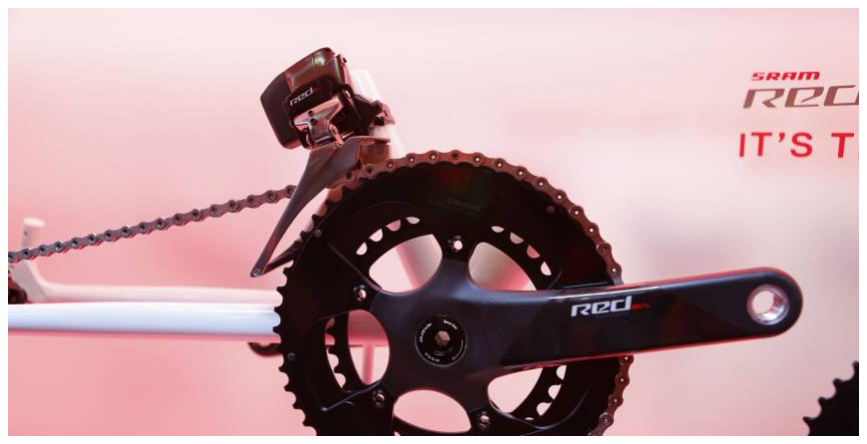
[picture p107: figure]

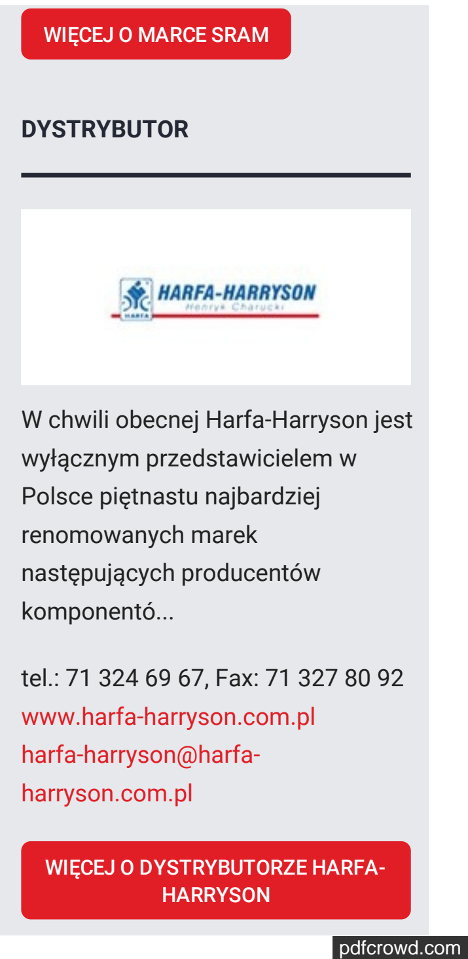
[picture p108: figure]
WIĘCEJ O MARCE SRAM; DYSTRYBUTOR; W chwili obecnej Harfa-Harryson jest wyłącznym przedstawicielem w Polsce piętnastu najbardziej renomowanych marek następujących producentów komponentó...; tel.: 71 324 69 67, Fax: 71 327 80 92 www.harfa-harryson.com.pl harfa-harryson@harfa- harryson.com.pl; WIĘCEJ O DYSTRYBUTORZE HARFA- HARRYSON

Red eTap składa się z trzech elementów - klamkomanetek (występujących także w wersji triathlonowej), przerzutki tylnej oraz przedniej. Manetki zasilane są za pomocą zwykłych baterii CR2032 (jedna sztuka w każdej z nich), jednak zdaniem SRAMa wystarczą one na około 2 lata użytkowania, z tego względu, że pobór prądu przez klamkomanetki jest niewielki i polega jedynie na wysłaniu sygnału do przerzutek. Zmiana przełożeń odbywa się w następujący sposób: na każdej z manetek zainstalowany jest jeden przycisk - naciśnięcie przycisku na prawej manetce zrzuca przełożenie na kasecie o oczko niżej, przycisku na lewej o jedno przełożenie wyżej, zaś naciśnięcie obu przycisków na raz zmienia przełożenie na korbie pomiędzy jedną z dwóch zębatek. Przerzutki zasilane są akumulatorami litowo-jonowymi, które wystarczą na około 1000 km działania. Naciśnięcie przycisku na jednej z manetek na ponad 15 sekund sprawia, że osprzęt przechodzi w stan uśpienia, co pozwala uniknąć sytuacji, w której niefortunne oparcie roweru o jakiś element sprawi, że rozładujemy baterię poprzez ciągłe działanie systemu. W każdym z elektronicznych komponentów zastosowano diodę LED wskazującą stopień zużycia baterii.

Baterie systemu. | SRAM | Korby RED. | SRAM

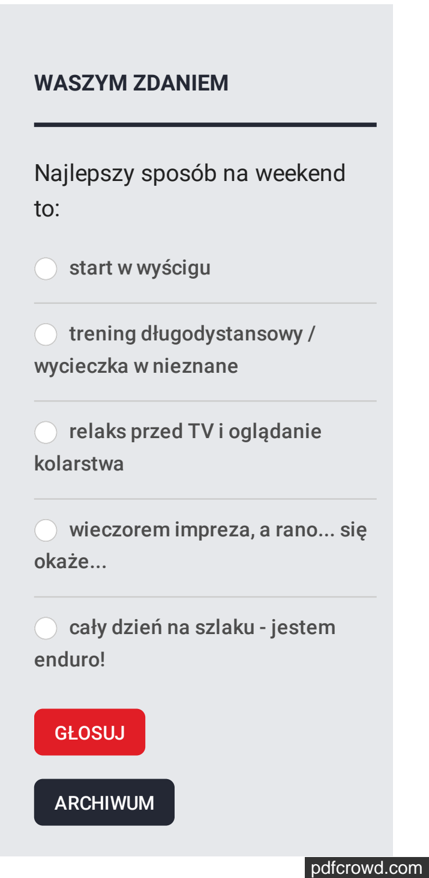
[picture p109: figure]
start w wyścigu; trening długodystansowy / wycieczka w nieznane; relaks przed TV i oglądanie kolarstwa; wieczorem impreza, a rano... się okaże...; cały dzień na szlaku - jestem enduro!; WASZYM ZDANIEM; Najlepszy sposób na weekend to:; GŁOSUJ; ARCHIWUM
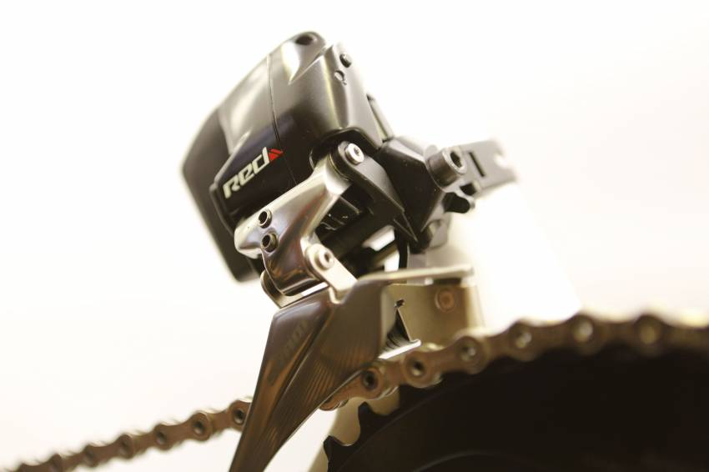
[picture p110: figure]
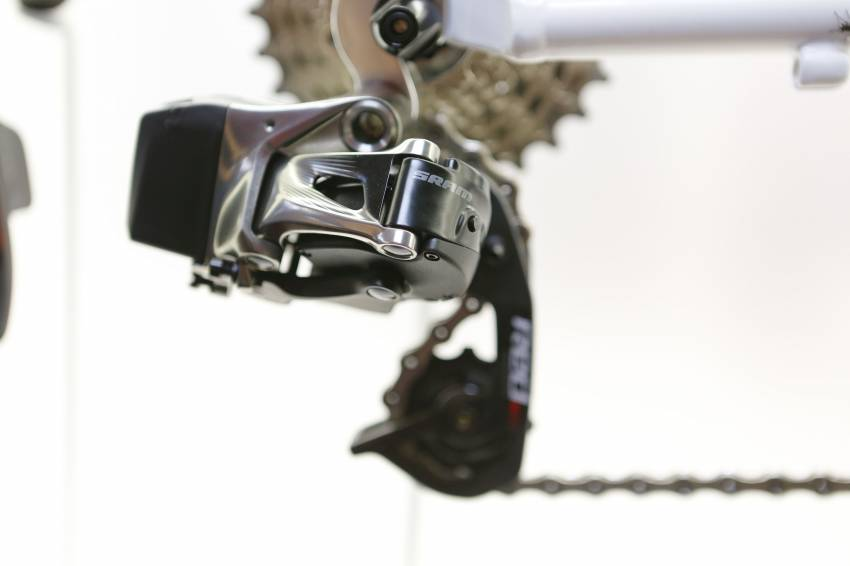
[picture p111: figure]

Przerzutka przednia waży 187 g, tylna 239 g i wartości te zawierają masę akumulatorów. Para klamkomanetek waży 260
g. Wartości te mogą wydawać się wysokie, ale uwzględniając brak stalowych linek oraz pancerzy, kompletna grupa Red w wersji elektronicznej będzie mniej więcej kilkadziesiąt gram cięższa od swojego mechanicznego odpowiednika. W przedniej przerzutce nie zabrakło systemu YAW, tylna natomiast ma maksymalną pojemność 28T. Przy okazji SRAM zmodyÂkował nieznacznie kształt dźwigni hamulca, które mają mieć teraz szerszy proÂl, pasujący większe liczbie użytkowników. Korpus będzie nieznacznie mniejszy, z nieznacznie łagodniejszymi krawędziami, co w połączeniu z ulepszoną gumą zapewnić ma wygodniejszy chwyt.

Przerzutka przednia otrzymała technologię YAW. SRAM

Przerzutka tylna eTap z
akumulatorem. SRAM

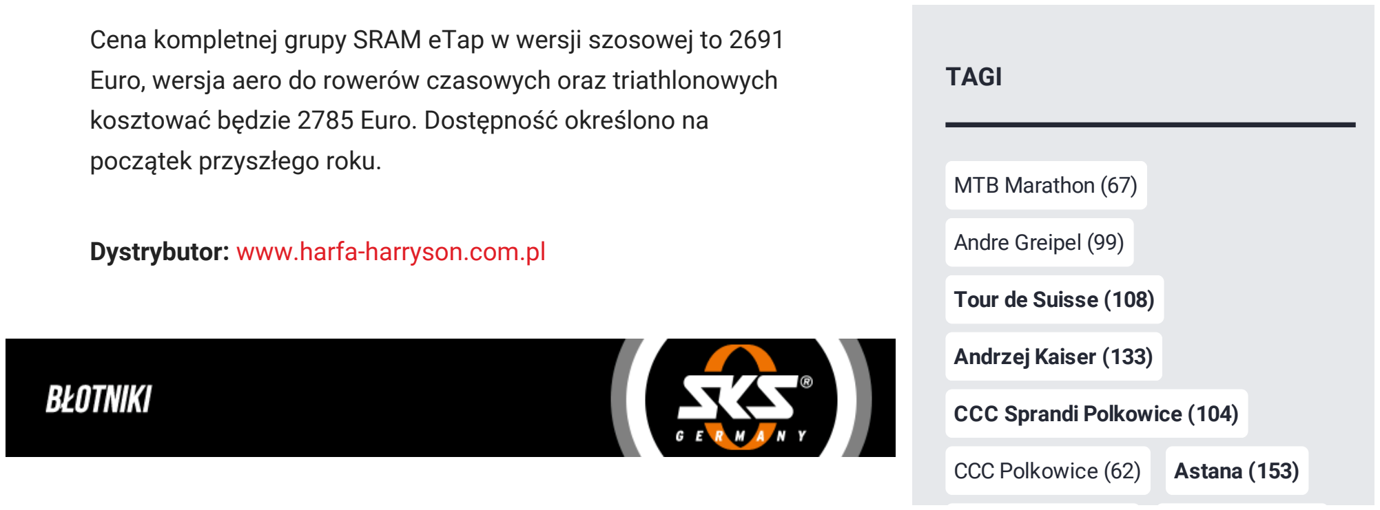
[picture p112: figure]
początek przyszłego roku.; Dystrybutor: www.harfa-harryson.com.pl; TAGI; MTB Marathon (67); Andre Greipel (99); Tour de Suisse (108); Andrzej Kaiser (133); CCC Sprandi Polkowice (104); CCC Polkowice (62); Astana (153)

Cena kompletnej grupy SRAM eTap w wersji szosowej to 2691 Euro, wersja aero do rowerów czasowych oraz triathlonowych kosztować będzie 2785 Euro. Dostępność określono na

### 0 Comments Bikeworld.pl (https://disqus.com/home/forums/bikeworldpl/)

⤤Share (http://disqus.com/embed/comments/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) Poleć (http://disqus.com/embed/comments/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)

Start the discussion… | Criterium du Dauphine (61) (http://portal.bikeworld.pl/tag/21213/criterium_du_dauphine)

Be the first to comment.

✉ Subscribe (http://disqus.com/embed/comments/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) | d Dodaj Disqus do swojej strony (https://publishers.disqus.com/engage?utm_source=bikeworldpl&utm_medium=Disqus-Footer) | Prywatność (https://help.disqus.com/customer/portal/articles/1657951)
Tom Boonen (123) (http://portal.bikeworld.pl/tag/1052/tom_boonen) | Poland Bike (63) (http://portal.bikeworld.pl/tag/9237/poland_bike)
Cape Epic (82) (http://portal.bikeworld.pl/tag/1198/cape_epic) | Dieta (65) (http://portal.bikeworld.pl/tag/639/dieta)

Piotr Brzózka (79) (http://portal.bikeworld.pl/tag/207/piotr_brzozka)

Andy Schleck (71) (http://portal.bikeworld.pl/tag/2698/andy_schleck)

Vincenzo Nibali (171) (http://portal.bikeworld.pl/tag/4492/vincenzo_nibali) Mazovia (148) (http://portal.bikeworld.pl/tag/153/mazovia)

Przemysław Niemiec (127) (http://portal.bikeworld.pl/tag/2540/przemyslaw_niemiec)

Puchar Świata (299) (http://portal.bikeworld.pl/tag/1143/puchar_swiata)

Kross Racing Team (109) (http://portal.bikeworld.pl/tag/338/kross_racing_team)

Michał Gołaś (72) (http://portal.bikeworld.pl/tag/2627/michal_golas)

# PODOBNE ARTYKUŁY

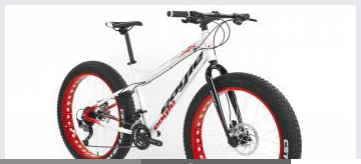
[picture p113: figure]
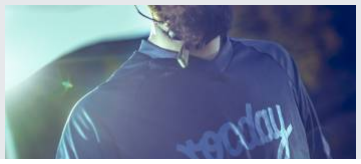
[picture p114: figure]
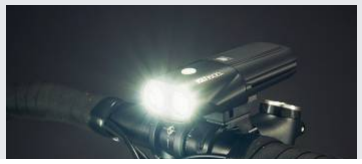
[picture p115: figure]
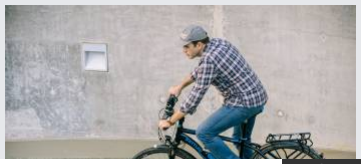
[picture p116: figure]

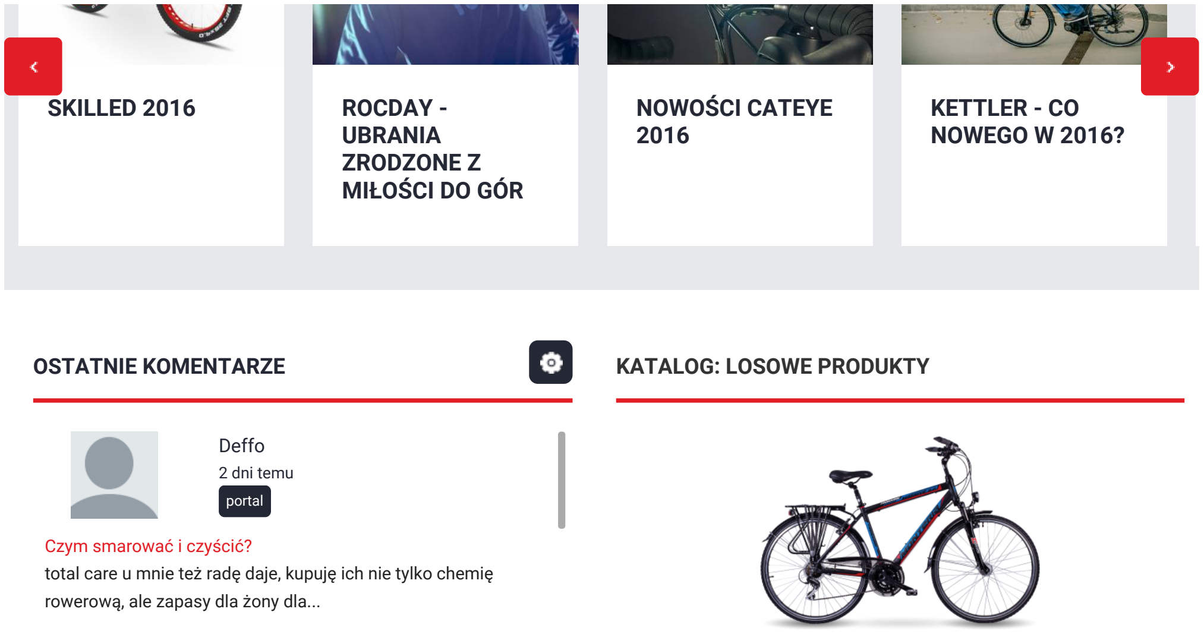
[picture p117: figure]
OSTATNIE KOMENTARZE; Deffo; 2 dni temu; portal; Czym smarować i czyścić?; rowerową, ale zapasy dla żony dla...; KATALOG: LOSOWE PRODUKTY; SKILLED 2016; ROCDAY -; UBRANIA ZRODZONE Z MIŁOŚCI DO GÓR; NOWOŚCI CATEYE 2016; KETTLER - CO NOWEGO W 2016?

total care u mnie też radę daje, kupuję ich nie tylko chemię

Grzegorz Szydłowski (https://disqus.com/by/grzegorzszydowski/)
6 dni temu
portal

Romet Rambler 29 R-Line 6.0 - test Strona 1 z 4 (http://portal.aikon-media.nazwa.pl/artykul/testy_i_nowosci/testy_rowerow/11594/focus_izalco_max_test_lekko_sci) Dobry rower .

MONTERIA MASSIVE 2.0
1649.00 ZŁ (http://katalog.bikeworld.pl/2016/web/produkt/rowery/trekking_cross/monteria/45739/massive_2_0)
Rowery | Monteria BMX 16 Boy 549.00 ZŁ (http://katalog.bikeworld.pl/2016/web/produkt/rowery/dzieciece/monteria/45754/bmx_16_boy)
Rowery | Monteria BMX 16 Girl 549.00 ZŁ (http://katalog.bikeworld.pl/2016/web/produkt/rowery/dzieciece/monteria/45759/bmx_16_girl)

Ryszard (https://disqus.com/by/disqus_NI1kY5UEJi/)
7 dni temu
portal

Rowery szosowe - szybko, szybciej Strona 1 z 2 (http://portal.bikeworld.pl/artykul/porady/abc_rowerzysty/2755/rowery_szosowe_szybko_szybciej)
Mylisz liczbę zębów na zębatce z liczbą zębatek w kasecie.Ja mam kompakt z przodu 50/34, z t...
Rowery | Monteria BMX 18 Girl 599.00 ZŁ (http://katalog.bikeworld.pl/2016/web/produkt/rowery/dzieciece/monteria/45760/bmx_18_girl)
Akcesoria | Thule Legend GoPro 899.00 ZŁ (http://katalog.bikeworld.pl/2016/web/produkt/akcesoria/plecaki_i_buklaki/thule/48911/legend_gopro)
Akcesoria | Thule Chariot CX 1 4799.00 ZŁ (http://katalog.bikeworld.pl/2016/web/produkt/akcesoria/inne_2/thule/41863/thule_chariot_cx_1)
Rowery | B'TWIN ULTRA 720 5299.00 ZŁ (http://katalog.bikeworld.pl/2016/web/produkt/rowery/szosowe/b_twin/49028/ultra_720)

KALENDARZ: NAJBLIŻSZE IMPREZY (http://kalendarz.bikeworld.pl/)

2016-06-19 | DSR Road Maraton (http://kalendarz.bikeworld.pl/impreza/szosa/sieroszewice/2573/dsr_road_maraton) | Sieroszewice (http://kalendarz.bikeworld.pl/imprezy/wszystkie/Sieroszewice)
2016-06-19 | Dare 2b MTB Maraton (http://kalendarz.bikeworld.pl/impreza/maratony/skrzyszow/2609/dare_2b_mtb_maraton) | Skrzyszów (http://kalendarz.bikeworld.pl/imprezy/wszystkie/Skrzysz%C3%B3w)
2016-06-19 | Górale na Start (http://kalendarz.bikeworld.pl/impreza/xc/walbrzych/2689/gorale_na_start) | Wałbrzych (http://kalendarz.bikeworld.pl/imprezy/wszystkie/Wa%C5%82brzych)
2016-06-19 | Memoriał Grundmana i Wizowskiego (UCI 1.2) (http://kalendarz.bikeworld.pl/impreza/szosa/glogow/2704/memorial_grundmana_i_wizowskiego_uci_1_2) | Głogów (http://kalendarz.bikeworld.pl/imprezy/wszystkie/G%C5%82og%C3%B3w)
2016-06-19 | Bike Cross Maraton (http://kalendarz.bikeworld.pl/impreza/maratony/mosina/2470/bike_cross_maraton) | Mosina (http://kalendarz.bikeworld.pl/imprezy/wszystkie/Mosina)
2016-06-19 | Puchar Tarnowa (http://kalendarz.bikeworld.pl/impreza/maratony/tarnow/2501/puchar_tarnowa) | Tarnów (http://kalendarz.bikeworld.pl/imprezy/wszystkie/Tarn%C3%B3w)
2016-06-19 | Poland Bike (http://kalendarz.bikeworld.pl/impreza/maratony/gora_kalwaria/2526/poland_bike) | Góra Kalwaria (http://kalendarz.bikeworld.pl/imprezy/wszystkie/G%C3%B3ra%20Kalwaria)
2016-06-25 | Cyklokarpaty (http://kalendarz.bikeworld.pl/impreza/maratony/zakopane/2324/cyklokarpaty) | Zakopane (http://kalendarz.bikeworld.pl/imprezy/wszystkie/Zakopane)
2016-06-25 | Mistrzostwa Polski w Trialu rowerowym (http://kalendarz.bikeworld.pl/impreza/inne/do_ustalenia/2642/mistrzostwa_polski_w_trialu_rowerowym) | (do ustalenia) (http://kalendarz.bikeworld.pl/imprezy/wszystkie/%28do%20ustalenia%29)

SKLEPY: LOSOWE SKLEPY (http://sklepy.bikeworld.pl/)

Zielona Góra (http://sklepy.bikeworld.pl/sklepy/wszystkie/wszystkie/Zielona%20G%C3%B3ra) | Fan Sport, ul. Zacisze 20 (http://sklepy.bikeworld.pl/sklep/ogolnosportowy/zielona_gora/264/fan_sport_2)
Cieszyn (http://sklepy.bikeworld.pl/sklepy/wszystkie/wszystkie/Cieszyn) | Sklep Rowerowy, ul. Katowicka 103 (http://sklepy.bikeworld.pl/sklep/rowerowy/cieszyn/285/gabi_pol)
Łódź (http://sklepy.bikeworld.pl/sklepy/wszystkie/wszystkie/%C5%81%C3%B3d%C5%BA) | Gold Sport, ul. Kopernika 33 (http://sklepy.bikeworld.pl/sklep/rowerowy/lodz/293/gold_sport)
Dzierżoniów (http://sklepy.bikeworld.pl/sklepy/wszystkie/wszystkie/Dzier%C5%BConi%C3%B3w) | K2, ul. Świdnicka 18 (http://sklepy.bikeworld.pl/sklep/rowerowy/dzierzoniow/371/k2)
Staszów (http://sklepy.bikeworld.pl/sklepy/wszystkie/wszystkie/Stasz%C3%B3w) | Laser, ul. Polna 23 (http://sklepy.bikeworld.pl/sklep/rowerowy/staszow/407/laser)
Toruń (http://sklepy.bikeworld.pl/sklepy/wszystkie/wszystkie/Toru%C5%84) | Lider Sport, ul. Kosynierów Kościuszkowskich 4 (http://sklepy.bikeworld.pl/sklep/rowerowy/torun/417/lider_sport)
Chorzów (http://sklepy.bikeworld.pl/sklepy/wszystkie/wszystkie/Chorz%C3%B3w) | Orange Bike, ul. Sobieskiego 24 (http://sklepy.bikeworld.pl/sklep/rowerowy/chorzow/532/orange_bike_1)
Rzeszów (http://sklepy.bikeworld.pl/sklepy/wszystkie/wszystkie/Rzesz%C3%B3w) | Axel Sport, ul. Krakowska 339 (http://sklepy.bikeworld.pl/sklep/ogolnosportowy/rzeszow/951/axel_sport)
Chojna (http://sklepy.bikeworld.pl/sklepy/wszystkie/wszystkie/Chojna) | Coolbike, ul. Jagiellońska 15 (http://sklepy.bikeworld.pl/sklep/rowerowy/chojna/1251/mega_sport)

2016-06-25 | Mistrzostwa Świata w Maratonie MTB (http://kalendarz.bikeworld.pl/impreza/maratony/laissac_francja/2667/mistrzostwa_swiata_w_maratonie_mtb) | Laissac, Francja (http://kalendarz.bikeworld.pl/imprezy/wszystkie/Laissac,%20Francja)
2016-06-25 | Rajd Bike Orient (http://kalendarz.bikeworld.pl/impreza/inne/taraska_k_sulejowa/2490/rajd_bike_orient) | Taraska k. Sulejowa (http://kalendarz.bikeworld.pl/imprezy/wszystkie/Taraska%20k.%20Sulejowa)
Legnica (http://sklepy.bikeworld.pl/sklepy/wszystkie/wszystkie/Legnica) | Pingwin Romet, ul. Jaworzyńska 119 (http://sklepy.bikeworld.pl/sklep/rowerowy/legnica/2010/pingwin_romet)
Biała Podlaska (http://sklepy.bikeworld.pl/sklepy/wszystkie/wszystkie/Bia%C5%82a%20Podlaska) | Bicykl Serwis, ul. Ogrodowa 3 (http://sklepy.bikeworld.pl/sklep/rowerowy/biala_podlaska/2013/bicykl_serwis)

### FIRMA

O FIRMIE (http://portal.bikeworld.pl/artykul/firma_1/o_firmie/3913/o_firmie)

REDAKCJA (http://portal.bikeworld.pl/artykul/firma_1/redakcja/3914/redakcja)

REKLAMA (http://portal.bikeworld.pl/artykul/firma_1/reklama/3916/reklama)

POLITYKA PRYWATNOŚCI (http://portal.bikeworld.pl/artykul/firma_1/polityka_prywatnosci/3918/polityka_prywatno_sci_bikeworld_pl)

KONTAKT (http://portal.bikeworld.pl/artykul/firma_1/kontakt/3919/kontakt)

### POLECAMY

TAPETY NA PULPIT (http://portal.bikeworld.pl/artykul/polecamy/tapety_na_pulpit/3911/tapety)

PRACUJ Z NAMI (http://portal.bikeworld.pl/artykul/polecamy/pracuj_z_nami/3917/praca_w_bikeworld_pl)

### NASZE SERWISY

PORTAL.BIKEWORLD.PL (http://portal.bikeworld.pl/rss)

KATALOG.BIKEWORLD.PL

SKLEPY.BIKEWORLD.PL

### DOŁĄCZ DO NAS

KALENDARZ.BIKEWORLD.PL

COPYRIGHTS © BIKEWORLD.PL (http://portal.bikeworld.pl/) 2014
WSZELKIE PRAWA ZASTRZEŻONE. KOPIOWANIE ORAZ ROZPOWSZECHNIANIE MATERIAŁÓW ZAWARTYCH NA NINIEJSZEJ STRONIE JEST ZABRONIONE. Nasza strona internetowa używa plików cookies (tzw. ciasteczka) w celach statystycznych, reklamowych oraz funkcjonalnych. Dzięki nim możemy indywidualnie dostosować stronę do twoich potrzeb. Każdy może zaakceptować pliki cookies albo ma możliwość wyłączenia ich w przeglądarce, dzięki czemu nie będą zbierane żadne informacje. AKCEPTUJĘ (http://portal.bikeworld.pl/artykul/testy_i_nowosci/nowosci_sprzetowe/14547/sram_red_etap)
