KarolKaim/-masterThesis/masterThesisWork/images/tests_randomChange.jpg

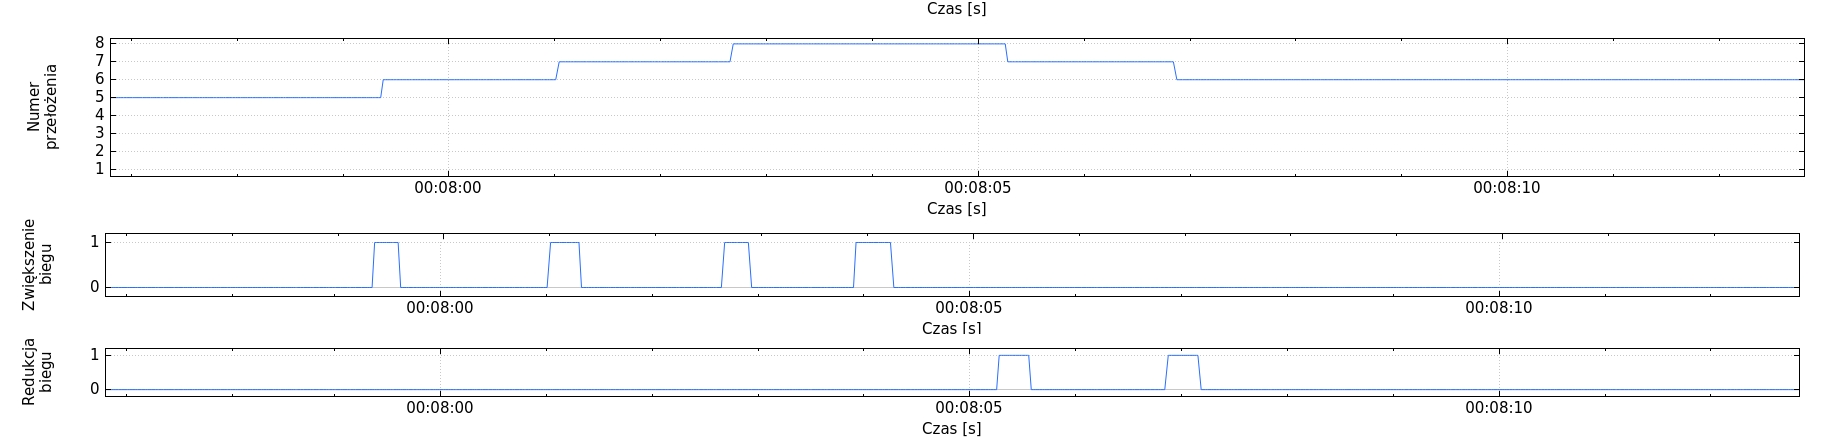
masterThesisWork/images/tests_randomChange.jpg
