KarolKaim/-masterThesis/masterThesisWork/images/tests_trybActiveSetSpeed.jpg

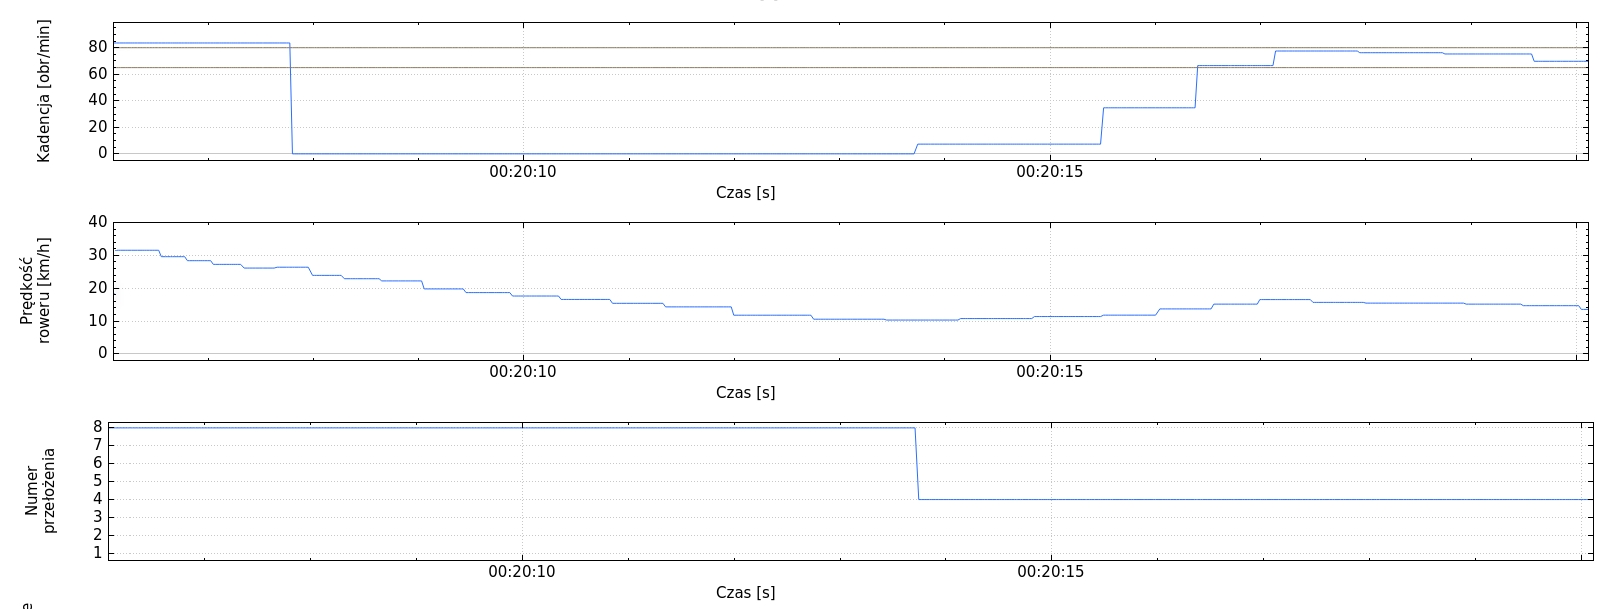
masterThesisWork/images/tests_trybActiveSetSpeed.jpg
