KarolKaim/-masterThesis/masterThesisWork/webPagesSavedAsPDFs/cycling_passion_com_2015_09_06_dura_ace_history.pdf

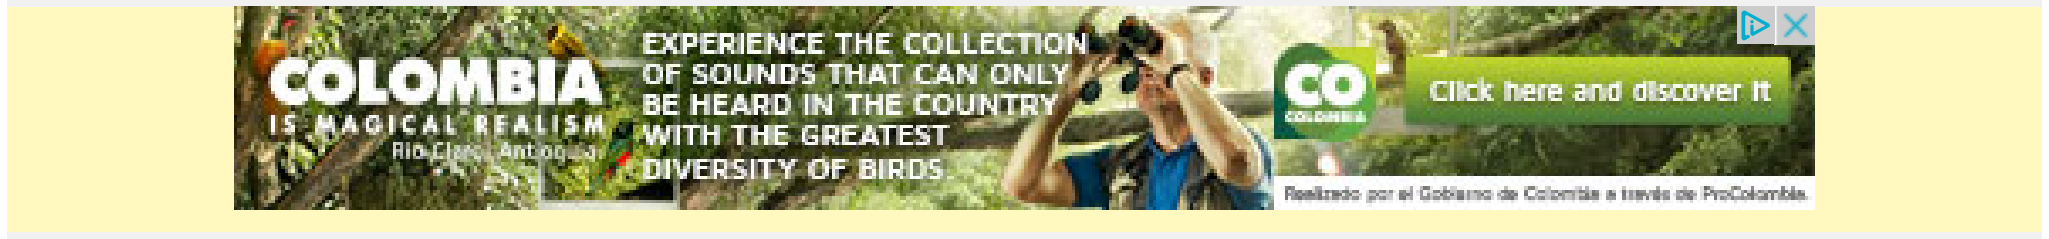
[picture p120: figure]
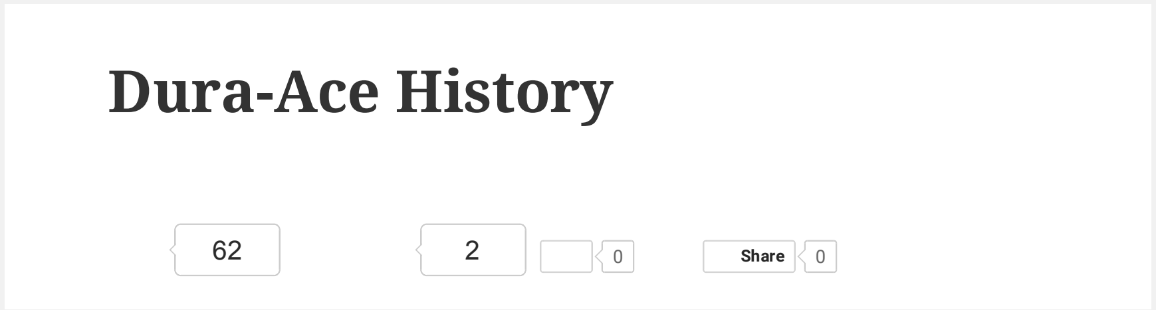
[picture p121: figure]
Dura-Ace History; Share

open in browser (http://pdfcrowd.com/redirect/?id=ma-160618142117-a17549a5) PRO version (http://pdfcrowd.com/customize/) Are you a developer? Try out the HTML to PDF API (http://pdfcrowd.com/html-to-pdf-api/?ref=pdf) | pdfcrowd.com

# Cycling Passion (http://cycling-passion.com/)

a passion, an emotion, a sport

Dura-Ace is the admiral ship of Shimano, the Japanese (now multinational) manufacturer of cycling components (and some other things like fishing tackle and rowing equipment). Here is a brief history of Dura-ace.

# 1973 – The first Dura-Ace release

The story begins in 1973, the same year which Campagnolo Super Record group was introduced. The first Dura-Ace was built using (http://cycling-passion.com/2013/03/25/super-record-40-year-old/) aluminum. It was Shimano’s first attempt at a professional quality road racing component group which dominated by Campagnolo, the Italian manufacturer who was unchallenged for years.

There were two types of rear derailleur (short-cage, up to 28-teeth compatible and the long-cage, up to 34-teeth compatible). The cranks were 39/52 165mm, 45/54 165mm, 39/52 170mm and 45/54 170mm.

The “pro” model had 5/6 speed options, while “touring” model was 5-speed.

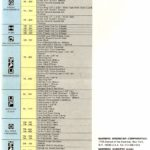
[picture p122: figure]

Shimano Dura-Ace 1973
Catalogue: Package
Contents Specifications.
Photo:
SheldonBrown.com (http://www.sheldonbrown.com/shimano1973/index.html)

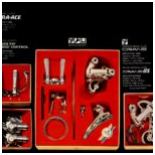
[picture p123: figure]

Shimano Dura-Ace 1973
Catalogue: Shifters and
Derailleurs. Photo:
SheldonBrown.com (http://www.sheldonbrown.com/shimano1973/index.html)

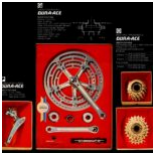
[picture p124: figure]

Shimano Dura-Ace 1973
Catalogue: Crankset,
Cassette and Front
Derailleur. Photo:
SheldonBrown.com (http://www.sheldonbrown.com/shimano1973/index.html)

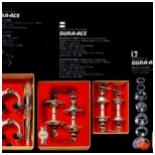
[picture p125: figure]

Shimano Dura-Ace 1973
Catalogue: Brakes, Hubs
and Head Parts. Photo:
SheldonBrown.com (http://www.sheldonbrown.com/shimano1973/index.html)

# 1976 – Dura-Ace 10

It was a track groupset used a 10mm pitch chain and gears.

Almost all bike chains are half-inch pitch, so the centers of the pins are half an inch, or 12.7mm, apart. Introduced in 1976, and discontinued some time in the 80s, Dura-Ace 10 used a smaller chain and therefore smaller chainrings and sprockets – the number of teeth was the same, but they were closer together.

The biggest advantage was lower weight, and eventually, according to legend, the Japanese Keirin federation banned the 10mm pitch equipment because it might give some riders an unfair advantage.

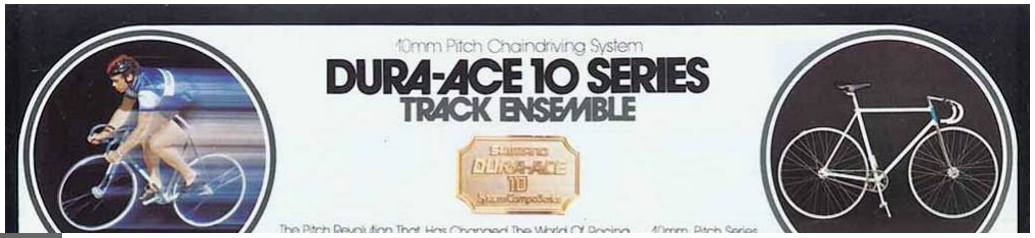
[picture p126: figure]

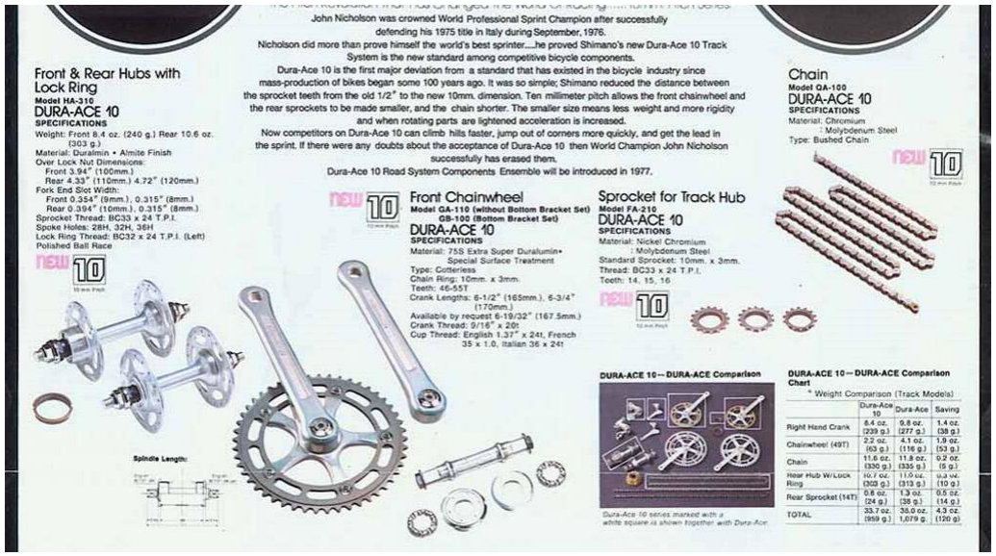
[picture p127: figure]

Shimano Dura-Ace 10 Series catalogue (1976).

# 1977 – Dura-Ace 7100

It was the second generation Dura-Ace. It was slightly different from the First Generation parts. Crank arms appear to be the same, but with different rings and used standard pedal threading.

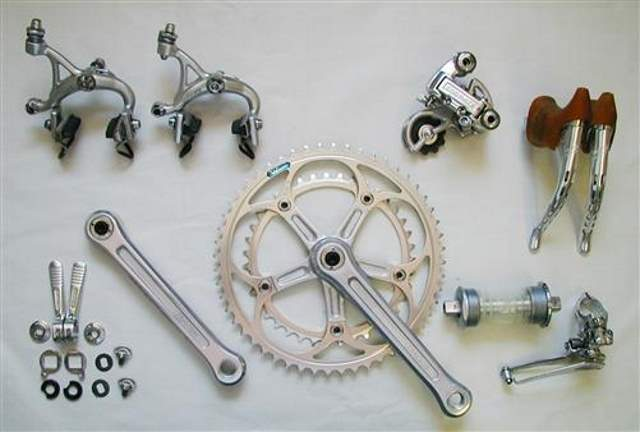
[picture p128: figure]

Shimano Dura-Ace 7100 group (1977)

# 1978 – Dura-Ace EX 7200

The Dura-Ace EX 7200 introduced Shimano’s EX concept as being a design optimized for the (then radical) idea of using 6-speed, particularly with the new freehubs.

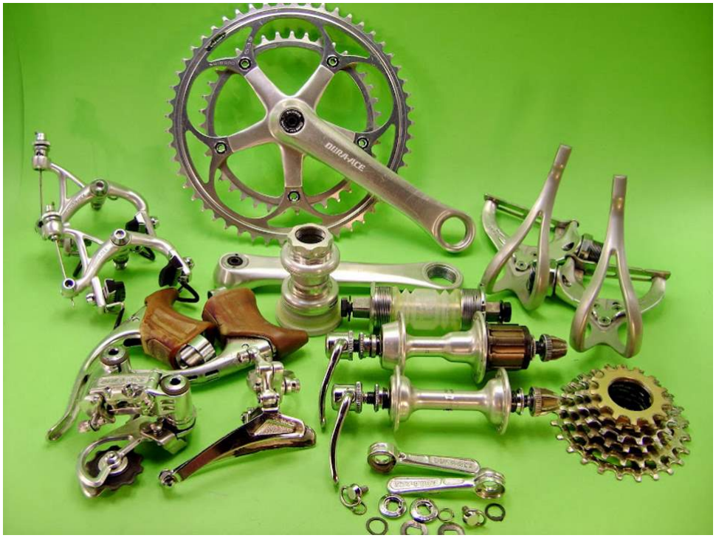
[picture p129: figure]

Shimano Dura-Ace EX 7200 group (1978)

# 1980 – Dura-Ace AX 7300

Shimano Dura-Ace AX 7300 comes out in 1980. It is specifically designed to be more aerodynamic.

Despite being a commercial disaster (Dura-Ace series were not really successful until the introduction of the indexed shifting, the “Shimano Index System – SIS” in 1984), the AX 7300 is arguably one of the foundation stones of Shimano’s current success. It created a fear of being left behind that forced every other derailleur manufacturer in the world to redesign their own derailleurs to incorporate “aerodynamic” elements. With the European manufacturers already on their knees, and SunTour about to be clobbered by technical problems, this expenditure crippled every one of Shimano’s competitors.

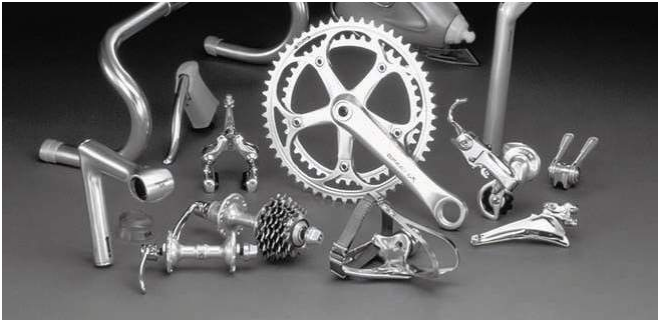
[picture p130: figure]

Shimano Dura-Ace AX 7300 group (1980).

# 1984 – Dura-Ace 7400 series with Shimano Index System (SIS)

In 1984, Shimano introduced Dura-Ace S.I.S. (Shimano Indexing System), the first successful indexed-shifting system in cycling history. It was a 6-speed (then 7 and 8-speed with the new versions) system with indexed shifters mounted on the down tube.

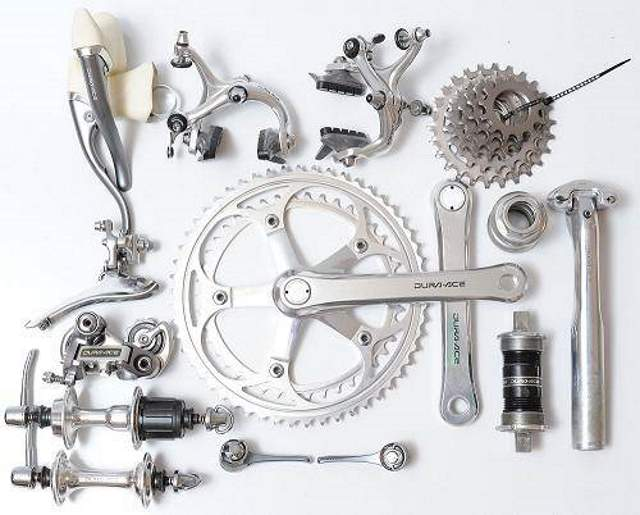
[picture p131: figure]

Shimano Dura-Ace 7400 Groupset (1984)

# 1988 – The first Grand Tour Victory: Giro d’Italia

In 1988, Andy Hampsten (Seven-Eleven Team) won the Giro d’Italia (http://cycling-passion.com/2013/08/19/hampsten-bikes/) with Dura-Ace groupset.

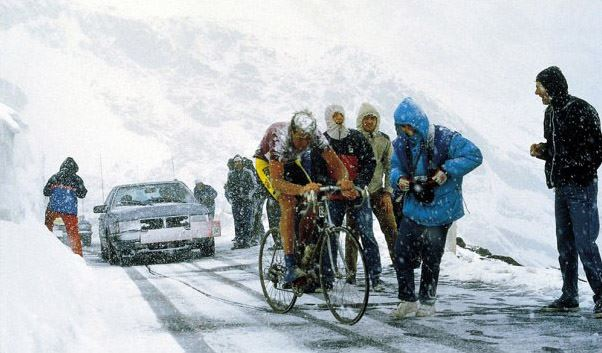
[picture p132: figure]

Andy Hampsten climbing Passo di Gavia, Giro d’Italia 1988.

# 1990 – Dura-Ace 7400 series with Dual Control Levers

The dual-control lever incorporates a shifter mechanism into the brake lever, making it possible to change speeds without removing one’s hands from handlebars.

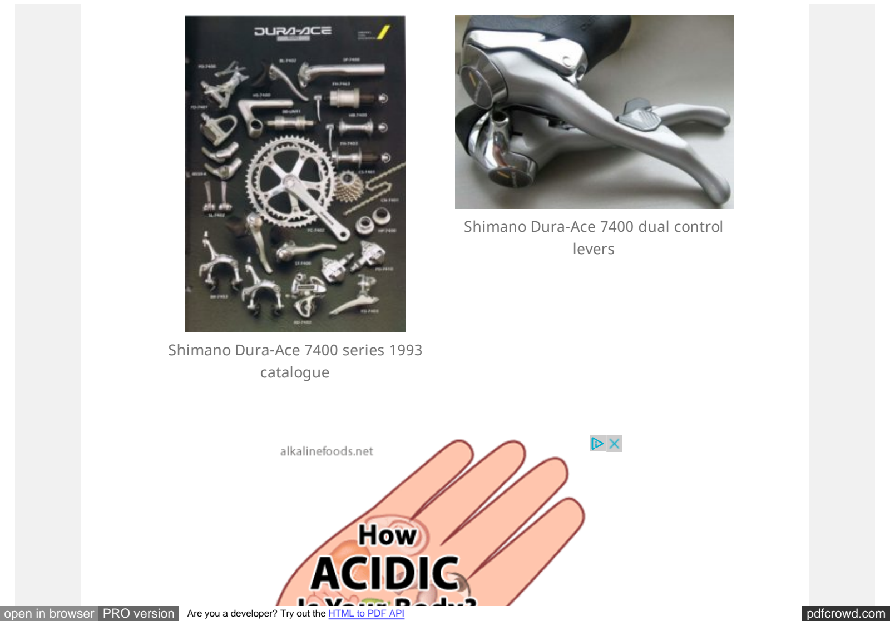
[picture p133: page 13]

Shimano Dura-Ace 7400 series 1993 catalogue

Shimano Dura-Ace 7400 dual control levers

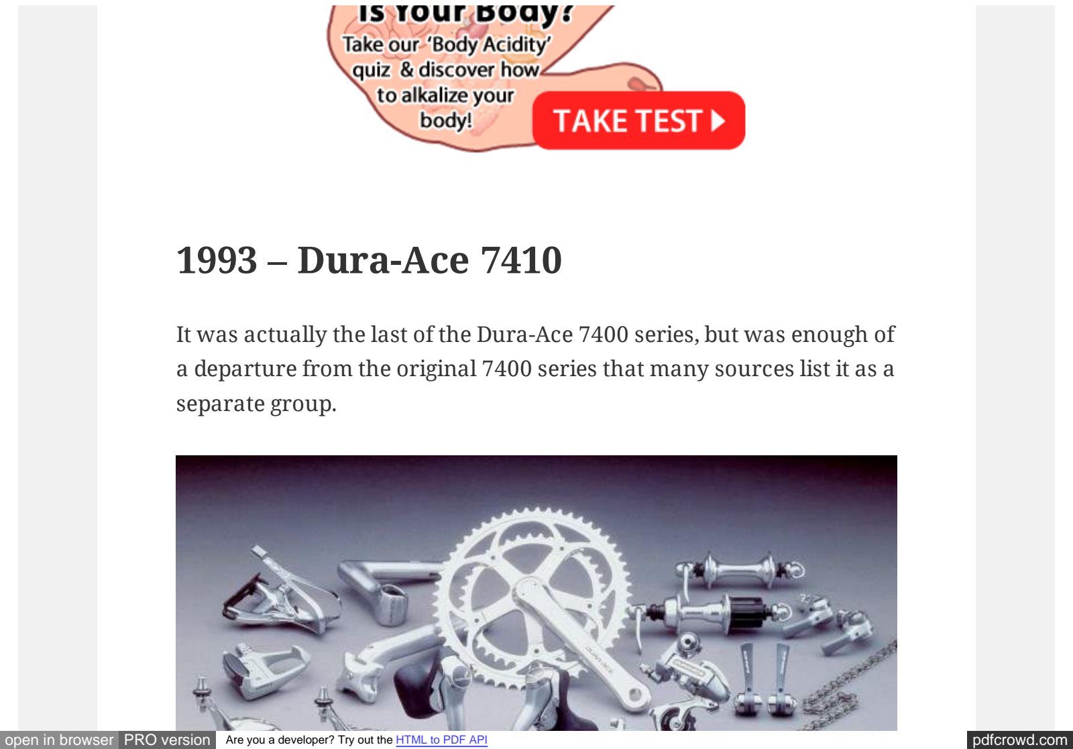
[picture p134: page 14]

# 1993 – Dura-Ace 7410

It was actually the last of the Dura-Ace 7400 series, but was enough of a departure from the original 7400 series that many sources list it as a separate group.

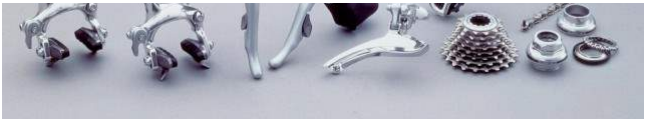
[picture p135: figure]

Shimano Dura-Ace-7000-7010 group

# 1996 – Dura-Ace 7700

7700 series are developed after thorough review of the previous derailleur system based on the philosophy of “Stress-Free”.

A review about DA 7700 that I like: “Reining from 1996 to 2004 as Shimano’s top-end groupset, it is arguable that DA 7700 lacks the technological punch to stand out on its own against breakthrough DA 7400 or ultra-refined DA 7800. It was just a sort of 9-speed filler between the two. But in 1999 it was this component group that allowed Shimano to finally climb to the top of the podium at the Tour de France. A cyclist from Texas, USA may have helped it get there.” (campagnolodelta.blogspot.com) (http://campagnolodelta.blogspot.com/2012/08/shimano-dura-ace-7700.html)

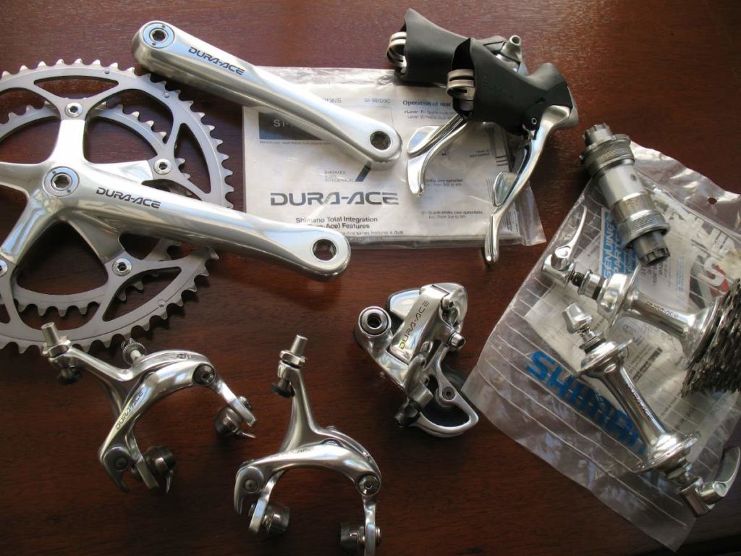
[picture p136: figure]

Shimano Dura-Ace 7700 group

# 1998 – Dura-Ace 25th Anniversary

# 1998 – Dura-Ace 25th Anniversary Groupset

This series is a special Dura-Ace released in commemoration of 25 year since its introduction in to the market.

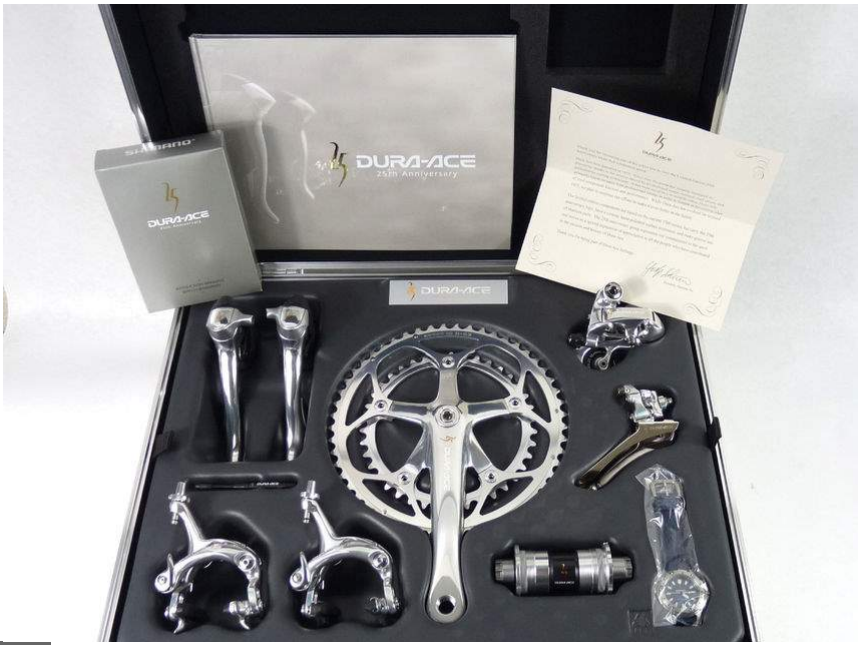
[picture p137: figure]

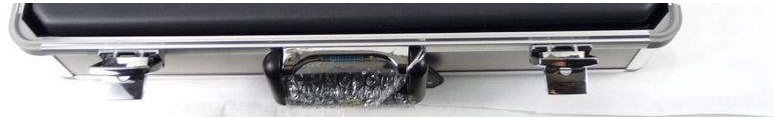
[picture p138: figure]

Shimano Dura-Ace 25th Anniversary Group (1998)

# 1999 – The first (now annulled) Tour de France victory

Lance Armstrong of the US Postal Team won the Tour de France 1999 using Dura-Ace 7700 groupset, but the U.S. Anti-Doping Agency (USADA) stripped his all seven Tour de France titles in 2012. (http://cycling-passion.com/2012/08/24/usada-officially-bans-lance-armstrong-lifetime-strips-7-tour-titles/)

# 2004 – Dura-Ace 7800

Dura-Ace 7800 series components are developed with “For 100% Power Transmission Efficiency” as a catchword. This series consisted of 10-speed rear drive trains, HOLLOWTECH cranksets, ergonomic dual control levers, and other higher performance components. It was the first 10-speed group of the market.

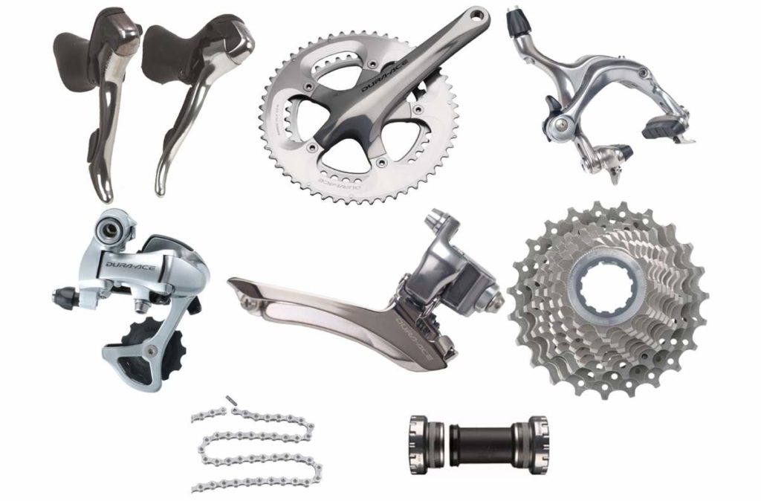
[picture p139: figure]

Shimano Dura-Ace 7800 groupset (10-speed)

# 2007 – The first (not annulled) Tour de

# 2007 – The first (not annulled) Tour de France victory

Alberto Contador, the Spanish rider of Discovery Channel team won the 2007 Tour de France using Dura-Ace 7800 groupset. Now Shimano has total of 6 Tour de France victories (as of 2015). (http://cycling-passion.com/2012/11/01/tour-de-france-winner-groupsets-year-year/)

# 2008 – Dura-Ace 7900

The 7900 series components were developed under the concept of “Evolution of Perfection”. A derailleur comprising these components embedded the shift cable completely. Its crankset consisted of a HOLLOWGRIDE (hollow gear) in addition to a HOLLOWTECH . All other components were also reviewed for optimal design. The weight of the groupset w/out hubs reduced from 2181 grams (DA 7800) to 2052 grams (DA 7900).

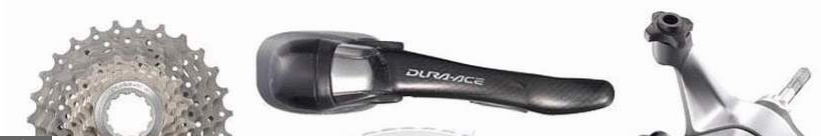
[picture p140: figure]

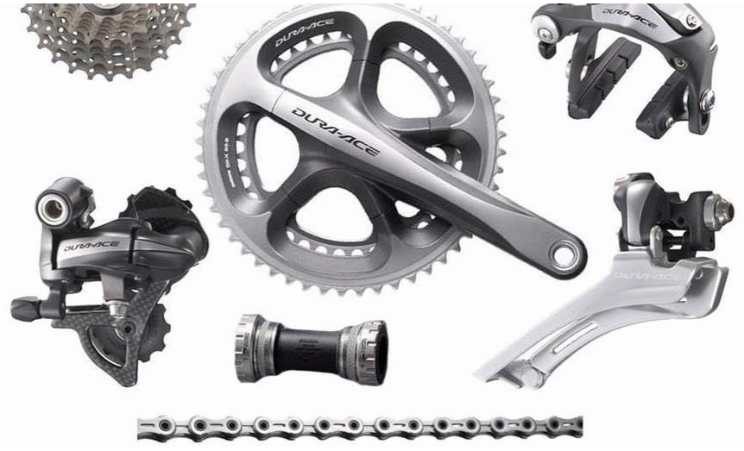
[picture p141: figure]

Shimano Dura-Ace 7900 groupset (2008)

# 2009 – Dura-Ace Di2 (electronic)

2009 Electronic Shifting System DURA-ACE 7970 is in the market.A new technology called “Digital Integrated Intelligence (or Di2 for short) was introduced into Dura-Ace. The Dura-Ace 7900 series equipped with this electronic shifting system provide racers with a “complete stress-free” function. Enhanced shifting performance is the most obvious benefit of Shimano’s Di2.

“A solution to a problem that doesn’t exist.” “Unnecessary.” “A marketing gimmick.” Those are lines offered against Shimano’s Dura-Ace Di2 electronic drivetrain, but it quickly became a racing standard. Today, almost every pro team use electronic gears.

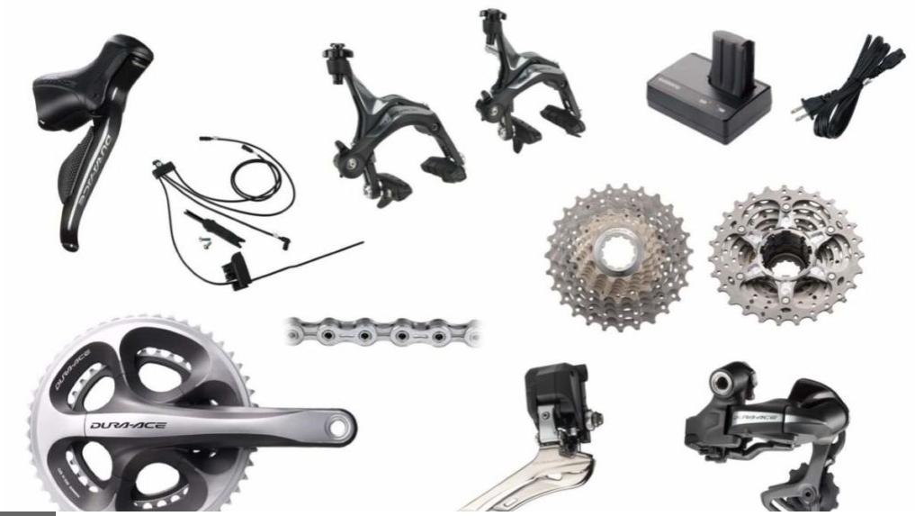
[picture p142: figure]

# 2012 – Dura-Ace 9000 (11-speed)

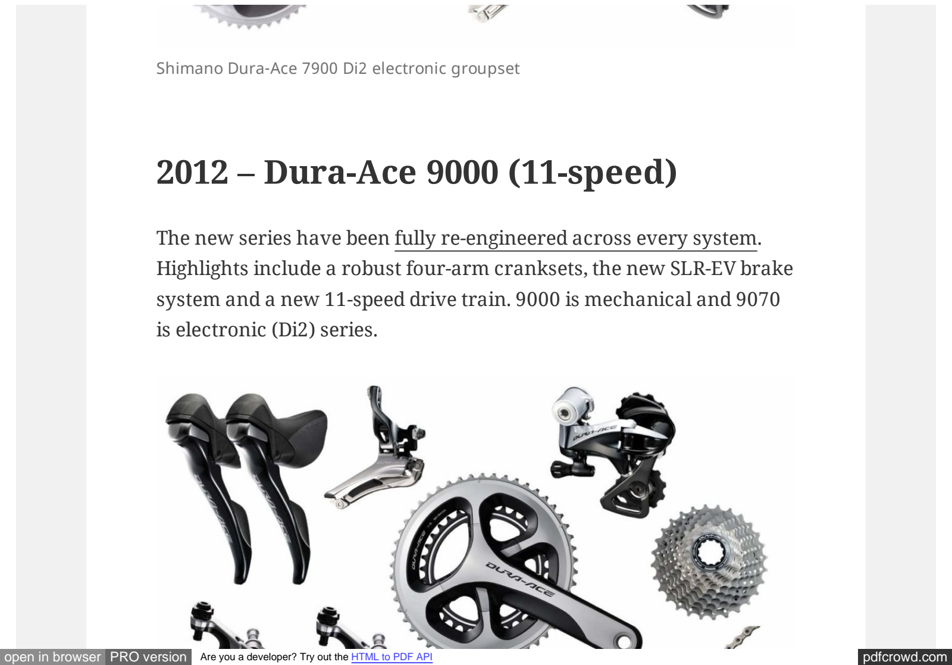
[picture p143: page 23]

Shimano Dura-Ace 7900 Di2 electronic groupset

The new series have been fully re-engineered across every system. (http://cycling-passion.com/2012/08/23/2013-dura-ace-11-speed/) Highlights include a robust four-arm cranksets, the new SLR-EV brake system and a new 11-speed drive train. 9000 is mechanical and 9070 is electronic (Di2) series.

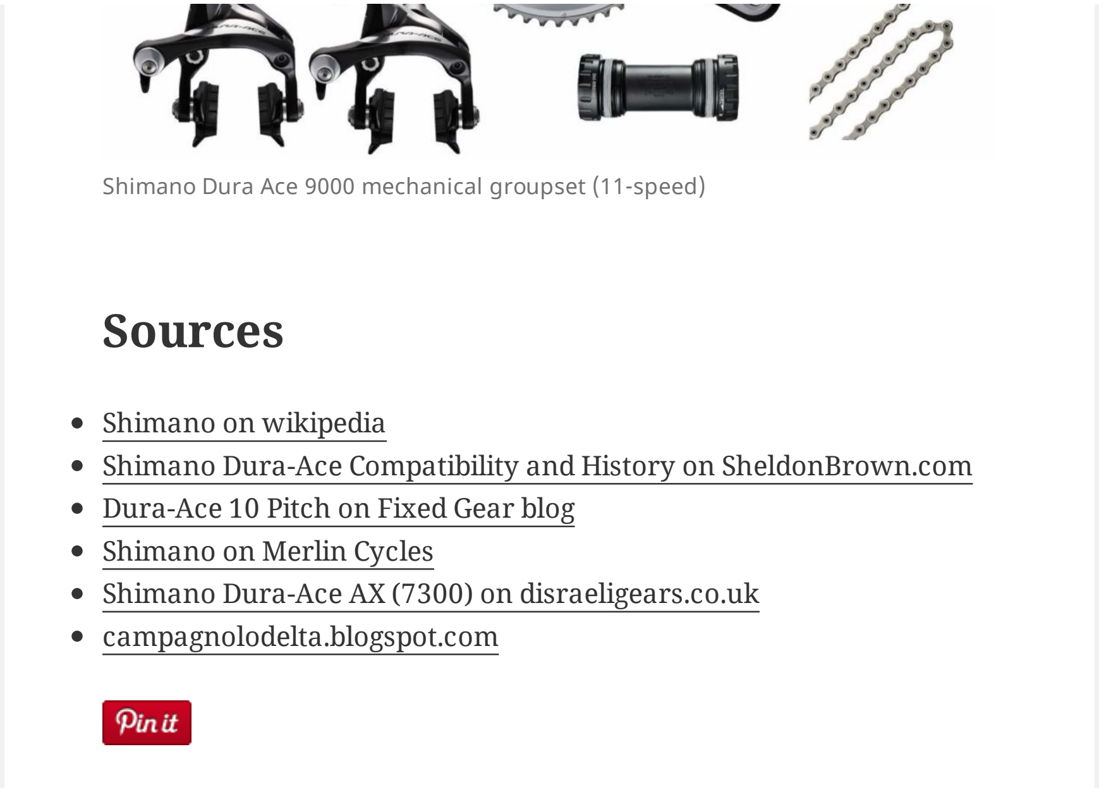
[picture p144: figure]
Sources; Shimano on wikipedia; Dura-Ace 10 Pitch on Fixed Gear blog Shimano on Merlin Cycles; campagnolodelta.blogspot.com

Shimano Dura Ace 9000 mechanical groupset (11-speed)

Shimano Dura-Ace Compatibility and History on SheldonBrown.com (http://www.sheldonbrown.com/dura-ace.html)

Shimano Dura-Ace AX (7300) on disraeligears.co.uk (http://www.disraeligears.co.uk/Site/Shimano_Dura-Ace_AX_derailleur_(7300).html)

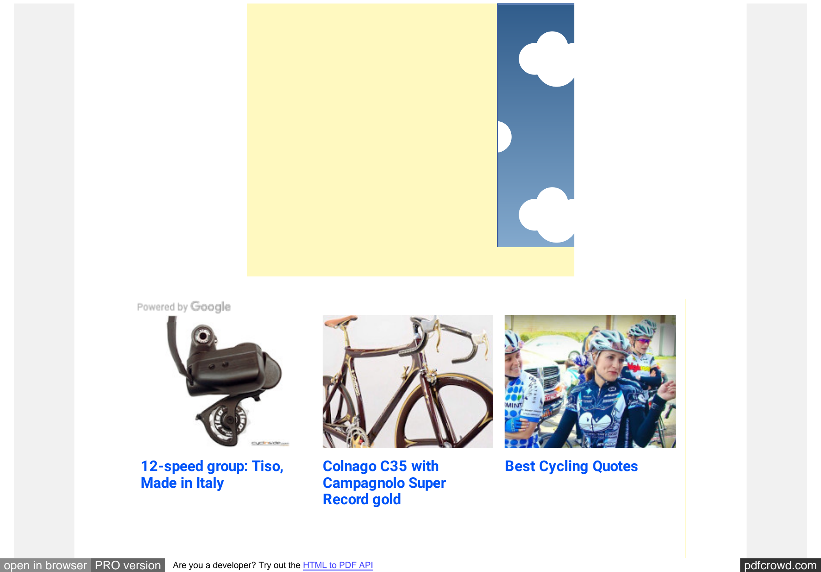
[picture p145: figure]
12-speed group: Tiso, Made in Italy; Colnago C35 with Campagnolo Super Record gold; Best Cycling Quotes

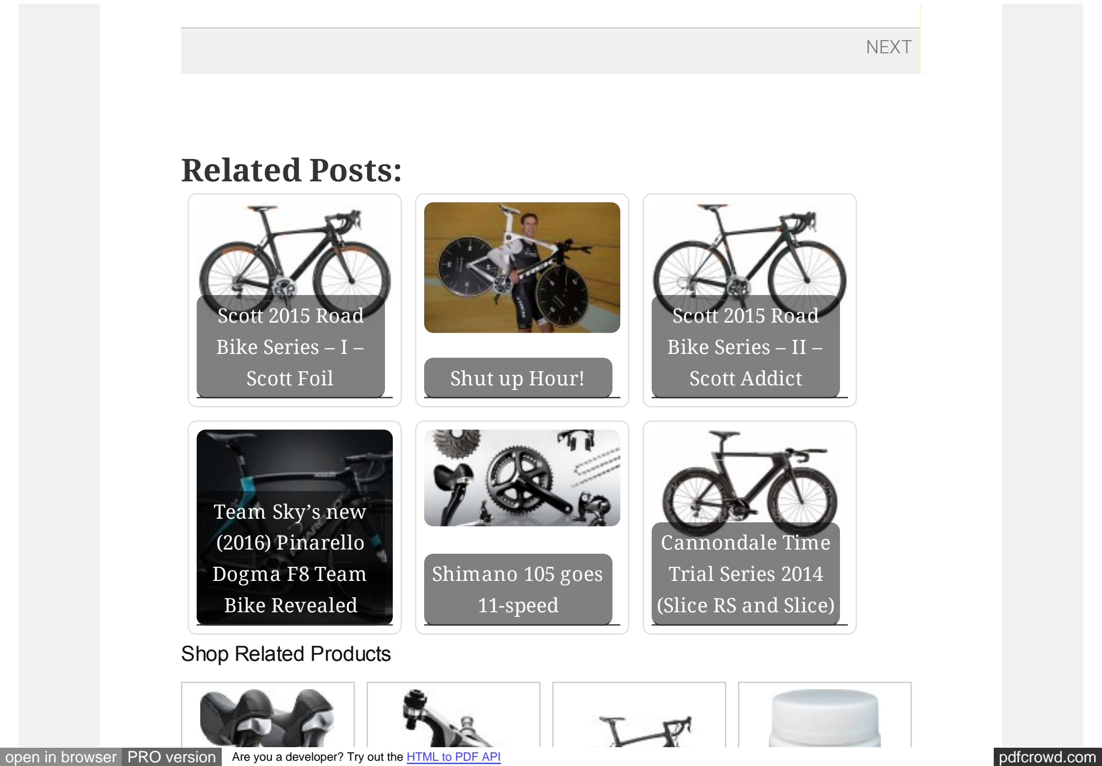
[picture p146: figure]
Related Posts:; NEXT; Scott 2015 Road Bike Series – I –; Scott Foil; Shut up Hour!; Scott 2015 Road Bike Series – II – Scott Addict; Team Sky’s new (2016) Pinarello Dogma F8 Team Bike Revealed; Shimano 105 goes 11-speed; Cannondale Time Trial Series 2014 (Slice RS and Slice); Shop Related Products

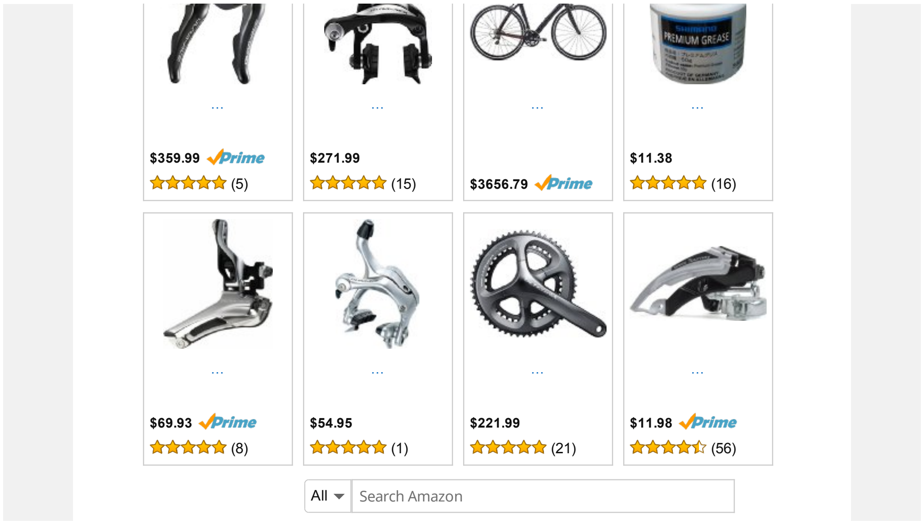
[picture p147: figure]
All; Search Amazon
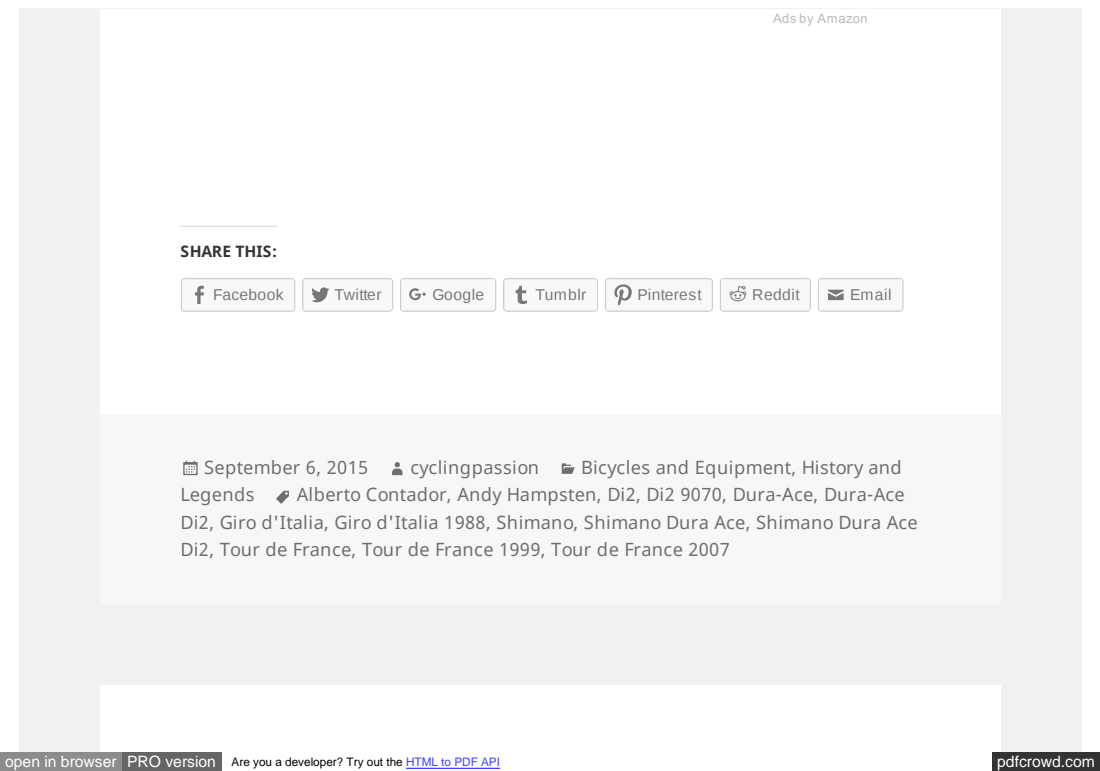
[picture p148: page 28]
Facebook; Twitter; Google; Tumblr; Pinterest; Reddit; Email; September 6, 2015; cyclingpassion; Bicycles and Equipment, History and; Legends; Alberto Contador, Andy Hampsten, Di2, Di2 9070, Dura-Ace, Dura-Ace; SHARE THIS:

Ads by Amazon (http://aax-us-east.amazon-adsystem.com/x/c/QgEzOGGULtGarAgpfsaJHwEAAAFVZL7LjwEAAAFKAWHPnpg/http://www.amazon.com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)

Di2, Giro d'Italia, Giro d'Italia 1988, Shimano, Shimano Dura Ace, Shimano Dura Ace
Di2, (http://cycling-passion.com/tag/shimano-dura-ace-di2/) Tour de France (http://cycling-passion.com/tag/tour-de-france/), (http://cycling-passion.com/tag/shimano-dura-ace-di2/) Tour de France 1999 (http://cycling-passion.com/tag/tour-de-france-1999/), (http://cycling-passion.com/tag/shimano-dura-ace-di2/) Tour de France 2007 (http://cycling-passion.com/tag/tour-de-france-2007/)

## Leave a Reply

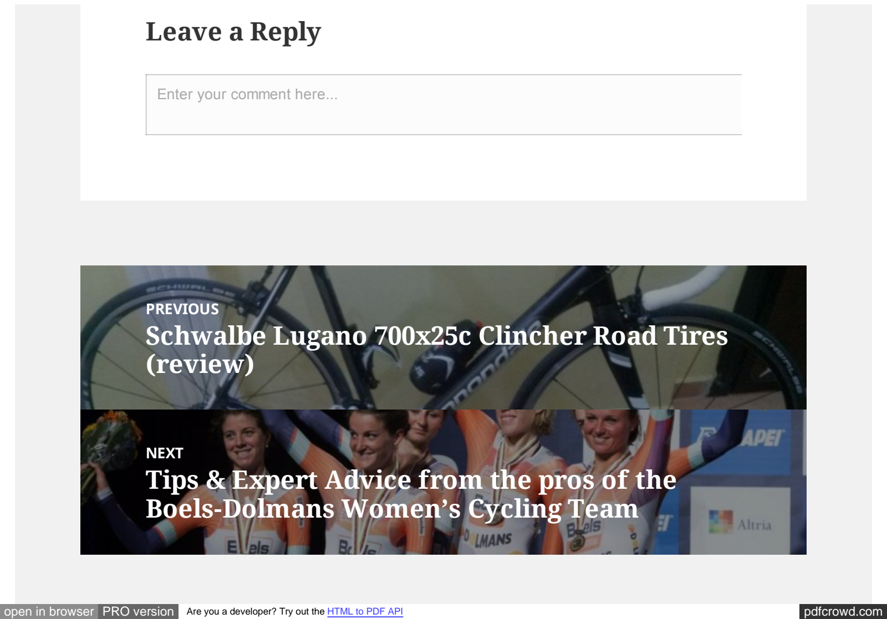
[picture p149: page 29]

Enter your comment here...

PREVIOUS

## Schwalbe Lugano 700x25c Clincher Road Tires

(review) (http://cycling-passion.com/2015/08/08/schwalbe-lugano-700x25c-clincher-road-tires-review/)

NEXT

## Tips & Expert Advice from the pros of the

Boels-Dolmans Women’s Cycling Team (http://cycling-passion.com/2015/09/23/tips-expert-advice-from-the-pros-of-the-boels-dolmans-womens-cycling-team/)

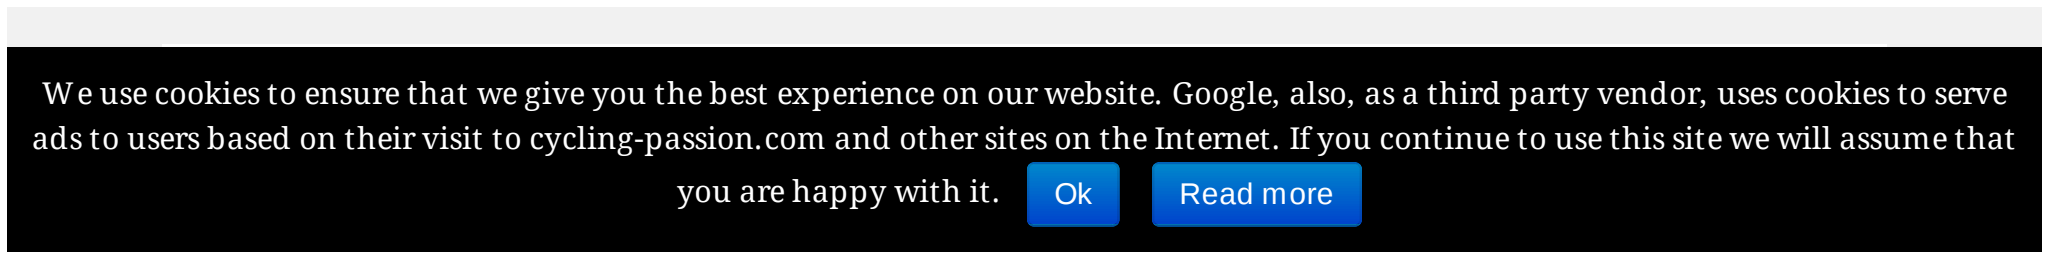
[picture p150: figure]
Proudly powered by WordPress; you are happy with it.; Read more

We use cookies to ensure that we give you the best experience on our website. Google, also, as a third party vendor, uses cookies to serve ads to users based on their visit to cycling-passion.com and (https://wordpress.org/) other sites on the Internet. If you continue to use this site we will assume that
