KarolKaim/-masterThesis/masterThesisWork/EagleProject/connections.pdf

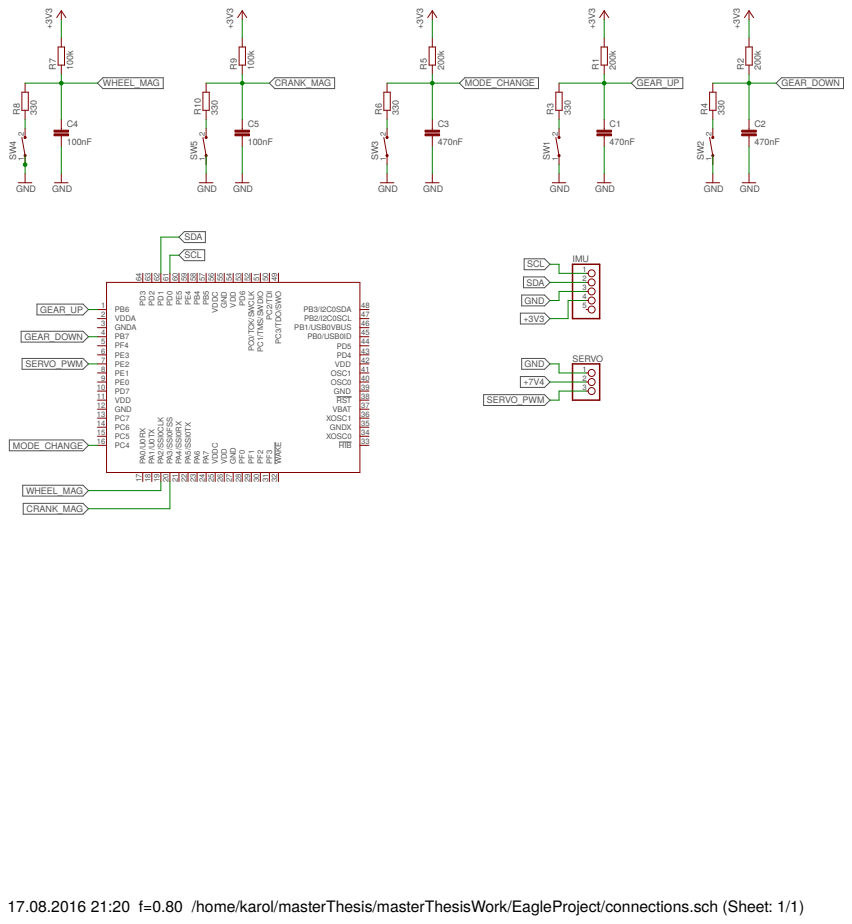
[picture p151: page 1]

17.08.2016 21:20 f=0.80 /home/karol/masterThesis/masterThesisWork/EagleProject/connections.sch (Sheet: 1/1)
