KarolKaim/-masterThesis/masterThesisWork/EagleProject/connections.sch

## EAGLE design masterThesisWork/EagleProject/connections.sch (2016-10-30)

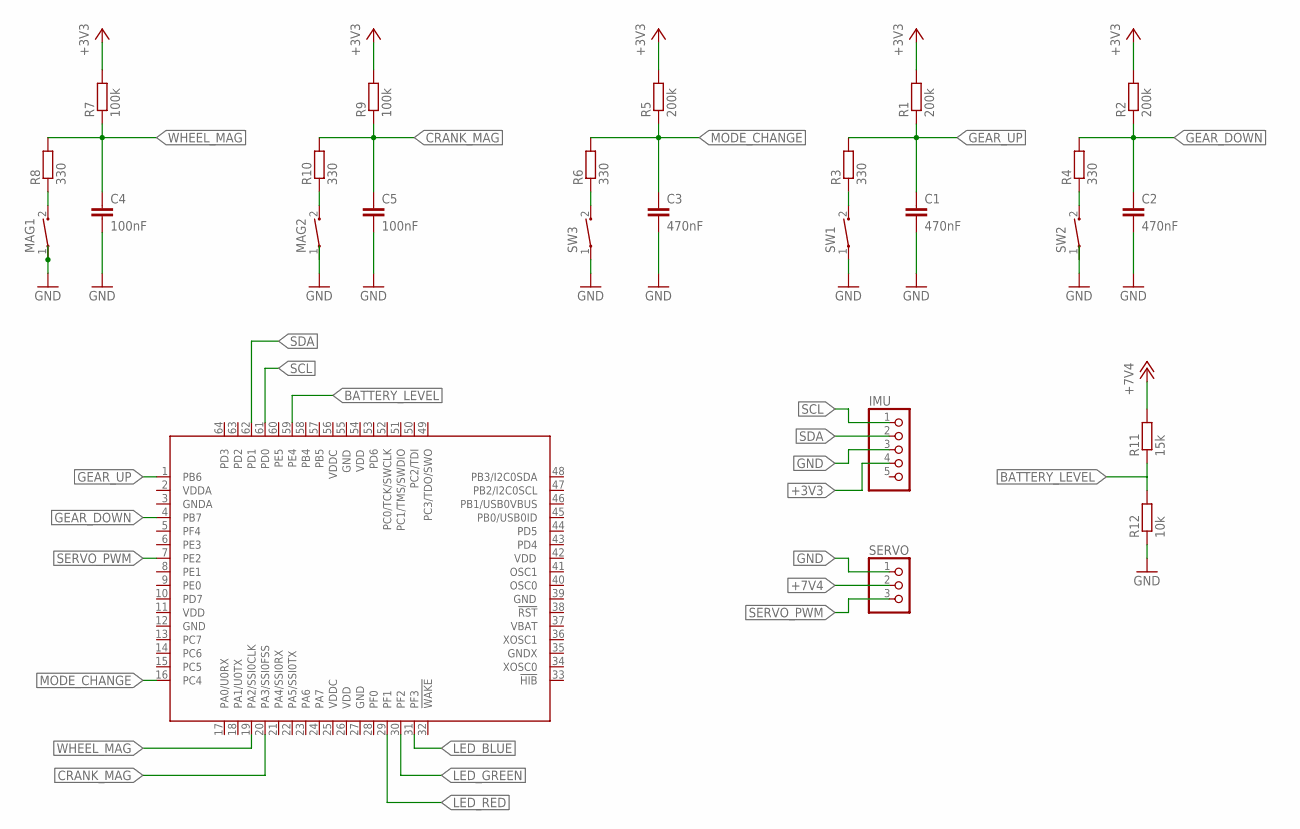
[picture p152: schematic connections.sch]

Parts:
C1, C2, C3: 470nF; C2.5-3
C4, C5: 100nF; C2.5-3
IC1: TM4C123[7,G]XXPM; PM_S-PQFP-G64
IMU: PINHD-1X5; 1X05
MAG1, MAG2: CT10-XXXX-A2
R1, R2, R5: 200k; 0204/5
R3, R4, R6, R8, R10: 330; 0204/5
R7, R9: 100k; 0204/5
R11: 15k; 0204/5
R12: 10k; 0204/5
SERVO: PINHD-1X3; 1X03
SW1, SW2, SW3: CT10-XXXX-A2

Connections:
+3V3: IMU.4, R1.2, R2.2, R5.2, R7.2, R9.2
+7V4: R11.2, SERVO.2
BATTERY_LEVEL: IC1.59 (PE4), R11.1, R12.2
CRANK_MAG: C5.1, IC1.20 (PA3/SSI0FSS), R9.1, R10.2
GEAR_DOWN: C2.1, IC1.4 (PB7), R2.1, R4.2
GEAR_UP: C1.1, IC1.1 (PB6), R1.1, R3.2
GND: C1.2, C2.2, C3.2, C4.2, C5.2, IMU.3, MAG1.1, R12.1, SERVO.1, SW1.1, SW3.1
LED_BLUE: IC1.31 (PF3)
LED_GREEN: IC1.30 (PF2)
LED_RED: IC1.29 (PF1)
MODE_CHANGE: C3.1, IC1.16 (PC4), R5.1, R6.2
unnamed: R3.1, SW1.2
unnamed: R4.1, SW2.2
unnamed: R6.1, SW3.2
unnamed: MAG1.2, R8.1
unnamed: MAG2.2, R10.1
SCL: IC1.61 (PD0), IMU.1
SDA: IC1.62 (PD1), IMU.2
SERVO_PWM: IC1.7 (PE2), SERVO.3
WHEEL_MAG: C4.1, IC1.19 (PA2/SSI0CLK), R7.1, R8.2
