KarolKaim/-masterThesis/AutomaticGearShiffter/src/GpioInterruptHandlers.c

#include "GpioInterruptHandlers.h"

#include "inc/hw_ints.h"
#include "inc/hw_memmap.h"
#include "driverlib/gpio.h"
#include "driverlib/interrupt.h"
#include "driverlib/pin_map.h"
#include "driverlib/sysctl.h"

#include "MagneticSensors.h"
#include "SwitchGear.h"
#include "DerailleurController.h"
#include "TimerInterruptHandlers.h"

/*
 *  GPIO Input pins:
 *
 *  GPIO_A2 - wheel magnet
 *  GPIO_A4 - crank magnet
 *  GPIO_B0 - gear Up switch
 *  GPIO_B1 - gear down switch
 *  GPIO_C4 - gear mode switch
 *  GPIO_E4 - battery level ADC AIN9
 *
 *  GPIO Output pins:
 *  GPIO_C5 - RBG indication
 *  GPIO_C6 - RBG indication
 *  GPIO_C7 - RBG indication
 *  GPIO_D0 - I2C SCL
 *  GPIO_D1 - I2D SDA
 *  GPIO_E2 - servo control
 *
 */

void gpioPortA(void) {
	uint32_t status = clearGpioInt(GPIO_PORTA_BASE);
	if ((status & GPIO_PIN_2) == GPIO_PIN_2) {
		handleWheelMagnetInt();
	} else if ((status & GPIO_PIN_4) == GPIO_PIN_4) {
		handleCrankMagnetInt();

	}
}

void gpioPortB(void) {
	uint32_t status = clearGpioInt(GPIO_PORTB_BASE);
	if ((status & GPIO_PIN_0) == GPIO_PIN_0 && currentMode != comfort) {
		reduceGear();
	} else if ((status & GPIO_PIN_1) == GPIO_PIN_1 && currentMode != comfort) {
		increaseGear();
	}
	turnOnConitnousChangeTimer();
	if(currentMode == active || currentMode == sport)
	{
		gearChangedManualy = true;
	}
}

void gpioPortC(void) {
	uint32_t status = clearGpioInt(GPIO_PORTC_BASE);

	if ((status & GPIO_PIN_4) == GPIO_PIN_4) {
		changeCurrentGearMode();
	}
}

void gpioPortF(void) {
	uint32_t status = clearGpioInt(GPIO_PORTF_BASE);

	if ((status & GPIO_PIN_0) == GPIO_PIN_0) {
		changeCurrentGearMode();
	}
}

uint32_t clearGpioInt(uint32_t intPort) {
	uint32_t status = 0;
	status = GPIOIntStatus(intPort, true);
	GPIOIntClear(intPort, status);
	return status;
}

void initializeGpioAsSwitch(uint32_t portClk, uint32_t gpioPort, uint8_t pins,
		uint32_t intType, uint32_t portInt) {
	SysCtlPeripheralEnable(portClk);
	GPIOPinTypeGPIOInput(gpioPort, pins);
	GPIOIntTypeSet(gpioPort, pins, intType);
	GPIOIntEnable(gpioPort, pins);
	IntEnable(portInt);

}

void turnOffGPIO(uint32_t gpioPort, uint8_t pins) {
	GPIOIntDisable(gpioPort, pins);
}

void turnOnGPIO(uint32_t gpioPort, uint8_t pins) {
	GPIOIntEnable(gpioPort, pins);
}
