KarolKaim/-masterThesis/AutomaticGearShiffter/main.c

#include <stdbool.h>
#include <stdint.h>

#include "inc/hw_memmap.h"
#include "driverlib/sysctl.h"
#include "driverlib/gpio.h"
#include "Imu.h"
#include "SwitchGear.h"
#include "MagneticSensors.h"
#include "UartLogger.h"
#include "DerailleurController.h"
#include "TimerInterruptHandlers.h"
#include "RGBIndicator.h"
#include "BatteryChecker.h"

int main(void) {

	SysCtlClockSet(SYSCTL_SYSDIV_10 | SYSCTL_USE_PLL | SYSCTL_OSC_MAIN |
	SYSCTL_XTAL_16MHZ);
	initialzeComfModeAndContChangeTimers();
	initializeActiveAndSportModeTimers();
	initializeSportModeAccelReadingsAndPosChange();

	initializeMagneticSensors();
	initializeImu();
	initializeGearController();
	initializeSwitches();
	initializeUart(115200);
	initialzeRgbAndBatteryLevelCheckTimers();
	//initializeBatteryLevelCheck();
	initializeRGBIndicator();

	currentMode = active;
	changeCurrentGearMode();
	turnOnAccelReadingsTimer();

	while (true) {
		if (sportModeTimerDone) {
			sportModeTimerDone = false;
			if (currentMode == sport)
				computeSteepness();
			sendSystemData();

		}
	}
	return 0;
}
