KarolKaim/-masterThesis/(commit log)

2016-02-20 Added new eclipse project created in CCS. Tested on board.
2016-02-25 Added cadence sensor DIY
2016-02-28 Added new materials regarding mathematical model. Also added presentation for diploma seminar.
2016-03-14 Added SwitchGear files. Also changed project, now includes Include folder for local headers
2016-04-04 Added basic handler for Magnetic sensors
2016-04-11 Added correct handler for magnetic sensor.
    [GpioInterruptHandlers.c, GpioInterruptHandlers.h, SwitchGear.c, TimerInterruptHandlers.c, TimerInterruptHandlers.h, main.c, tm4c123gh6pm_startup_ccs_gcc.c]
2016-04-25 Added UART handler and Reading from accelerometer functionality
2016-05-08 Integration part 2 - still does not work !
    [DerailleurController.c, TimerInterruptHandlers.c]
2016-05-26 Added sth in main.c and Imu.c
2016-07-04 Refactor of code. Aligment to latest GPIO convenion. Deletion of unsed timers for bouncing problem
    [SwitchGear.c, SwitchGear.h, TimerInterruptHandlers.c, main.c, tm4c123gh6pm_startup_ccs_gcc.c]
2016-07-04 Fixed bug with crank timer interval
    [TimerInterruptHandlers.c]
2016-07-10 Changed the way servo is controlled. now its finally works as should
2016-07-14 Another modification of chapter 2. Added content of Velocity measurement and accelerometer sections
2016-07-16 Added accelerometer part
2016-07-18 Change in main and changed PI definition in MagneticSensors.c
2016-07-29 Chapter 4 + 3DDrawings directory and files in it
    [Lacznik.fcstd, Servo.fcstd, wszystko.fcstd]
2016-08-01 Big changes, added sport and active modes, generally few bugs may appear
    [DerailleurController.c, DerailleurController.h, GpioInterruptHandlers.c, GpioInterruptHandlers.h, Imu.c, Imu.h, RGBIndicator.c, RGBIndicator.h]
2016-08-01 Complementary filter chapter3 part and retalted documents
2016-08-02 Fixed complementary filter
2016-08-04 Added chapter2 changes including complementary filter
2016-08-07 Complementary filter part added
2016-08-14 Added changed to chapter 4 - something about servo control and switches
2016-08-23 Added battery checker code
2016-08-23 Added chapter 4 part about controller, voltage divider
    [connections.sch]
2016-10-08 Added some changes to code. Sending uart, modified filter settings, small refactor
2016-10-22 Chapter 2 - added part about gears systems offered on market
2016-10-23 Another part of chapter 2 - about MTB drivetrains this time
2016-10-30 Another set of modifications
    [connections.sch]
